DullesRobotics/ComputerAidedDesign/2021-22/FTC/#13822 Robovikes/Pictures/Drivetrain_Final_Assembly_Left.bmp

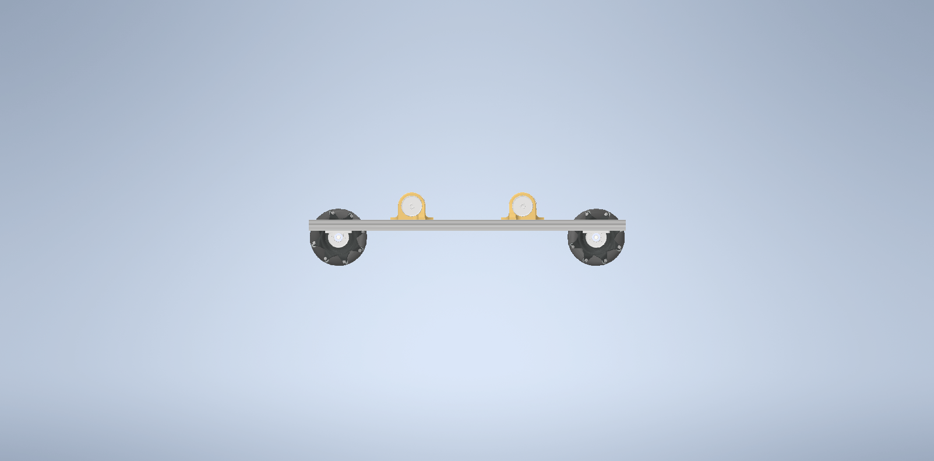
2021-22/FTC/#13822 Robovikes/Pictures/Drivetrain_Final_Assembly_Left.bmp
