DullesRobotics/ComputerAidedDesign/README.md

# ComputerAidedDesign
Anything and everything related to computer aided design
