DullesRobotics/ComputerAidedDesign/2021-22/FTC/#13822 Robovikes/Duck Carousel/Duck Carousel Isometric.jpg

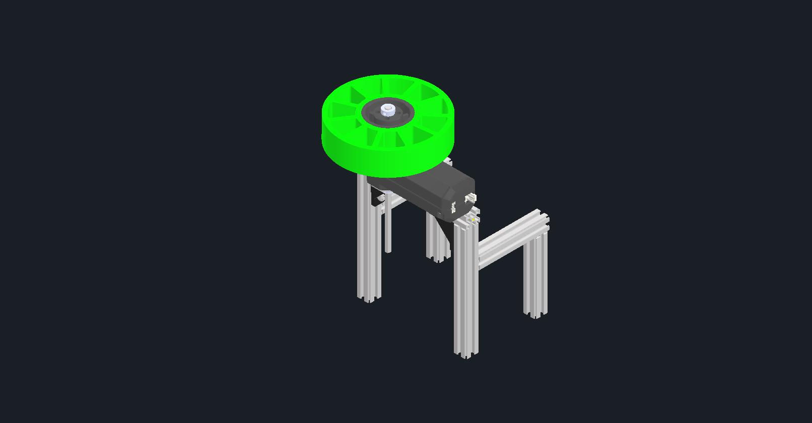
2021-22/FTC/#13822 Robovikes/Duck Carousel/Duck Carousel Isometric.jpg
