DullesRobotics/ComputerAidedDesign/2021-22/FTC/#13822 Robovikes/Duck Carousel/Duck Carousel Top.jpg

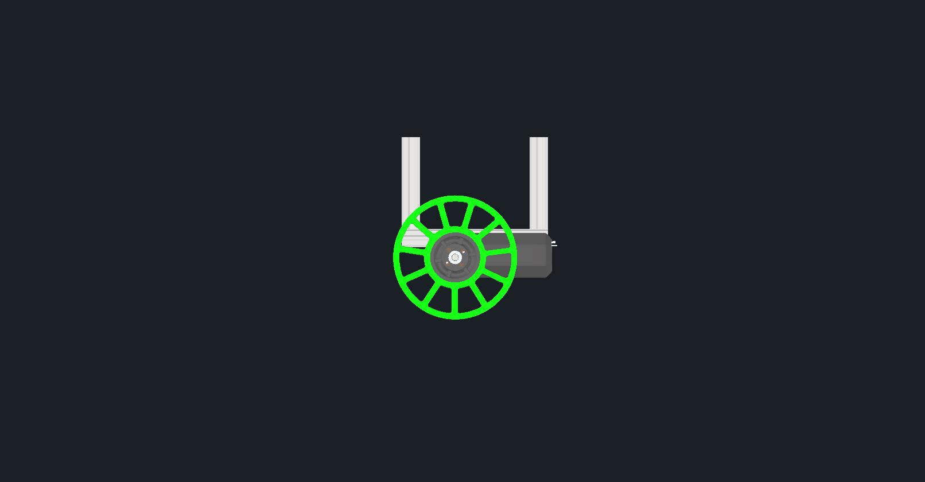
2021-22/FTC/#13822 Robovikes/Duck Carousel/Duck Carousel Top.jpg
