DullesRobotics/ComputerAidedDesign/2021-22/FTC/#13822 Robovikes/Intake/Intake Isometric.jpg

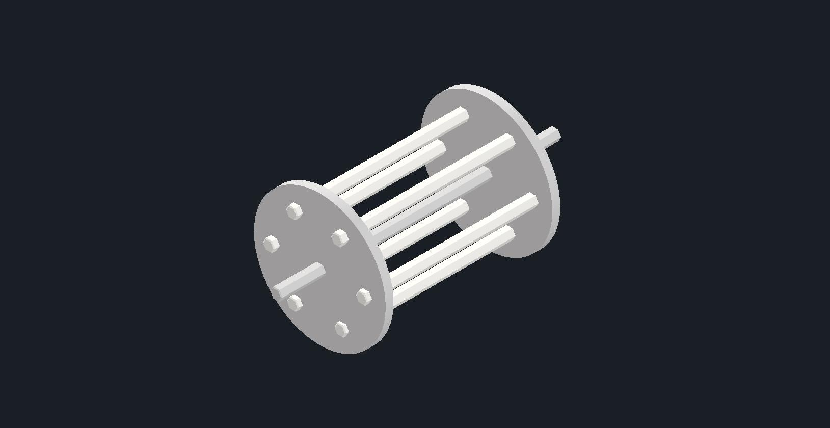
2021-22/FTC/#13822 Robovikes/Intake/Intake Isometric.jpg
