DullesRobotics/ComputerAidedDesign/2021-22/FTC/#13822 Robovikes/Pictures/Drivetrain_Drawing.jpg

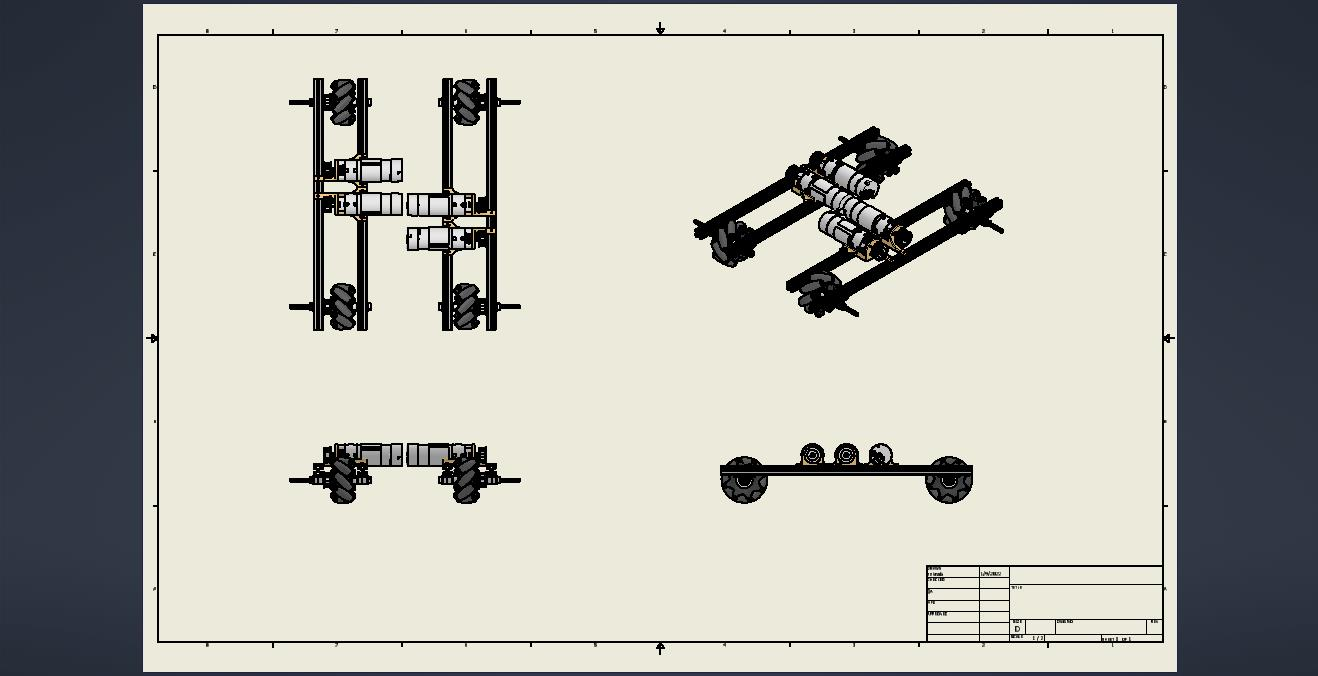
2021-22/FTC/#13822 Robovikes/Pictures/Drivetrain_Drawing.jpg
