DullesRobotics/ComputerAidedDesign/2021-22/FTC/#13822 Robovikes/Sketches and Whiteboarding/Carousel Design.png

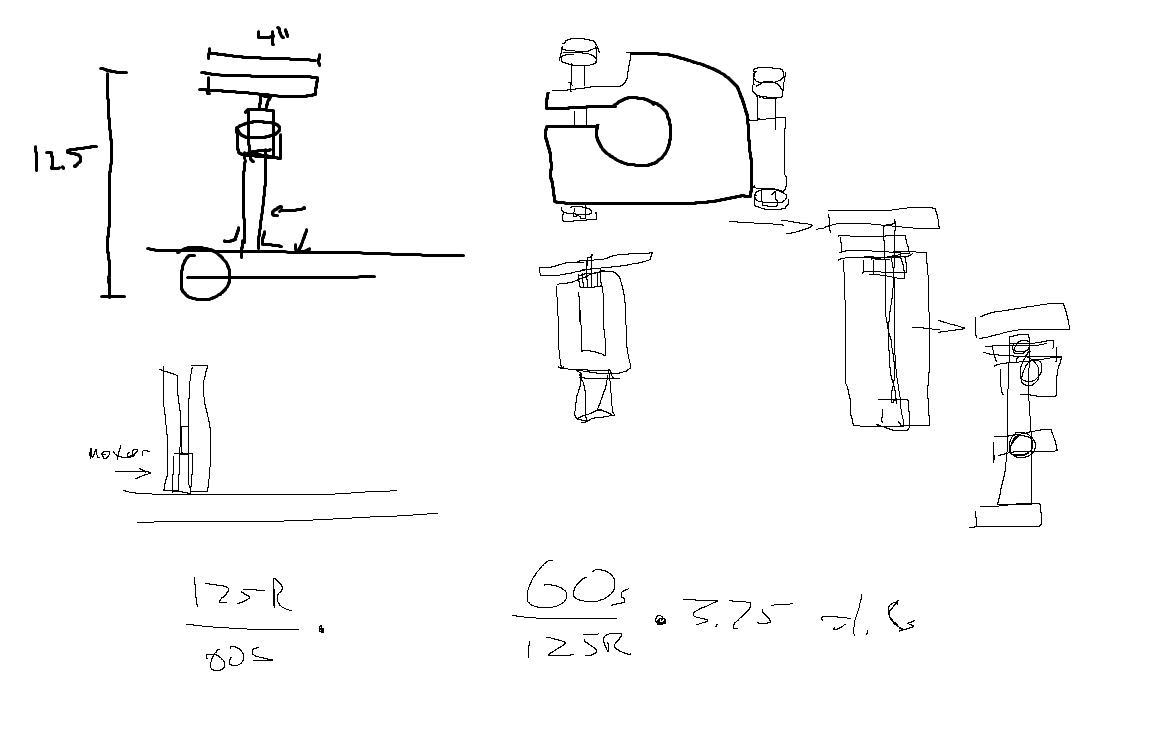
2021-22/FTC/#13822 Robovikes/Sketches and Whiteboarding/Carousel Design.png
