DullesRobotics/ComputerAidedDesign/2021-22/FTC/Parts/AndyMark/am-3684 45t NR Pinion Gear Assembly.STEP

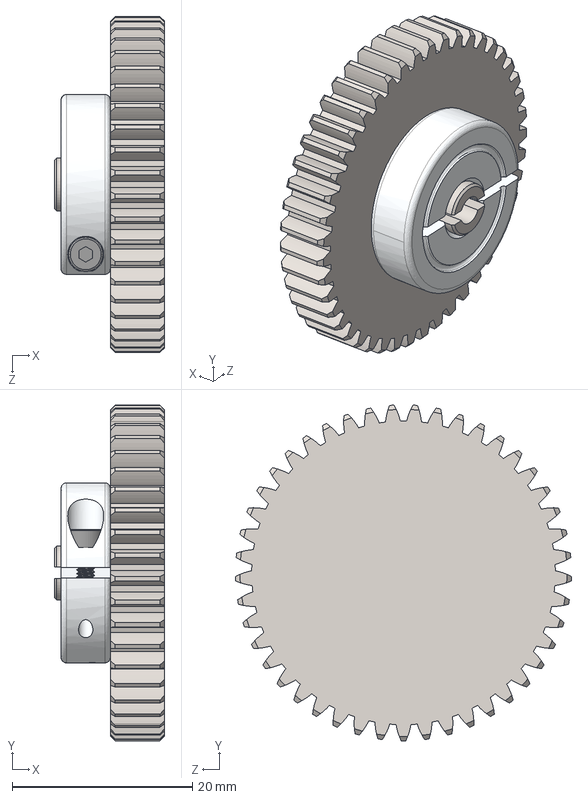
[picture p10: CAD file, 2021-09-24]
2021-22/FTC/Parts/AndyMark/am-3684 45t NR Pinion Gear Assembly.STEP
12.2 x 37.3 x 37.3 mm
45T 32DP 20PA NR Pinion Gear
ENCL20-6MM-A
