DullesRobotics/ComputerAidedDesign/2021-22/FTC/Parts/AndyMark/am-4136 S3 Linear Motion Kit - Single Bearing Assembly.STEP

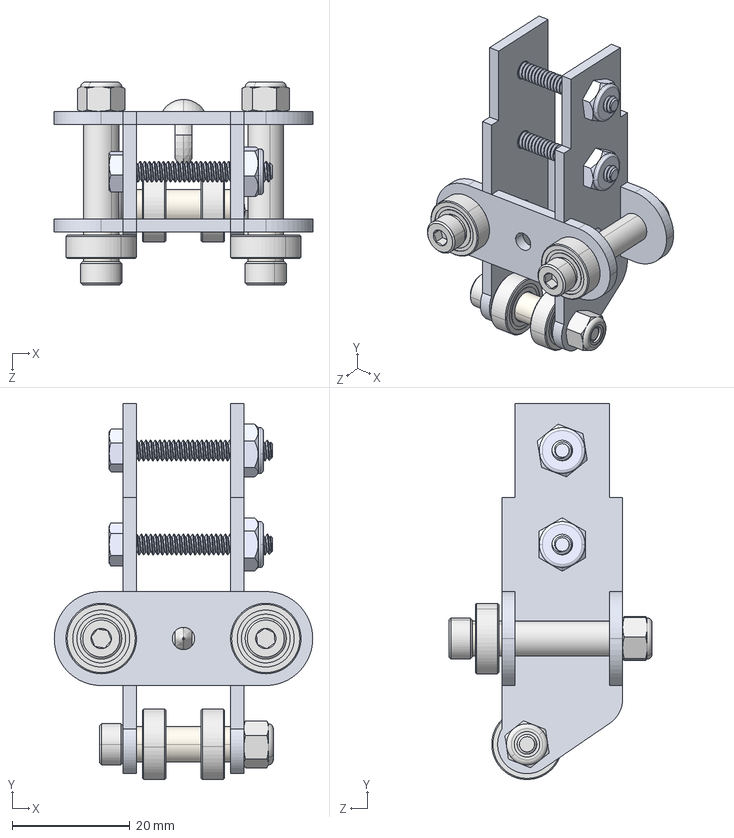
[picture p11: CAD file, 2021-09-24]
2021-22/FTC/Parts/AndyMark/am-4136 S3 Linear Motion Kit - Single Bearing Assembly.STEP
44.0 x 64.0 x 34.6 mm
Bearing Support Bracket x 2
93657A022_NYLON UNTHREADED SPACER_93657A022
6mm x 12mm Non-Flanged_7804K142 x 4
90128A217_ZNC-PLTD ALLOY STL SCKT HEAD CAP SCREW_90128A217
90576A103_ZINC-PLATED CLASS 8 STL NYLON-INSERT LOCKNUT_90576A103 x 3
Tee Bearing Plate x 2
94669A022_ALUM UNTHRD SPACER_94669A022 x 2
90128A219_ZNC-PLTD ALLOY STL SCKT HEAD CAP SCREW_90128A219 x 2
93657A008_NYLON UNTHREADED SPACER_93657A008 x 2
am-1504 S3 Push in Rivet_90218A114
6-32 x 1000 HHCS_93075A153 x 2
6-32 Nylock Jam Nut x 2
