DullesRobotics/ComputerAidedDesign/2021-22/FTC/Parts/AndyMark/am-0293 Shift Block and Shaft Asm.STEP

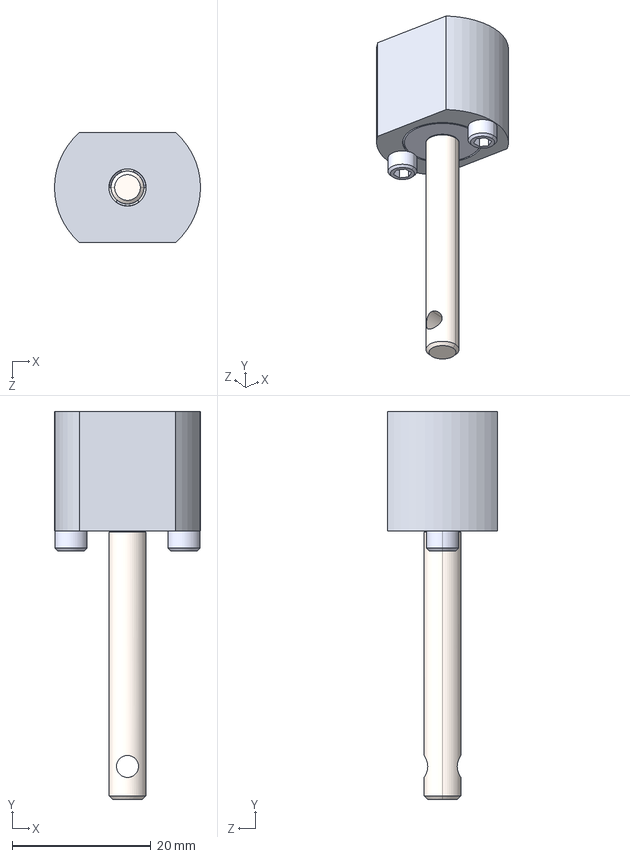
[picture p12: CAD file, 2021-09-24]
2021-22/FTC/Parts/AndyMark/am-0293 Shift Block and Shaft Asm.STEP
21.1 x 56.0 x 15.9 mm
am-0124 Shift Block
am-0170 Shifter Shaft
R3 Bearing
4-40x0500_shcs_smart x 2
0.1875 e-clip_97431A280
