DullesRobotics/ComputerAidedDesign/2021-22/FTC/Parts/AndyMark/am-3964 AM14U4 Vertical Battery Mount Assembly.STEP

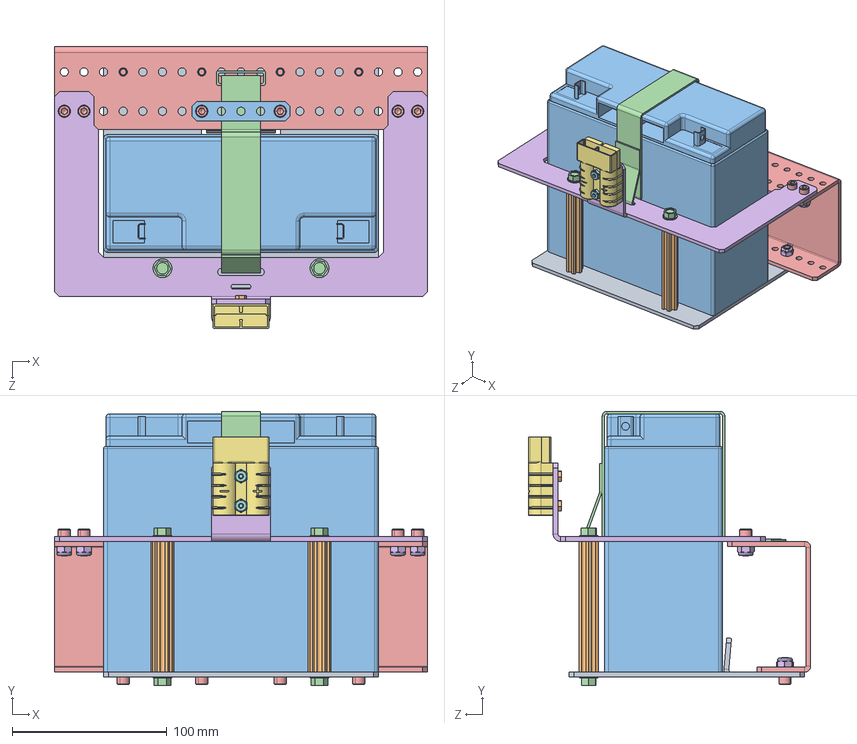
[picture p13: CAD file, 2021-09-24]
2021-22/FTC/Parts/AndyMark/am-3964 AM14U4 Vertical Battery Mount Assembly.STEP
241.3 x 177.5 x 182.8 mm
AM14U3 Battery Floor Plate
3.375in Churro x 2
battery
FHTS 0.25-20-0.75_FHTS 0.25-20-G-0.75-C x 4
10-32x0500_shcs_HX-SHCS 0.19-32x1.375x1-C x 10
10-32 Nylock Nut x 10
Anderson SB50
6-32 Nylock Jam Nut x 2
6-32 x 0750 HHCS_93075A151 x 2
AM14U3 Battery Strap Clamp
Battery Strap
Short End Sheet for Battery Tray
AM14U3 BR19 Battery C Plate
