DullesRobotics/ComputerAidedDesign/2021-22/FTC/Parts/AndyMark/am-0247 GEM Stage 1 assy Rev2.STEP

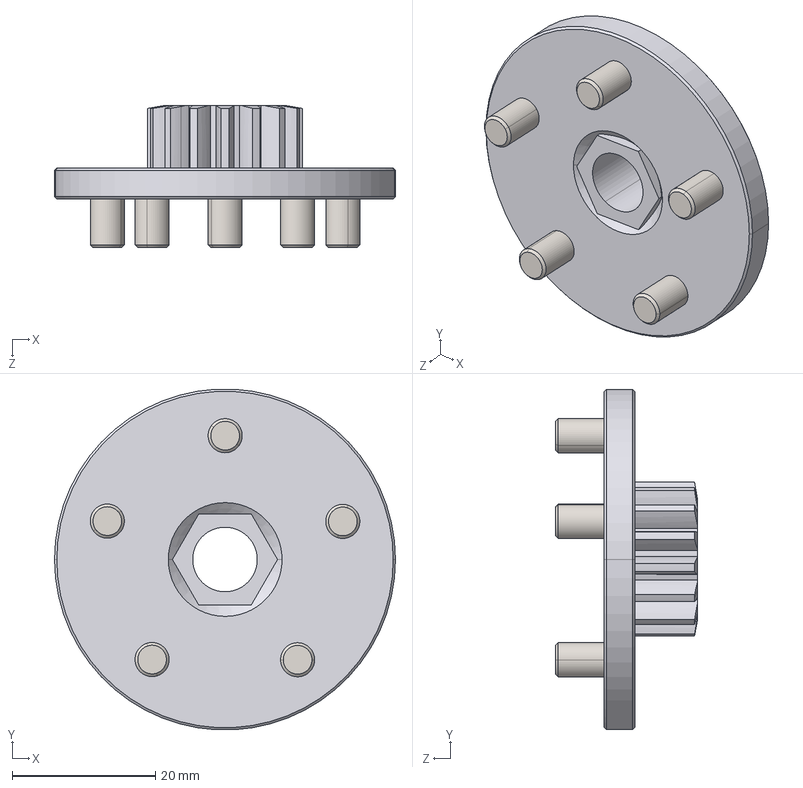
[picture p14: CAD file, 2021-09-24]
2021-22/FTC/Parts/AndyMark/am-0247 GEM Stage 1 assy Rev2.STEP
47.6 x 47.5 x 19.9 mm
GEM Carrier Plate
GEM Dowel x 5
GEM SUN Gear 15t
