DullesRobotics/ComputerAidedDesign/2021-22/FTC/Parts/AndyMark/am-3683 40t NR Pinion Gear Assembly.STEP

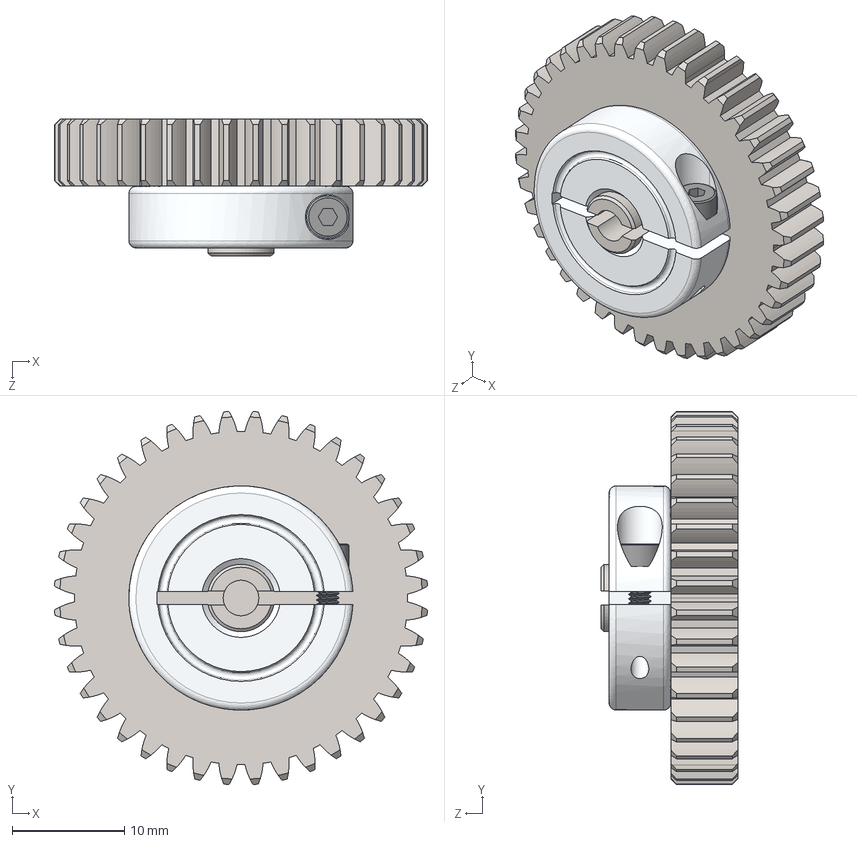
[picture p15: CAD file, 2021-09-24]
2021-22/FTC/Parts/AndyMark/am-3683 40t NR Pinion Gear Assembly.STEP
33.3 x 33.3 x 12.2 mm
dv-9735 40T 32DP 20PA With 0125in Bore Pinion Gear
ENCL20-6MM-A
