DullesRobotics/ComputerAidedDesign/2021-22/FTC/Parts/AndyMark/am-3933 8IN HD Pneumatic Wheel Hub Assembly 1.125 Bearing Bore.STEP

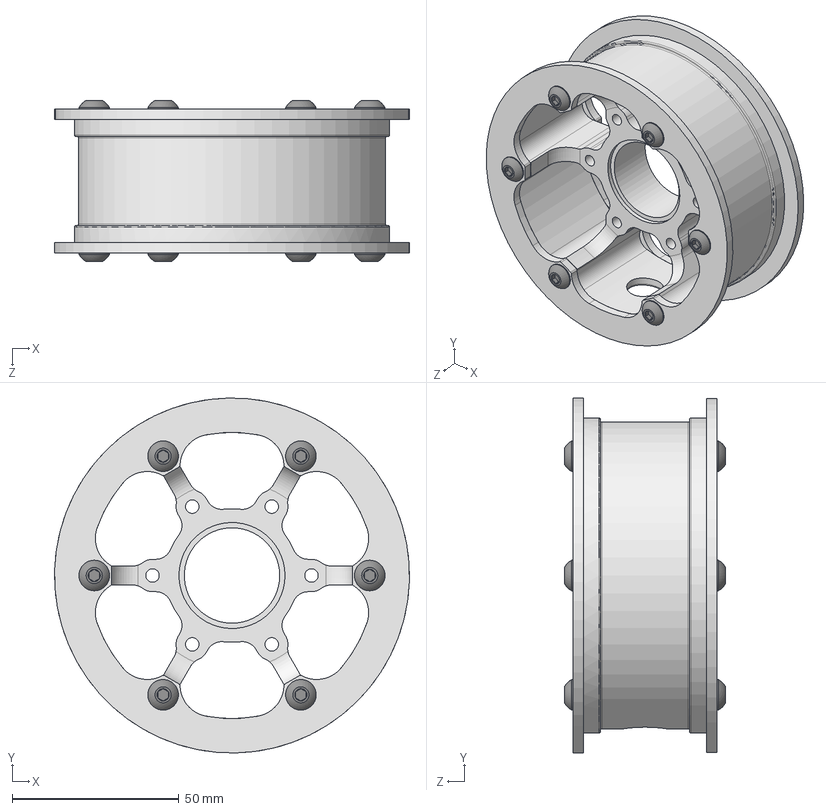
[picture p16: CAD file, 2021-09-24]
2021-22/FTC/Parts/AndyMark/am-3933 8IN HD Pneumatic Wheel Hub Assembly 1.125 Bearing Bore.STEP
106.4 x 106.3 x 48.3 mm
Aluminum 8IN Pneumatic Wheel Core
Aluminum 8IN Pneumatic Wheel Rim x 2
BHCS 10-32 x 0.500_91255A265 x 12
