DullesRobotics/ComputerAidedDesign/2021-22/FTC/Parts/AndyMark/am-2600b FTC Perimeter Corner Assembly.STEP

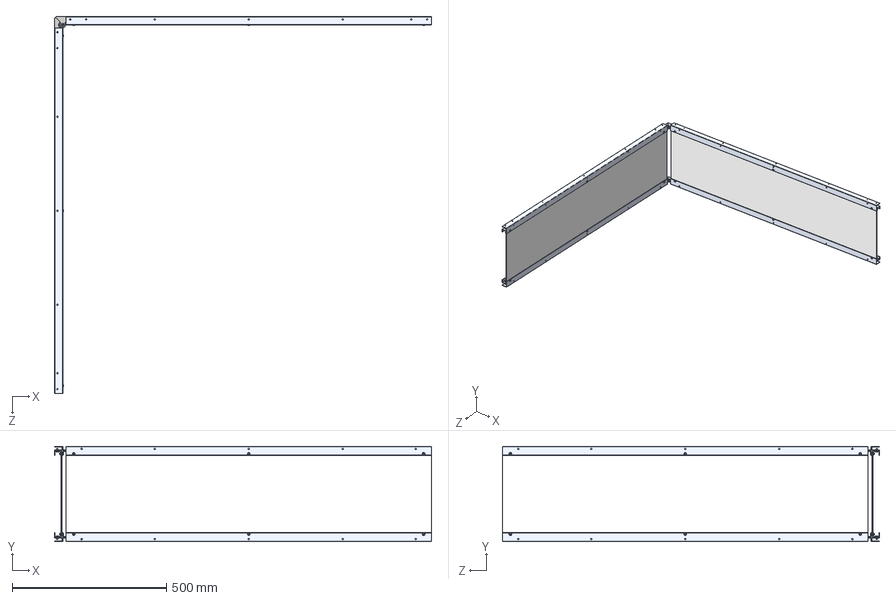
[picture p17: CAD file, 2021-09-24]
2021-22/FTC/Parts/AndyMark/am-2600b FTC Perimeter Corner Assembly.STEP
1222.6 x 309.6 x 1222.6 mm
am-2556 FTC Rail x 4
FTC Field Side Glass 11in x 2
187 pop rivet x 22
Corner Knife Hinge half_DefaultSM-FLAT-PATTERN x 2
am-2589 Corner Knife Hinge half x 2
