DullesRobotics/ComputerAidedDesign/2021-22/FTC/Parts/AndyMark/am-3038 SSS Shift Shaft Assembly REV2.STEP

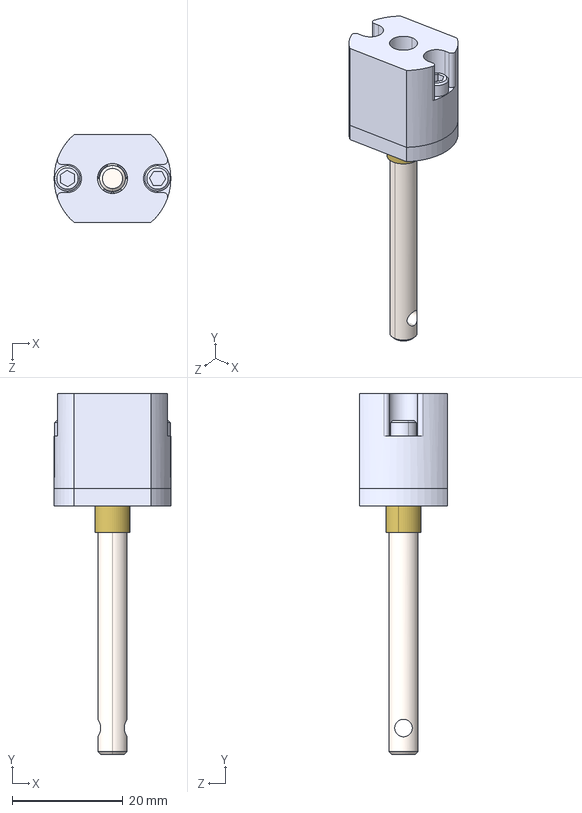
[picture p18: CAD file, 2021-09-24]
2021-22/FTC/Parts/AndyMark/am-3038 SSS Shift Shaft Assembly REV2.STEP
21.1 x 65.2 x 15.9 mm
Shift Block 2
Shift Cap
Shifter Shaft Rev1 3CIM Shifter
0.1875 e-clip_97431A280
R3 Bearing_smart
4-40x0250_shcs_smart x 2
Shift Shaft Spacer am-0300
