DullesRobotics/ComputerAidedDesign/2021-22/FTC/Parts/AndyMark/am-0293 Shift Block and Shaft Assembly.STEP

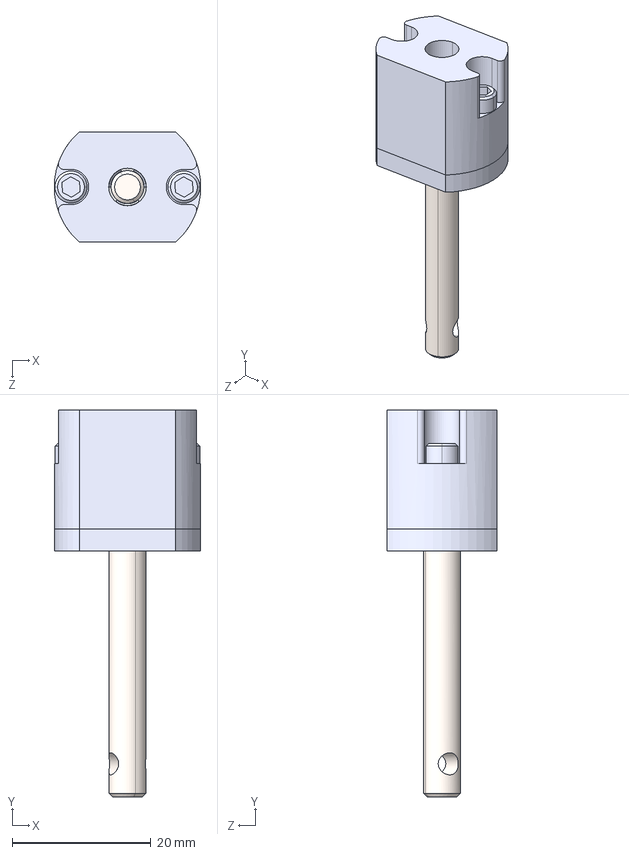
[picture p19: CAD file, 2021-09-24]
2021-22/FTC/Parts/AndyMark/am-0293 Shift Block and Shaft Assembly.STEP
21.1 x 55.7 x 15.9 mm
Shift Block 2
Shift Cap
am-0170 Shifter Shaft Rev1
0.1875 e-clip_97431A280
R3 Bearing_smart
4-40x0250_shcs_smart x 2
