DullesRobotics/ComputerAidedDesign/2021-22/FTC/Parts/AndyMark/am-3968 S3 Linear Motion Main Bracket.STEP

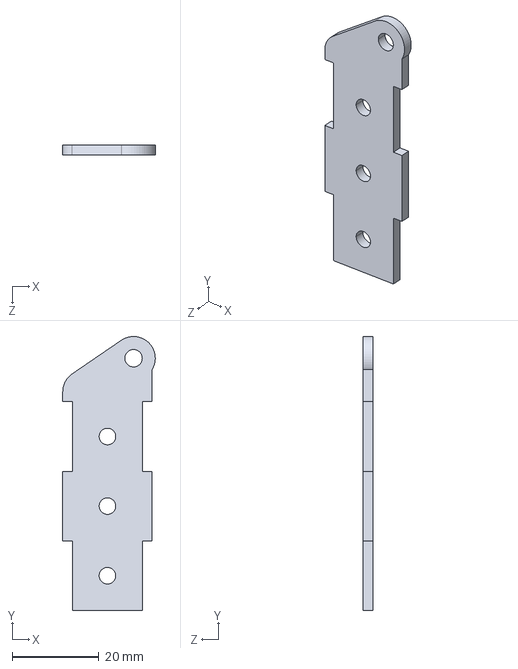
[picture p20: CAD file, 2021-09-24]
2021-22/FTC/Parts/AndyMark/am-3968 S3 Linear Motion Main Bracket.STEP
21.3 x 63.0 x 2.29 mm
