DullesRobotics/ComputerAidedDesign/2021-22/FTC/Parts/AndyMark/am-3964a AM14U4 2020 Battery Mount Assembly.STEP

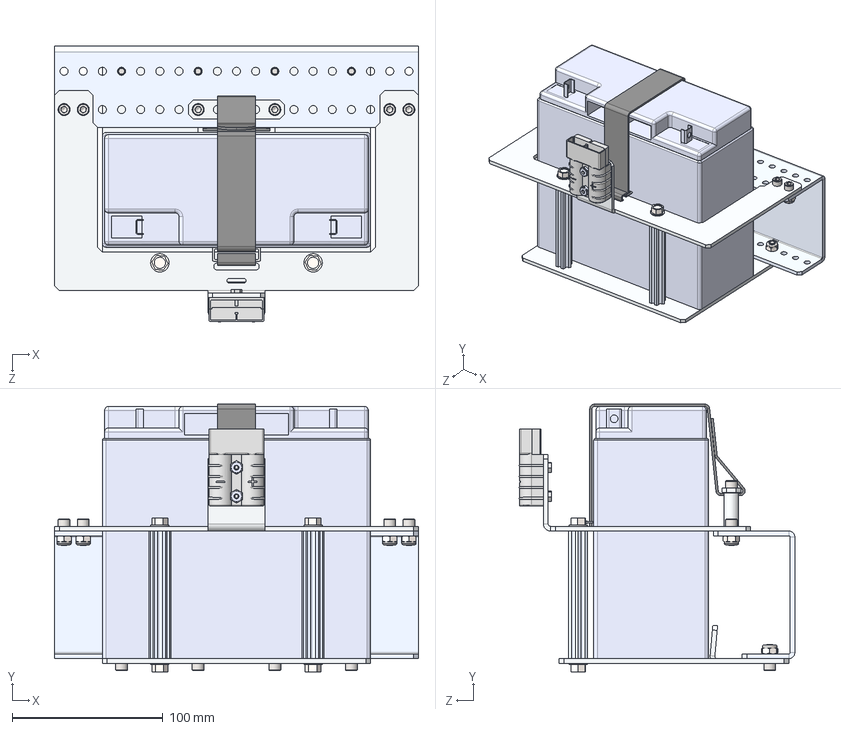
[picture p21: CAD file, 2021-09-24]
2021-22/FTC/Parts/AndyMark/am-3964a AM14U4 2020 Battery Mount Assembly.STEP
241.3 x 177.5 x 182.8 mm
AM14U3 Battery Floor Plate
3.375in Churro x 2
battery
FHTS 0.25-20-0.75_FHTS 0.25-20-G-0.75-C x 4
10-32x0500_shcs_HX-SHCS 0.19-32x1.375x1-C x 8
10-32 Nylock Nut x 10
Anderson SB50
6-32 Nylock Jam Nut x 2
6-32 x 0750 HHCS_93075A151 x 2
Battery Strap V2
Short End Sheet for Battery Tray
AM14U3 BR19 Battery C Plate
am-3876 1000long .192ID Aluminum Spacer x 2
AM14U3 Battery Strap Clamp
10-32x1500_shcs_HX-SHCS 0.19-32x1.375x1-C x 2
