DullesRobotics/ComputerAidedDesign/2021-22/FTC/Parts/AndyMark/am-3682 35t NR Pinion Gear Assembly.STEP

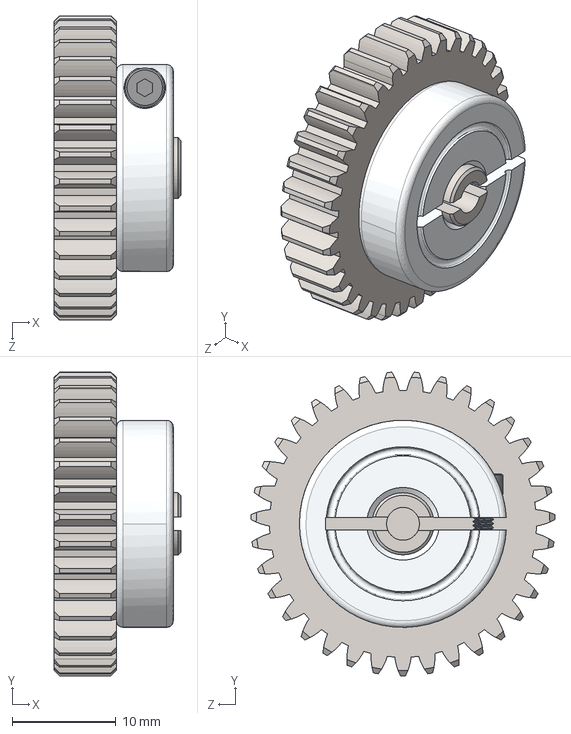
[picture p23: CAD file, 2021-09-24]
2021-22/FTC/Parts/AndyMark/am-3682 35t NR Pinion Gear Assembly.STEP
12.2 x 29.3 x 29.4 mm
35T 32DP 20PA NR Pinion Gear
ENCL20-6MM-A
