DullesRobotics/ComputerAidedDesign/2021-22/FTC/Parts/AndyMark/am-3361R am-3361B Corner Vortex Assembly.STEP

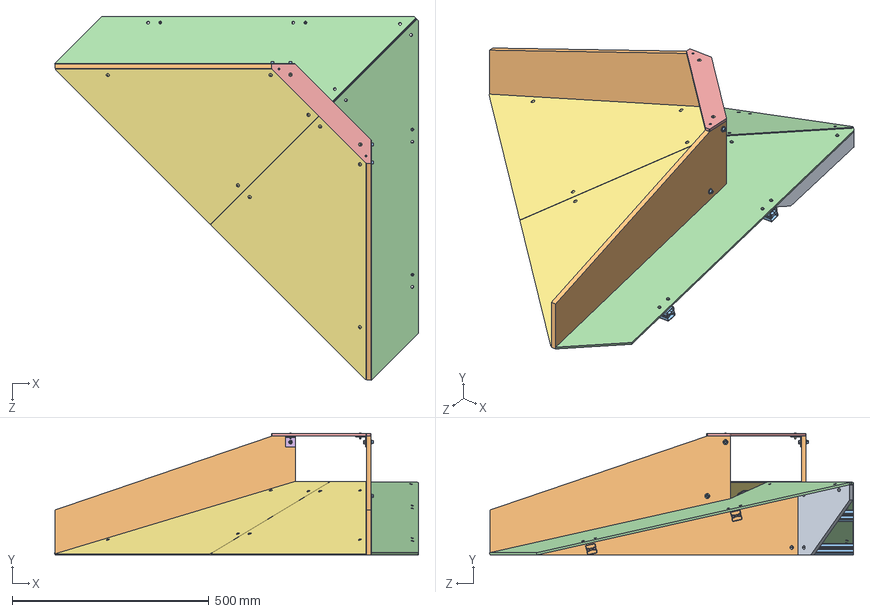
[picture p24: CAD file, 2021-09-24]
2021-22/FTC/Parts/AndyMark/am-3361R am-3361B Corner Vortex Assembly.STEP
924.2 x 309.7 x 924.2 mm
CE Center Spine
CE Main Triangle Support x 2
peanut standoff x 4
CE Ball Return Ramp x 2
CE Goal CrossBar
Bracket 90 - Bolt Bottom x 6
CE ramp Surface half x 2
flat washer type a narrow_ai_Preferred Narrow FW 0.19 x 6
10-32 nylock thin nut - Mcm 90633A009_90633A009 x 8
SHCS 10-32 x 0.75 x 6
10-32x1000_shcs_HX-SHCS 0.19-32x1.375x1-C x 2
FHTS 0.25-20-1_FHTS 0.25-20-F-1.813-C x 8
Bracket 90 - Modified x 4
0125 x 375Rivet x 10
