DullesRobotics/ComputerAidedDesign/2021-22/FTC/Parts/AndyMark/am-2469 6in pneumatic wheel hub assembly.STEP

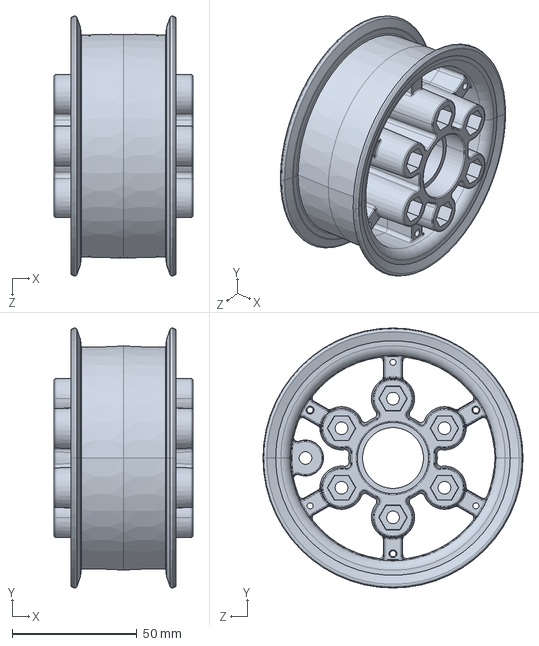
[picture p25: CAD file, 2021-09-24]
2021-22/FTC/Parts/AndyMark/am-2469 6in pneumatic wheel hub assembly.STEP
55.6 x 104.2 x 104.2 mm
6 Hub x 2
