DullesRobotics/ComputerAidedDesign/2021-22/FTC/Parts/AndyMark/am-3934 8IN HD Pneumatic Wheel Hub Assembly 500IN Hex Bore.STEP

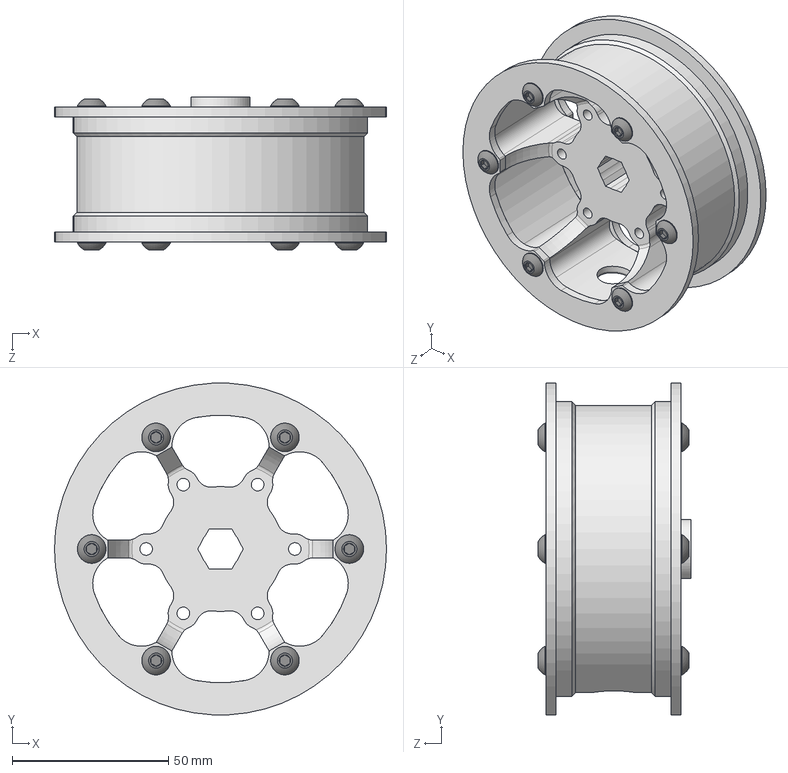
[picture p26: CAD file, 2021-09-24]
2021-22/FTC/Parts/AndyMark/am-3934 8IN HD Pneumatic Wheel Hub Assembly 500IN Hex Bore.STEP
106.4 x 106.2 x 48.9 mm
Aluminum 8IN Pneumatic Wheel 500IN Hex BoreCore
Aluminum 8IN Pneumatic Wheel Rim x 2
BHCS 10-32 x 0.500_91255A265 x 12
