DullesRobotics/ComputerAidedDesign/2021-22/FRC/STL Files/FRC Pit Hookv3.stl

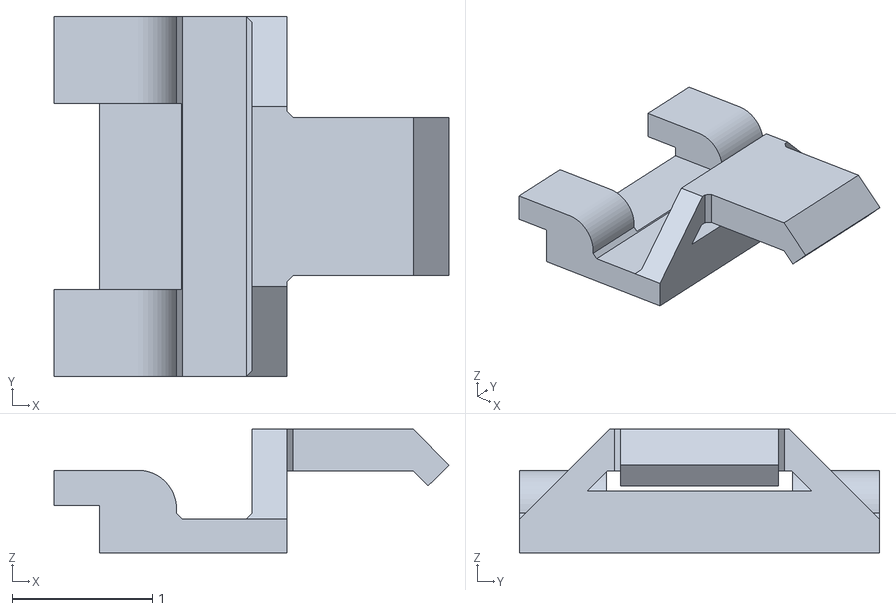
[picture p27: CAD file, 2021-10-08]
2021-22/FRC/STL Files/FRC Pit Hookv3.stl
2.82 x 2.57 x 0.884
