DullesRobotics/ComputerAidedDesign/2021-22/FTC/#12456 Big Red/Proof of Concept/Pulley because david still hates it.stl

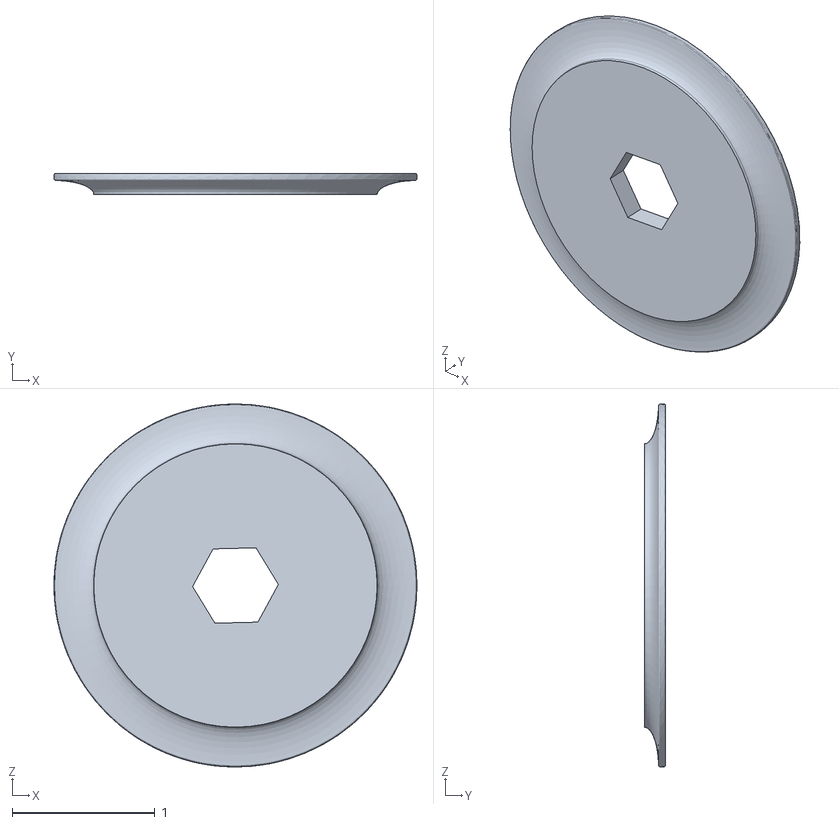
[picture p28: CAD file, 2022-01-26]
2021-22/FTC/#12456 Big Red/Proof of Concept/Pulley because david still hates it.stl
2.54 x 0.15 x 2.54
