DullesRobotics/ComputerAidedDesign/2021-22/FTC/#12456 Big Red/STL Files/Stationary bracket V2.stl

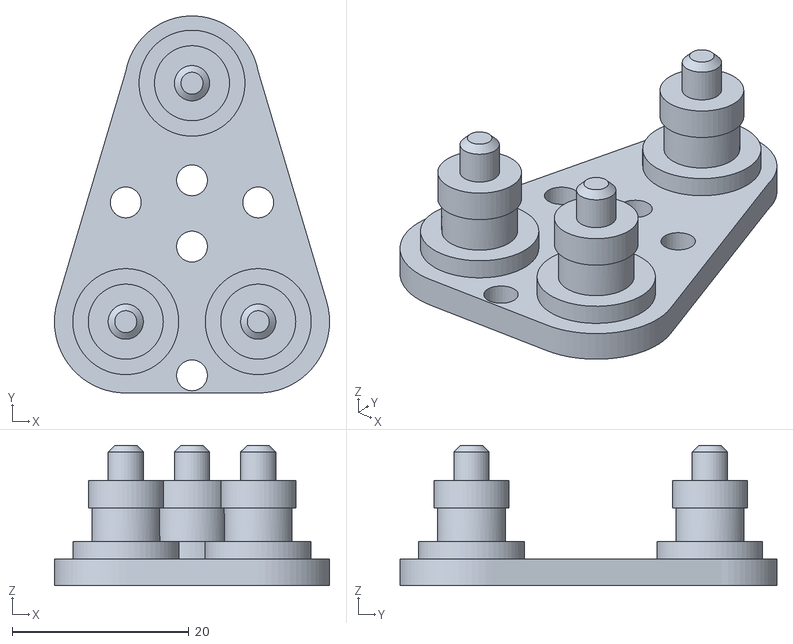
[picture p29: CAD file, 2022-02-04]
2021-22/FTC/#12456 Big Red/STL Files/Stationary bracket V2.stl
31.2 x 42.7 x 15.9
