DullesRobotics/ComputerAidedDesign/2021-22/FTC/#13822 Robovikes/Intake/5mm x 135mm Hex Shaft - 4 Pack.STEP

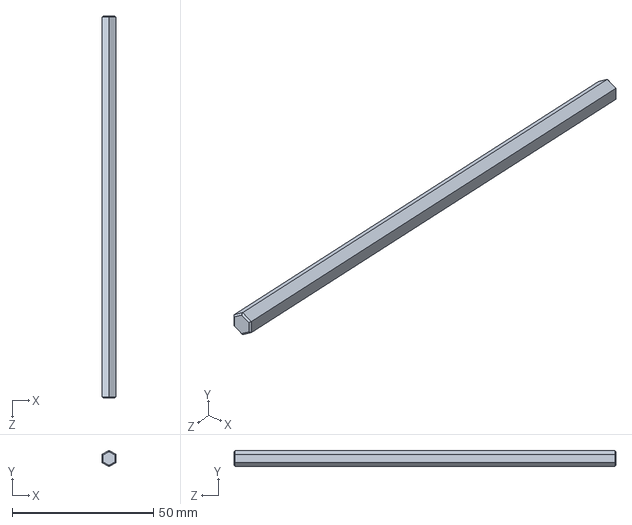
[picture p30: CAD file, 2021-09-05]
2021-22/FTC/#13822 Robovikes/Intake/5mm x 135mm Hex Shaft - 4 Pack.STEP
5.00 x 5.77 x 135.0 mm
