DullesRobotics/ComputerAidedDesign/2021-22/FTC/#13822 Robovikes/Proof of Concept/13in^3 drivetrain parts/10 Tooth #25 D-Shaft Sprocket - 4 Pack.stl

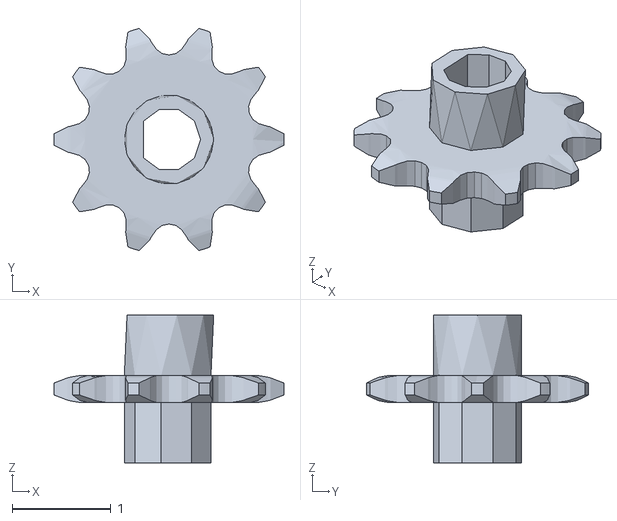
[picture p31: CAD file, 2021-11-07]
2021-22/FTC/#13822 Robovikes/Proof of Concept/13in^3 drivetrain parts/10 Tooth #25 D-Shaft Sprocket - 4 Pack.stl
2.33 x 2.26 x 1.50
