DullesRobotics/ComputerAidedDesign/2021-22/FTC/#13822 Robovikes/Proof of Concept/Motor_Mount_v1.step

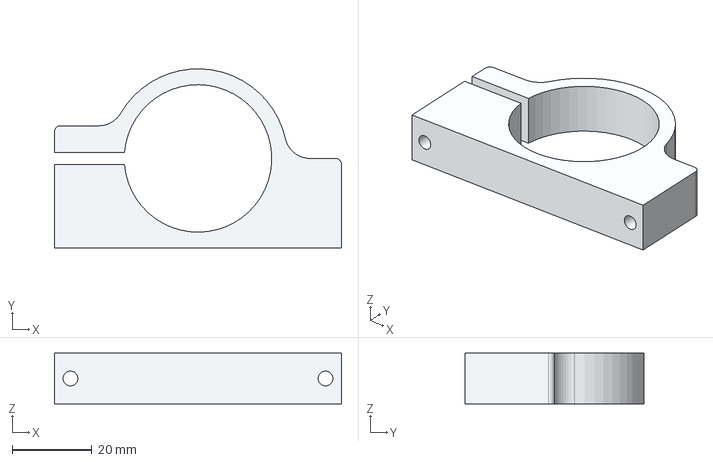
[picture p32: CAD file, 2021-10-01]
2021-22/FTC/#13822 Robovikes/Proof of Concept/Motor_Mount_v1.step
72.0 x 45.0 x 12.7 mm
