DullesRobotics/ComputerAidedDesign/2021-22/FTC/#13822 Robovikes/STL & Gcode Files/V1 NeveRest 20 Orbital Mount.stl

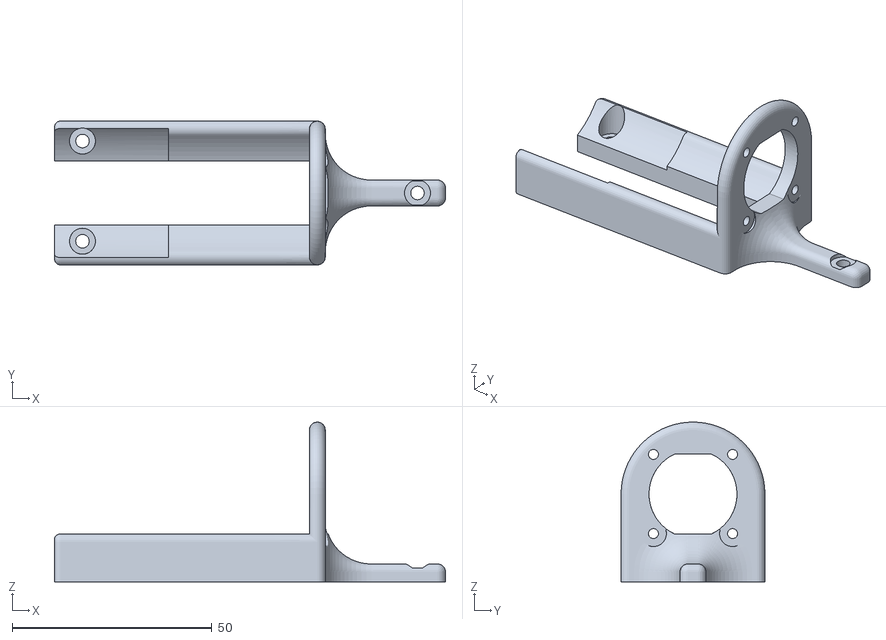
[picture p33: CAD file, 2021-11-07]
2021-22/FTC/#13822 Robovikes/STL & Gcode Files/V1 NeveRest 20 Orbital Mount.stl
97.8 x 36.0 x 40.0
