DullesRobotics/ComputerAidedDesign/2021-22/FTC/Parts/AndyMark/am-4538 4IN 5mm Hex Compliant Wheel.STEP

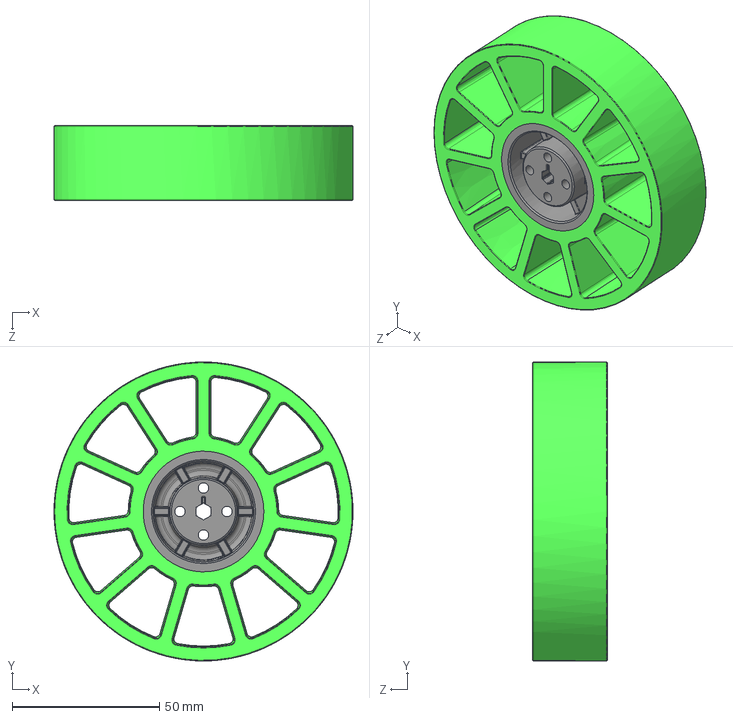
[picture p34: CAD file, 2021-10-10]
2021-22/FTC/Parts/AndyMark/am-4538 4IN 5mm Hex Compliant Wheel.STEP
101.6 x 101.6 x 25.4 mm
