DullesRobotics/ComputerAidedDesign/2021-22/FTC/Parts/Custom Parts/5202 Series Yellow Jacket planetary Gear Small Motor Mount.stl

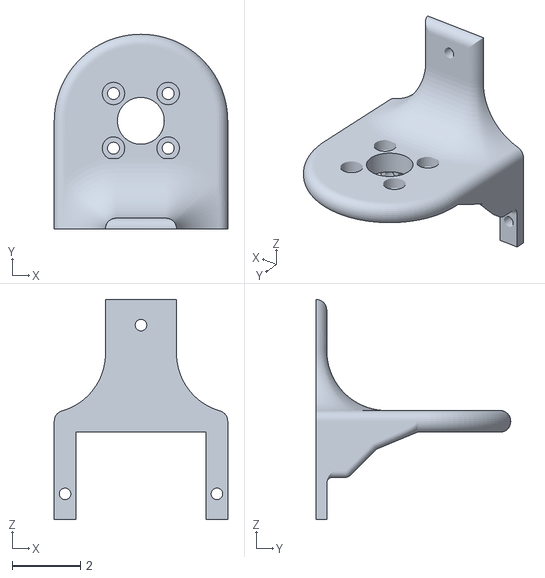
[picture p35: CAD file, 2021-12-08]
2021-22/FTC/Parts/Custom Parts/5202 Series Yellow Jacket planetary Gear Small Motor Mount.stl
5.08 x 5.69 x 6.44
