DullesRobotics/ComputerAidedDesign/2021-22/FTC/Parts/REV Parts/15mm Metal T Bracket V2 - 8 Pack.STEP

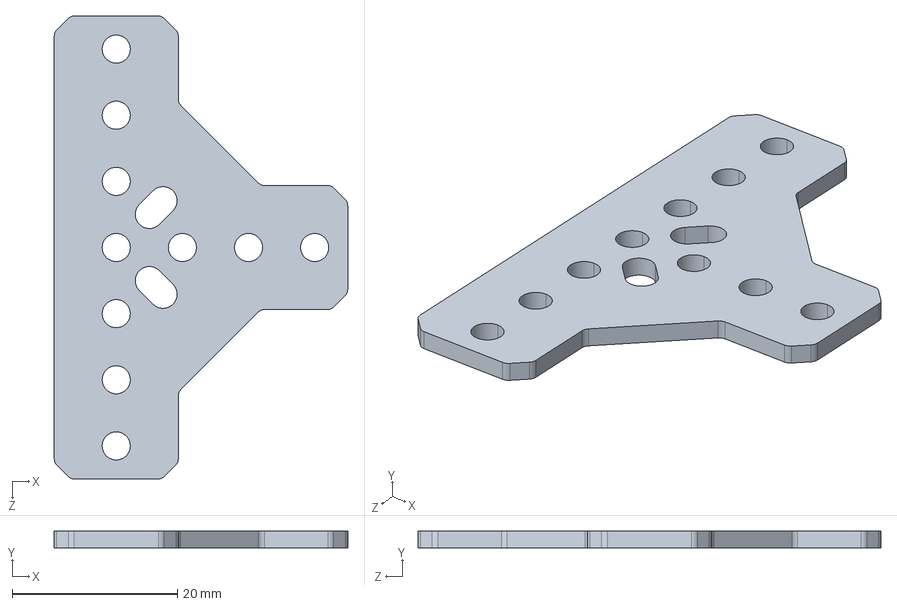
[picture p36: CAD file, 2021-09-05]
2021-22/FTC/Parts/REV Parts/15mm Metal T Bracket V2 - 8 Pack.STEP
35.5 x 2.00 x 56.0 mm
