DullesRobotics/ComputerAidedDesign/2021-22/FTC/#13822 Robovikes/STL & Gcode Files/10 Tooth #25 D-Shaft Sprocket - 4 Pack.stl

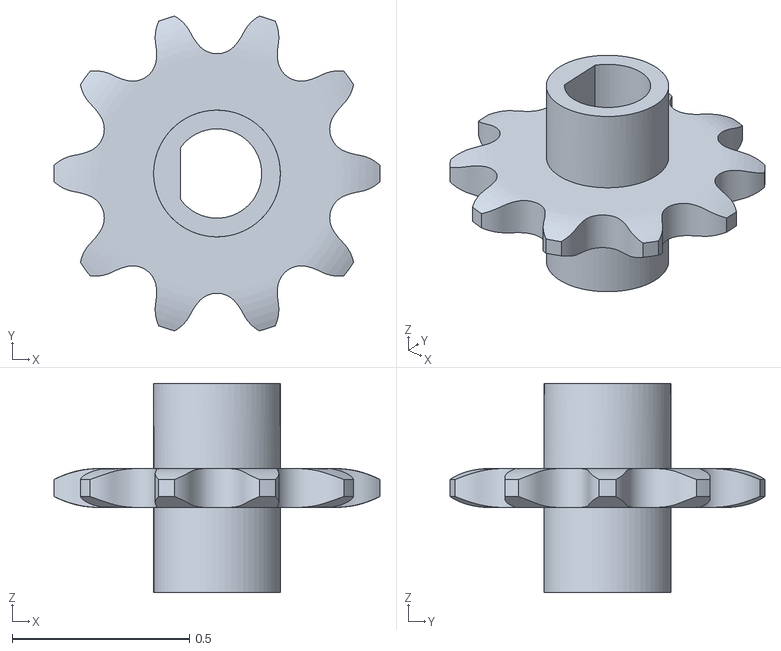
[picture p38: CAD file, 2021-10-08]
2021-22/FTC/#13822 Robovikes/STL & Gcode Files/10 Tooth #25 D-Shaft Sprocket - 4 Pack.stl
0.919 x 0.888 x 0.591
