DullesRobotics/ComputerAidedDesign/2021-22/FTC/Parts/AndyMark/am-4042a Barrier Pipe Anchor.STEP

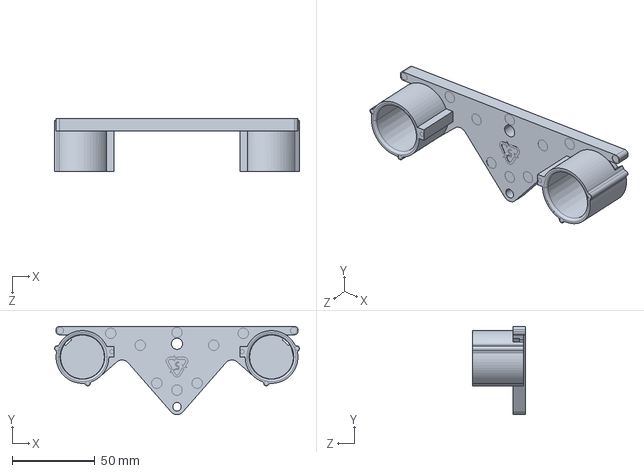
[picture p39: CAD file, 2021-10-03]
2021-22/FTC/Parts/AndyMark/am-4042a Barrier Pipe Anchor.STEP
148.3 x 53.4 x 32.4 mm
