DullesRobotics/ComputerAidedDesign/2021-22/FTC/Parts/Custom Parts/Gobilda 1620 motor mount.stl

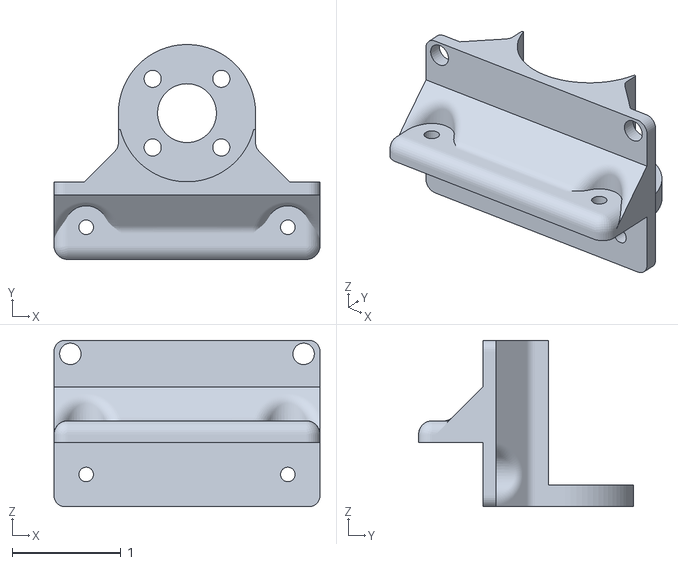
[picture p40: CAD file, 2021-12-08]
2021-22/FTC/Parts/Custom Parts/Gobilda 1620 motor mount.stl
2.44 x 1.97 x 1.53
