DullesRobotics/ComputerAidedDesign/2021-22/FTC/Parts/REV Parts/45mm x 15mm C Channel - 248mm.STEP

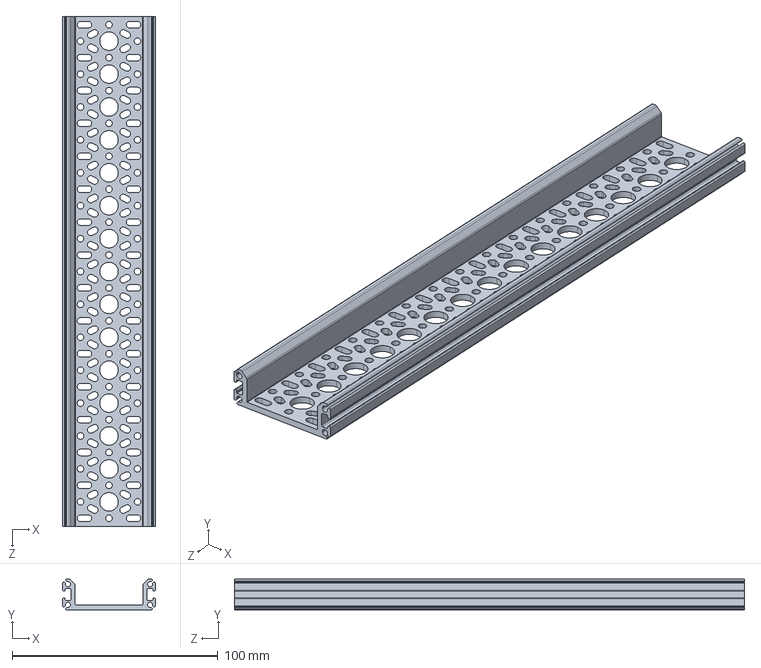
[picture p41: CAD file, 2021-09-05]
2021-22/FTC/Parts/REV Parts/45mm x 15mm C Channel - 248mm.STEP
45.0 x 15.0 x 248.0 mm
