DullesRobotics/ComputerAidedDesign/2021-22/FRC/STL Files/FRC Pit Hook.stl

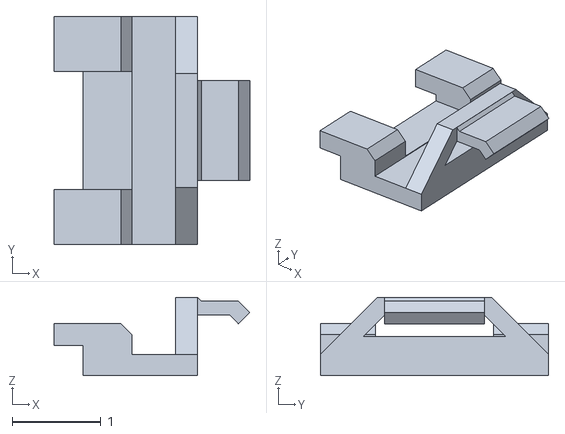
[picture p42: CAD file, 2021-10-08]
2021-22/FRC/STL Files/FRC Pit Hook.stl
2.20 x 2.57 x 0.884
