DullesRobotics/ComputerAidedDesign/2021-22/FTC/Parts/AndyMark/am-3104_ne NeveRest Motor No Encoder.STEP

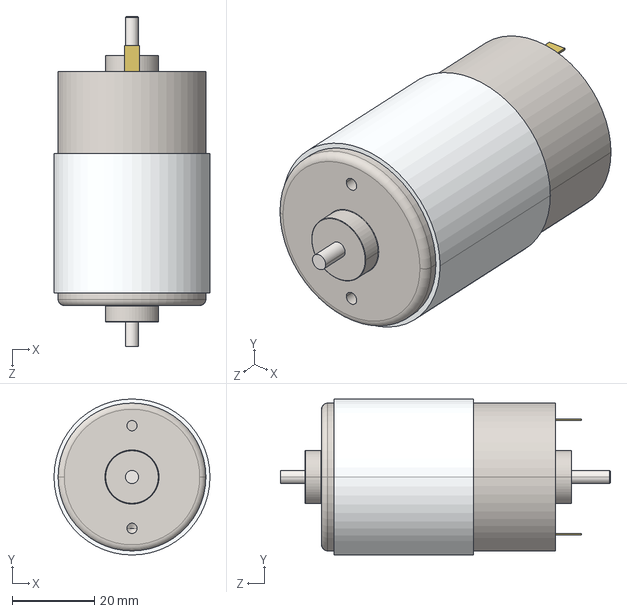
[picture p43: CAD file, 2021-09-24]
2021-22/FTC/Parts/AndyMark/am-3104_ne NeveRest Motor No Encoder.STEP
38.0 x 38.0 x 80.4 mm
