DullesRobotics/ComputerAidedDesign/2021-22/FTC/#12456 Big Red/STL Files/Stationary bracket aligner.stl

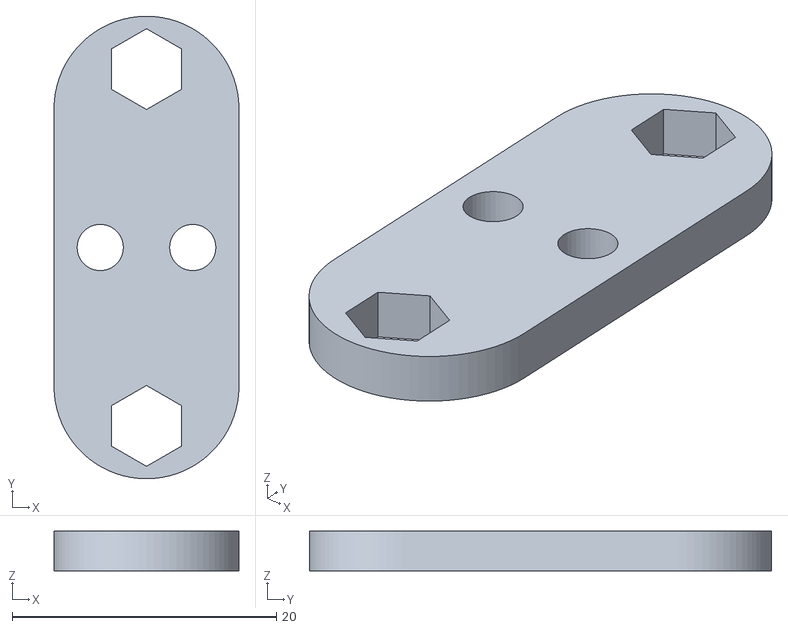
[picture p45: CAD file, 2022-01-31]
2021-22/FTC/#12456 Big Red/STL Files/Stationary bracket aligner.stl
14.0 x 35.0 x 3.00
