DullesRobotics/ComputerAidedDesign/2021-22/FTC/#13822 Robovikes/STL & Gcode Files/V3 5202 Series Yellow Jacket planetary Gear Motor Mount.stl

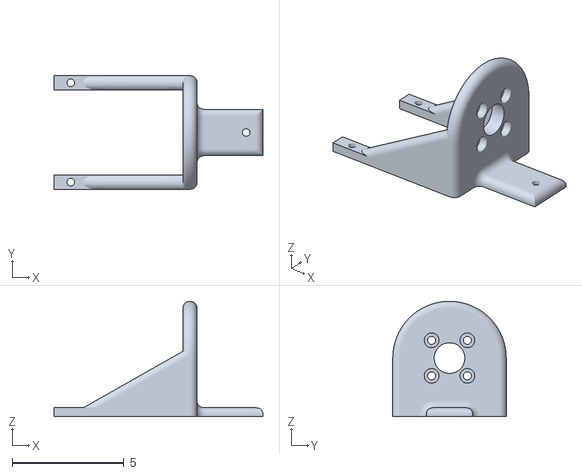
[picture p46: CAD file, 2021-10-05]
2021-22/FTC/#13822 Robovikes/STL & Gcode Files/V3 5202 Series Yellow Jacket planetary Gear Motor Mount.stl
9.35 x 5.08 x 5.16
