DullesRobotics/ComputerAidedDesign/2021-22/FTC/Parts/AndyMark/am-3068 Power Converter 12-24VDC to 5VDC.STEP

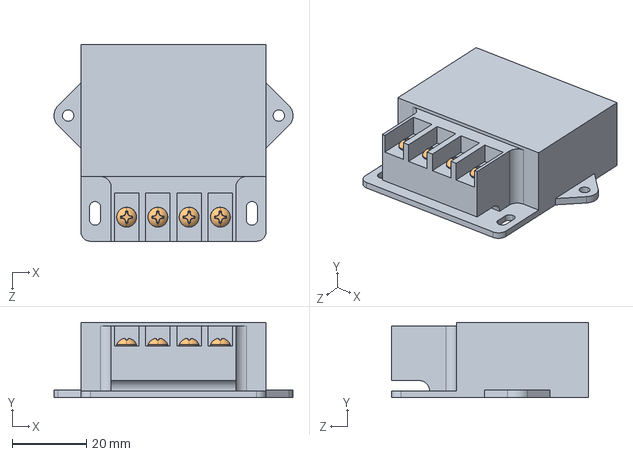
[picture p47: CAD file, 2021-09-24]
2021-22/FTC/Parts/AndyMark/am-3068 Power Converter 12-24VDC to 5VDC.STEP
64.2 x 20.2 x 52.8 mm
