DullesRobotics/ComputerAidedDesign/2021-22/FTC/#12456 Big Red/STL Files/1mm Spacers - 28 Pack.stl

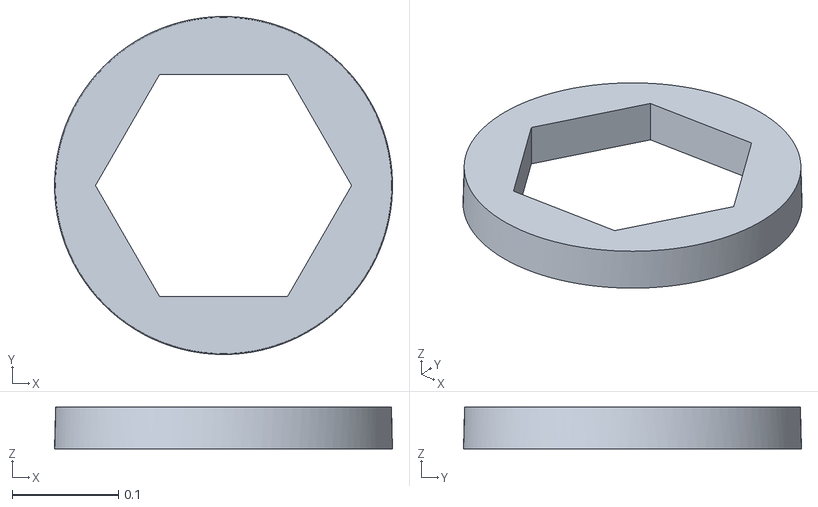
[picture p48: CAD file, 2022-01-31]
2021-22/FTC/#12456 Big Red/STL Files/1mm Spacers - 28 Pack.stl
0.318 x 0.318 x 0.0394
