DullesRobotics/ComputerAidedDesign/2021-22/FTC/Parts/AndyMark/am-0177 24T 20dp 375h REV2.STEP

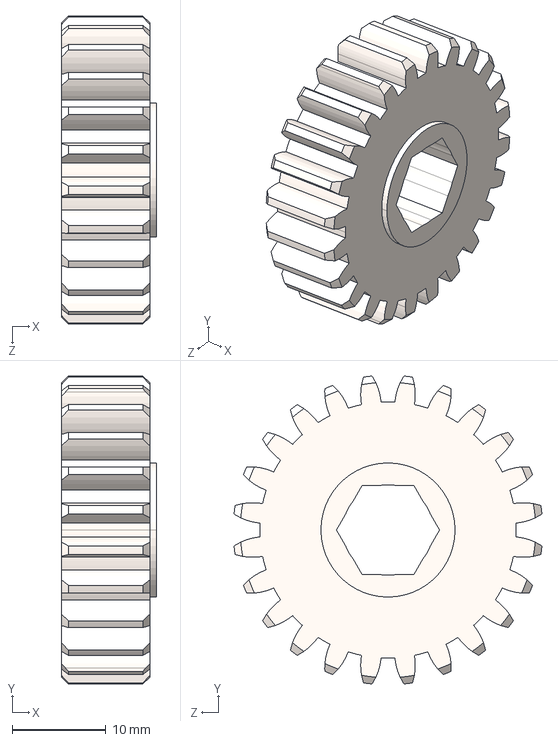
[picture p49: CAD file, 2021-09-24]
2021-22/FTC/Parts/AndyMark/am-0177 24T 20dp 375h REV2.STEP
10.2 x 32.8 x 32.8 mm
