DullesRobotics/ComputerAidedDesign/2021-22/FTC/Parts/REV Parts/Pillow Block.STEP

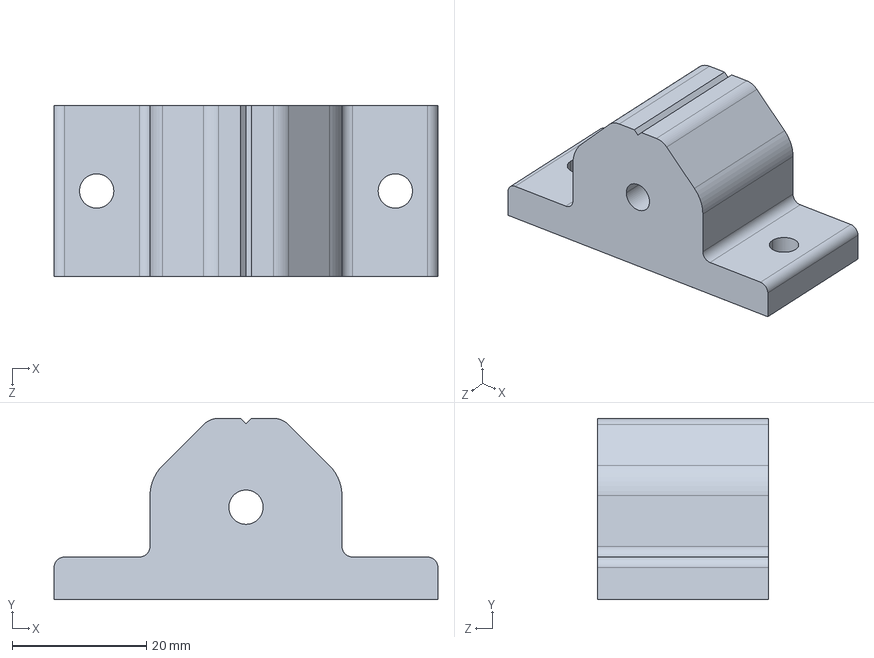
[picture p50: CAD file, 2021-09-05]
2021-22/FTC/Parts/REV Parts/Pillow Block.STEP
57.2 x 27.0 x 25.4 mm
