DullesRobotics/ComputerAidedDesign/2021-22/FTC/Parts/AndyMark/am-4179 Lamprey Absolute Encoder.STEP

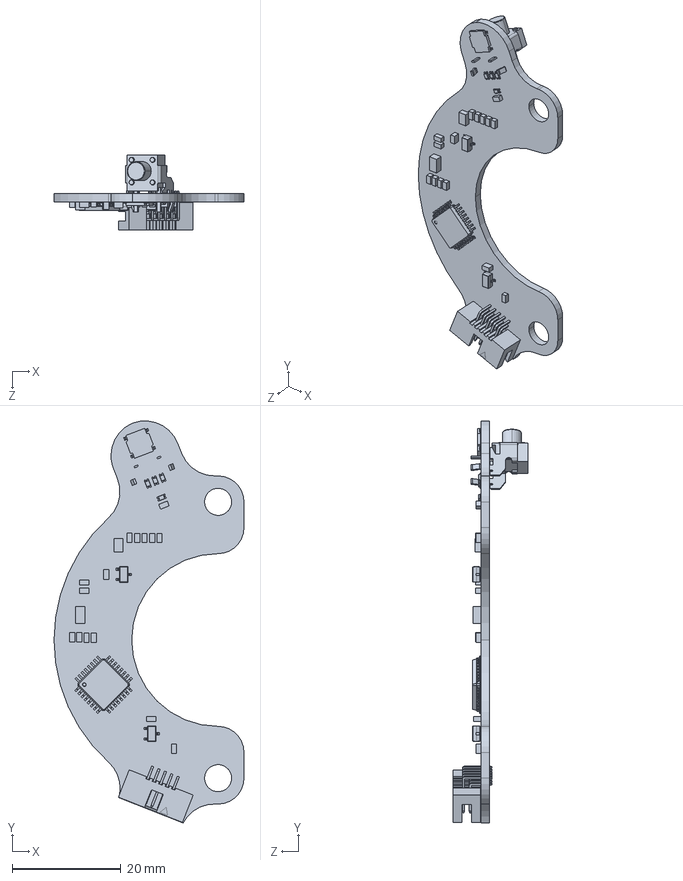
[picture p51: CAD file, 2021-09-24]
2021-22/FTC/Parts/AndyMark/am-4179 Lamprey Absolute Encoder.STEP
34.9 x 73.9 x 13.9 mm
