DullesRobotics/ComputerAidedDesign/2021-22/FTC/#12456 Big Red/STL Files/Pulley because david still hates it.stl

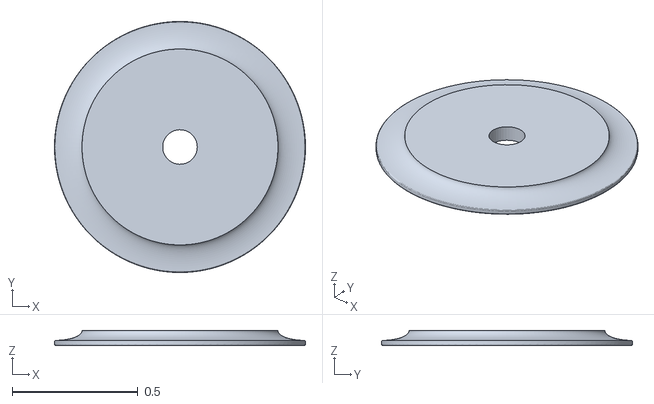
[picture p52: CAD file, 2022-01-26]
2021-22/FTC/#12456 Big Red/STL Files/Pulley because david still hates it.stl
1.00 x 1.00 x 0.0591
