DullesRobotics/ComputerAidedDesign/2021-22/FTC/Parts/AndyMark/am-2036 48 Tooth Aluminum Gear with 500 Hex Bore.STEP

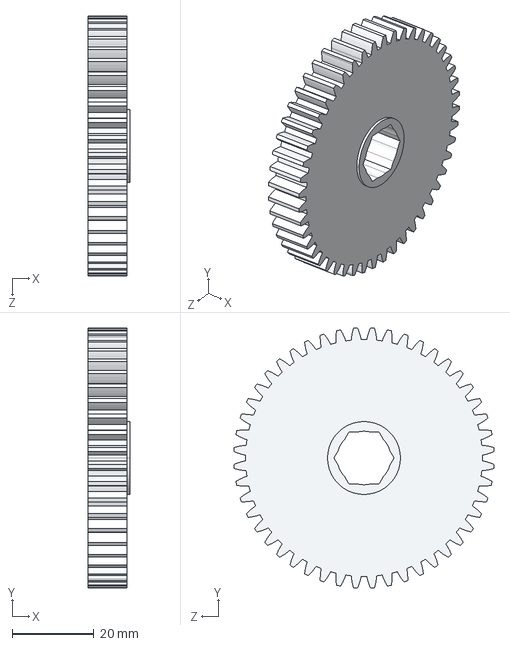
[picture p53: CAD file, 2021-09-24]
2021-22/FTC/Parts/AndyMark/am-2036 48 Tooth Aluminum Gear with 500 Hex Bore.STEP
10.2 x 63.4 x 63.4 mm
