DullesRobotics/ComputerAidedDesign/2021-22/FTC/Parts/REV Parts/15mm Metal Bent Planetary Motor Bracket - 4 Pack.STEP

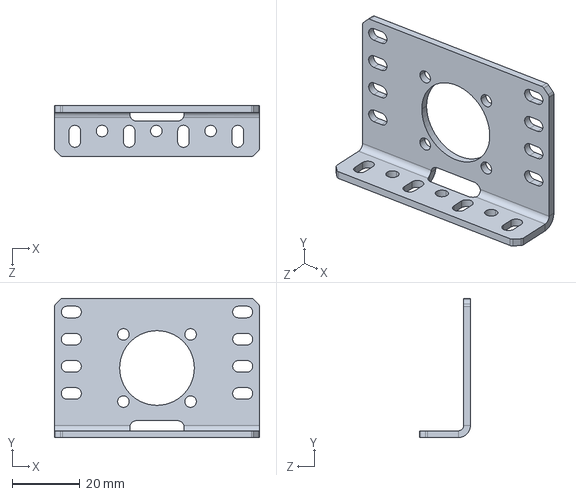
[picture p54: CAD file, 2021-09-05]
2021-22/FTC/Parts/REV Parts/15mm Metal Bent Planetary Motor Bracket - 4 Pack.STEP
60.4 x 41.0 x 15.0 mm
