DullesRobotics/ComputerAidedDesign/2021-22/FTC/Parts/AndyMark/am-0034 14T 20DP 14.5PA 8mm Key Bore Gear.STEP

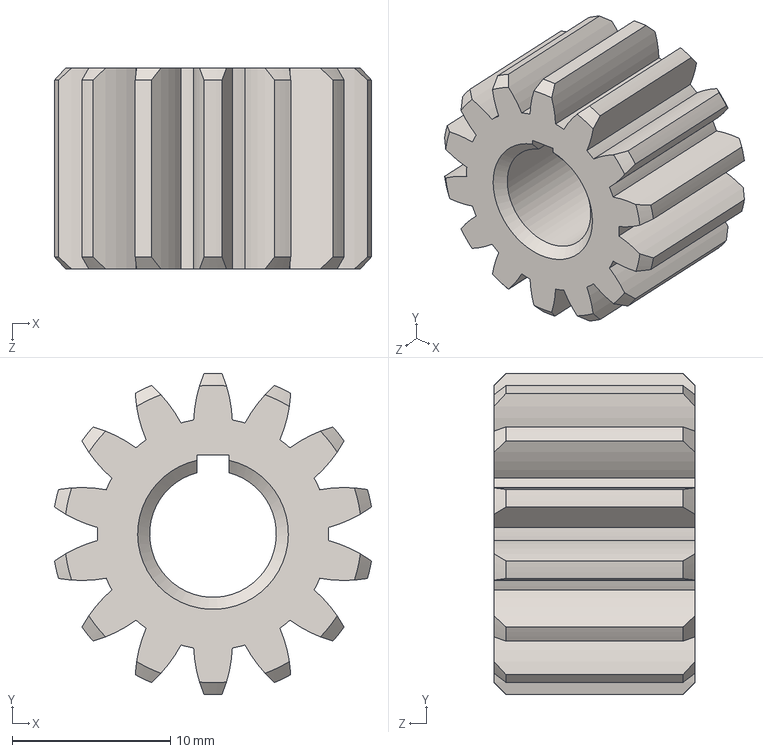
[picture p55: CAD file, 2021-09-24]
2021-22/FTC/Parts/AndyMark/am-0034 14T 20DP 14.5PA 8mm Key Bore Gear.STEP
20.0 x 20.3 x 12.7 mm
