DullesRobotics/ComputerAidedDesign/2021-22/FTC/Parts/REV Parts/15mm Metal 45 Degree Bracket V2 - 8 Pack.STEP

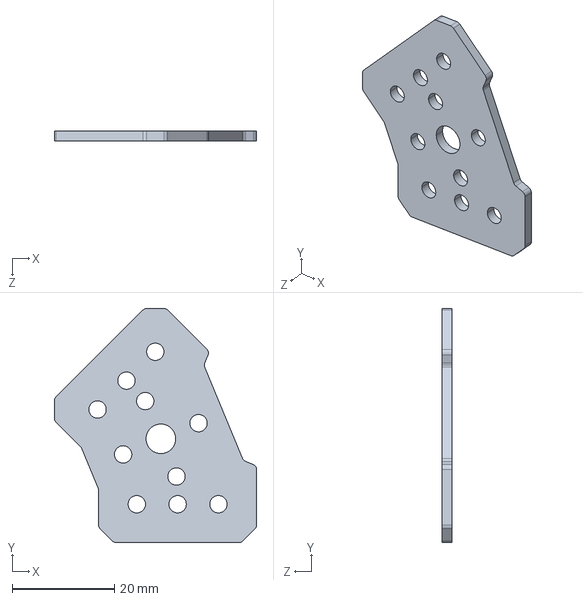
[picture p56: CAD file, 2021-09-05]
2021-22/FTC/Parts/REV Parts/15mm Metal 45 Degree Bracket V2 - 8 Pack.STEP
39.7 x 45.9 x 2.00 mm
