DullesRobotics/ComputerAidedDesign/2021-22/FTC/Parts/AndyMark/am-2906 REV 90 Degree Bracket.STEP

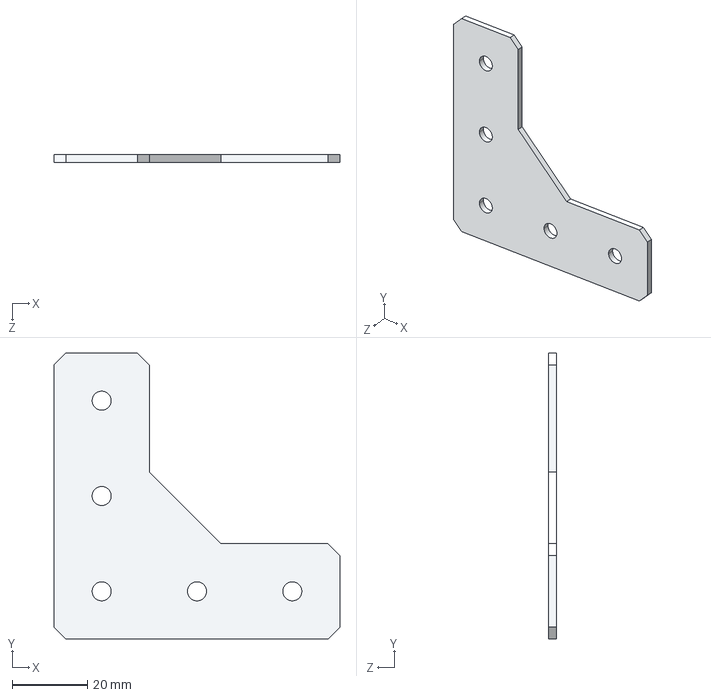
[picture p57: CAD file, 2021-09-24]
2021-22/FTC/Parts/AndyMark/am-2906 REV 90 Degree Bracket.STEP
76.2 x 76.2 x 2.03 mm
