DullesRobotics/ComputerAidedDesign/2021-22/FTC/Parts/REV Parts/Aluminum Double Servo Arm.STEP

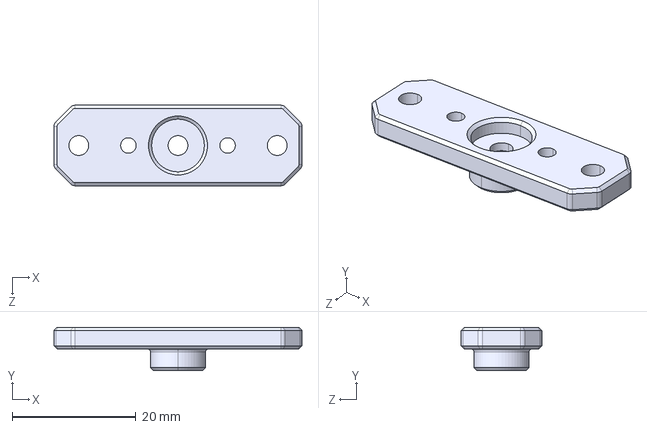
[picture p58: CAD file, 2021-09-05]
2021-22/FTC/Parts/REV Parts/Aluminum Double Servo Arm.STEP
40.0 x 7.00 x 13.0 mm
