DullesRobotics/ComputerAidedDesign/2021-22/FTC/#12456 Big Red/STL Files/Bearing Bushing v2.stl

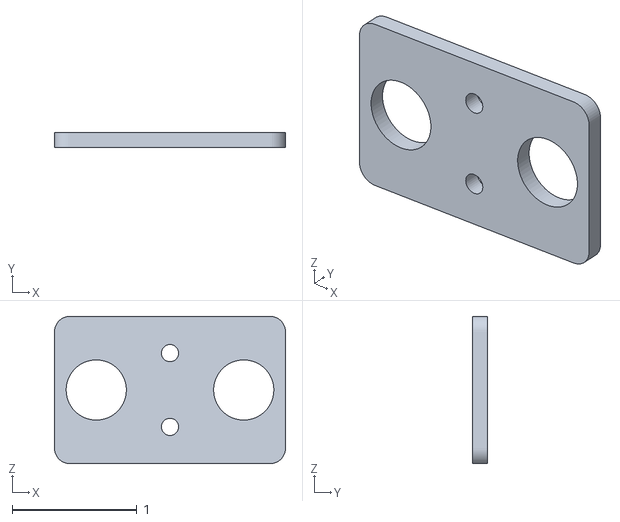
[picture p59: CAD file, 2022-01-19]
2021-22/FTC/#12456 Big Red/STL Files/Bearing Bushing v2.stl
1.85 x 0.118 x 1.18
