DullesRobotics/ComputerAidedDesign/2021-22/FTC/Parts/AndyMark/am-0125 Super Shifter Wheel Shaft.STEP

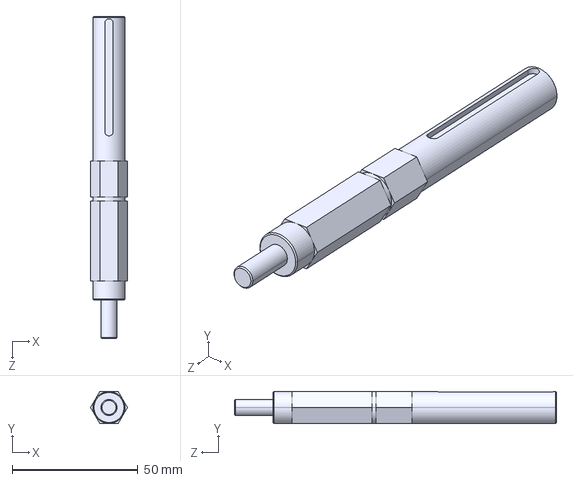
[picture p60: CAD file, 2021-09-24]
2021-22/FTC/Parts/AndyMark/am-0125 Super Shifter Wheel Shaft.STEP
14.7 x 12.7 x 127.8 mm
