DullesRobotics/ComputerAidedDesign/2021-22/FTC/#12456 Big Red/STL Files/5.5mm hex 8mm x2 bearing insert.stl

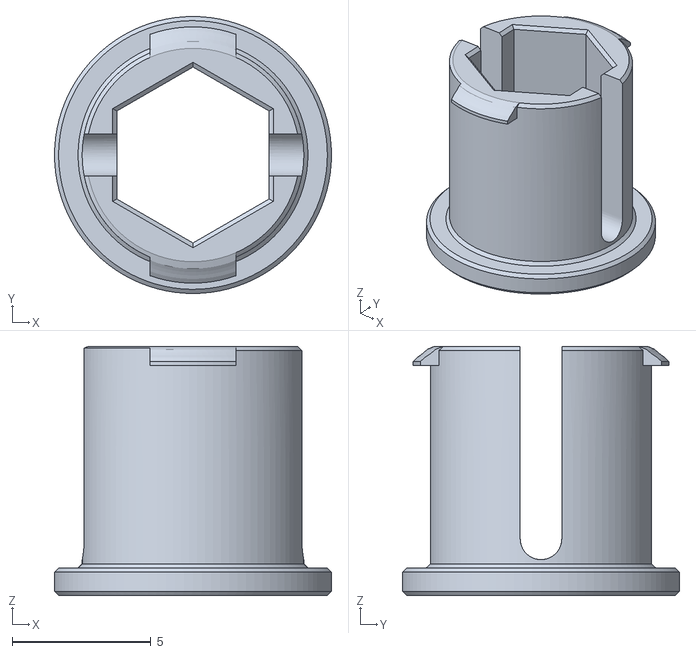
[picture p61: CAD file, 2022-01-19]
2021-22/FTC/#12456 Big Red/STL Files/5.5mm hex 8mm x2 bearing insert.stl
10.0 x 10.0 x 9.00
