DullesRobotics/ComputerAidedDesign/2021-22/FTC/Parts/AndyMark/am-0024 40T 20dp 375h.STEP

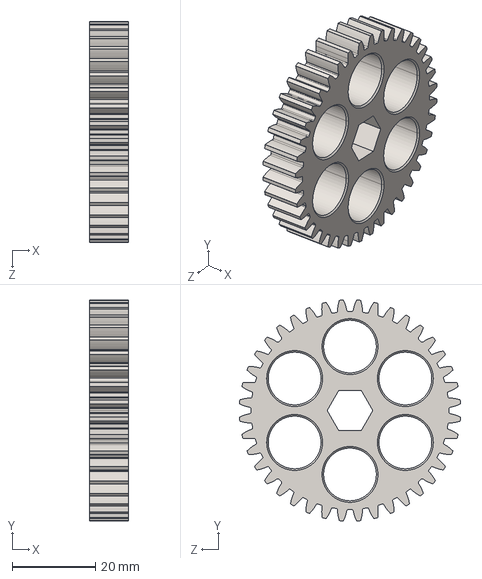
[picture p62: CAD file, 2021-09-24]
2021-22/FTC/Parts/AndyMark/am-0024 40T 20dp 375h.STEP
9.45 x 53.2 x 53.2 mm
