DullesRobotics/ComputerAidedDesign/2021-22/FTC/Parts/REV Parts/REV-41-1907 Simple.STEP

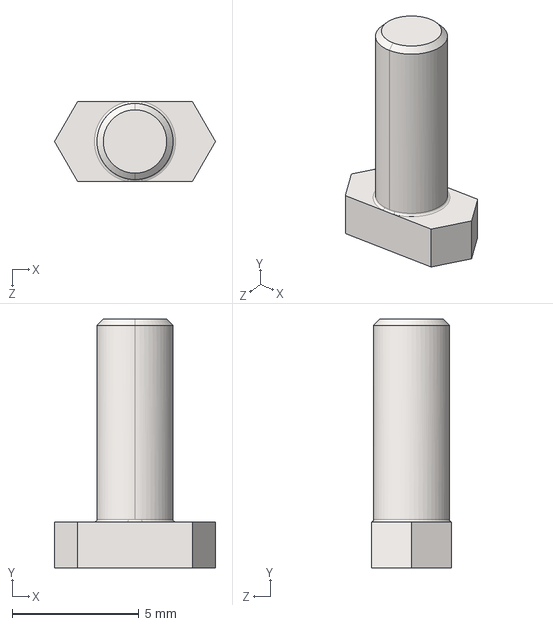
[picture p63: CAD file, 2021-09-05]
2021-22/FTC/Parts/REV Parts/REV-41-1907 Simple.STEP
6.35 x 9.82 x 3.15 mm
