DullesRobotics/ComputerAidedDesign/2021-22/FTC/#12456 Big Red/STL Files/15mm Hex Hub.stl

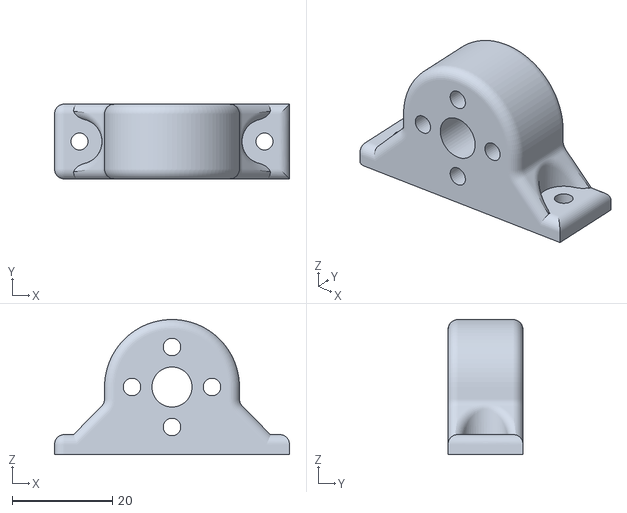
[picture p64: CAD file, 2022-01-19]
2021-22/FTC/#12456 Big Red/STL Files/15mm Hex Hub.stl
47.0 x 15.0 x 27.0
