DullesRobotics/ComputerAidedDesign/2021-22/FTC/Parts/AndyMark/am-0863 240 X 380 X 1.52IN Rail Spacer for Modulox REV2.STEP

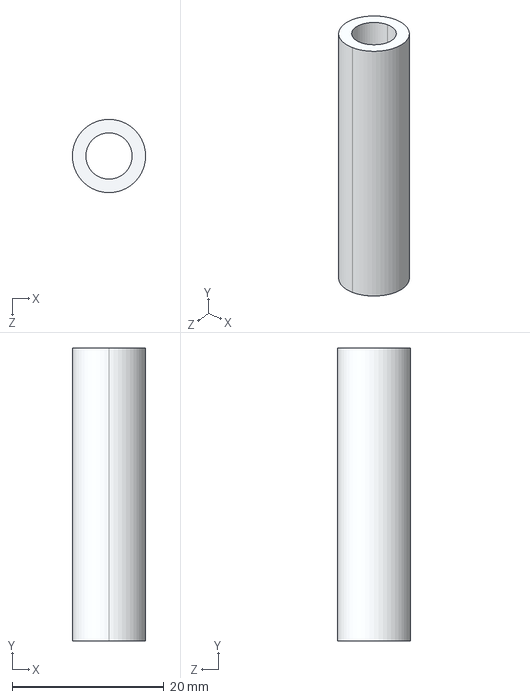
[picture p65: CAD file, 2021-09-24]
2021-22/FTC/Parts/AndyMark/am-0863 240 X 380 X 1.52IN Rail Spacer for Modulox REV2.STEP
9.65 x 38.6 x 9.65 mm
