DullesRobotics/ComputerAidedDesign/2021-22/FTC/Parts/REV Parts/L Beam - 24mm - 2 Pack.STEP

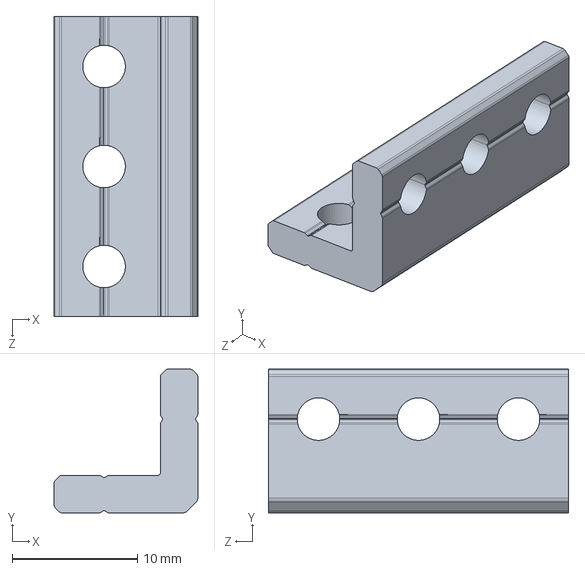
[picture p66: CAD file, 2021-09-05]
2021-22/FTC/Parts/REV Parts/L Beam - 24mm - 2 Pack.STEP
11.5 x 11.5 x 24.0 mm
