DullesRobotics/ComputerAidedDesign/2021-22/FTC/Parts/AndyMark/am-3563 4IN 8mm Compliant Wheel REV2.STEP

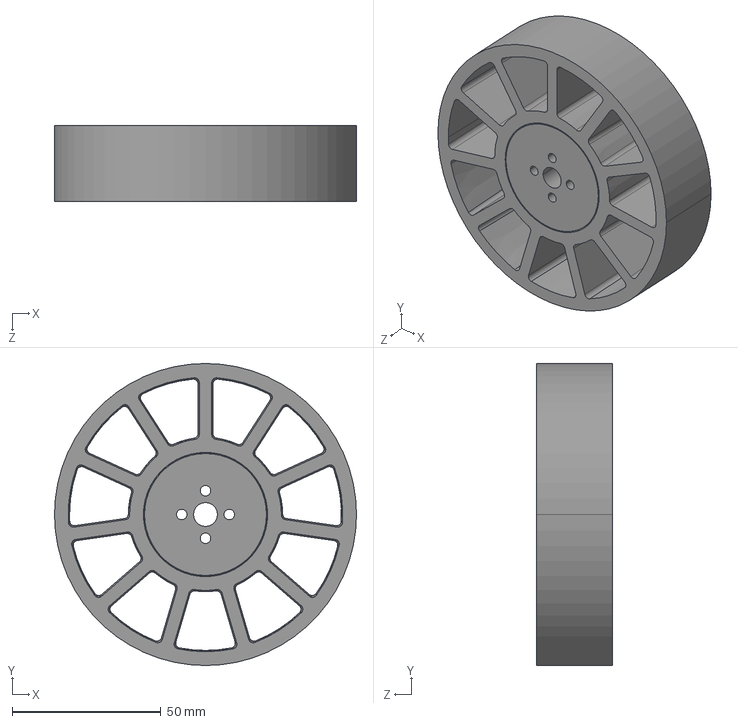
[picture p67: CAD file, 2021-09-24]
2021-22/FTC/Parts/AndyMark/am-3563 4IN 8mm Compliant Wheel REV2.STEP
101.6 x 101.6 x 25.4 mm
4IN Compliant Wheel FINAL Overmold
2in Wheel Intergrated 8mm Hub
