DullesRobotics/ComputerAidedDesign/2021-22/FTC/#12456 Big Red/STL Files/45 degree inside angle bracket.stl

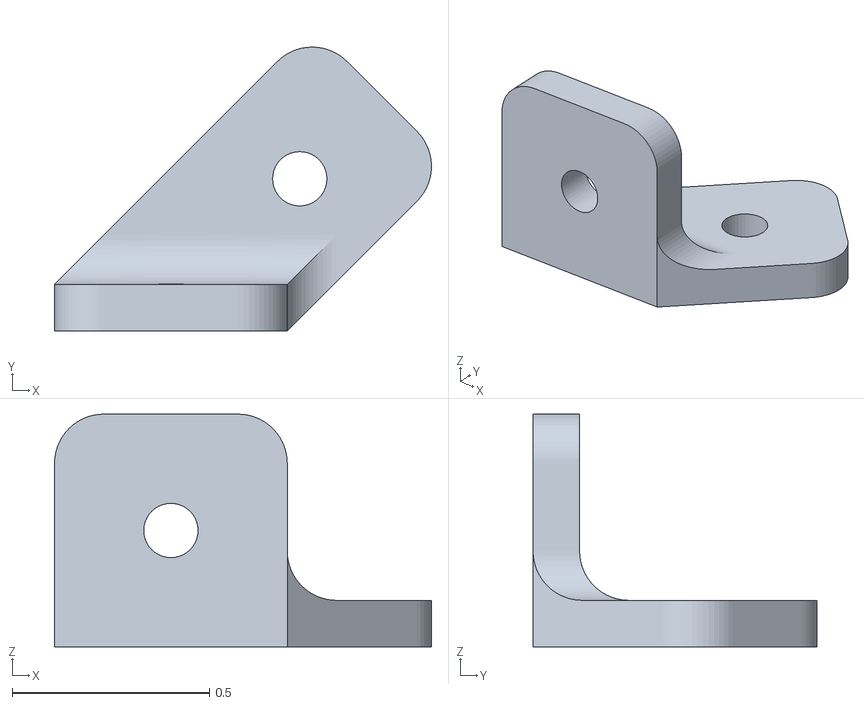
[picture p68: CAD file, 2022-01-18]
2021-22/FTC/#12456 Big Red/STL Files/45 degree inside angle bracket.stl
0.956 x 0.72 x 0.591
