DullesRobotics/ComputerAidedDesign/2021-22/FTC/Parts/AndyMark/am-0857 1 Slot Modulox Plate.STEP

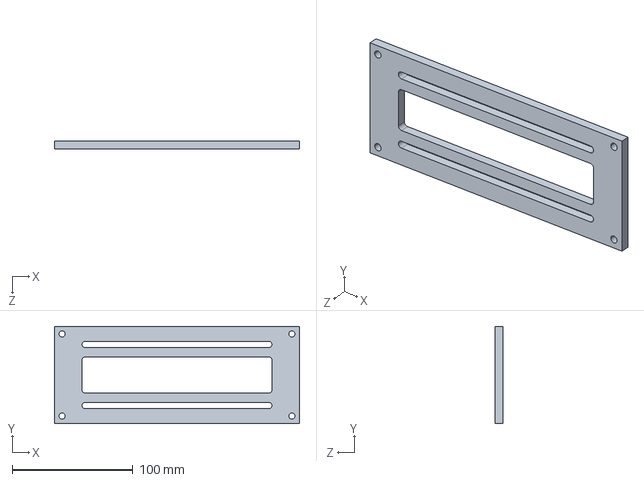
[picture p69: CAD file, 2021-09-24]
2021-22/FTC/Parts/AndyMark/am-0857 1 Slot Modulox Plate.STEP
203.2 x 80.8 x 6.35 mm
