DullesRobotics/ComputerAidedDesign/2021-22/FTC/Parts/REV Parts/Flat Beam - 408mm - 2 Pack.STEP

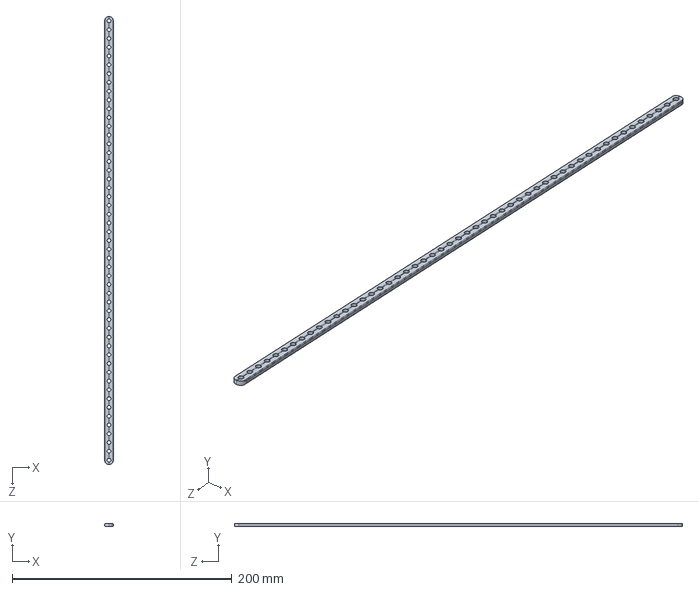
[picture p70: CAD file, 2021-09-05]
2021-22/FTC/Parts/REV Parts/Flat Beam - 408mm - 2 Pack.STEP
8.00 x 2.90 x 408.0 mm
