DullesRobotics/ComputerAidedDesign/2021-22/FTC/Parts/AndyMark/am-0179 45 Tooth Large Output Gear.STEP

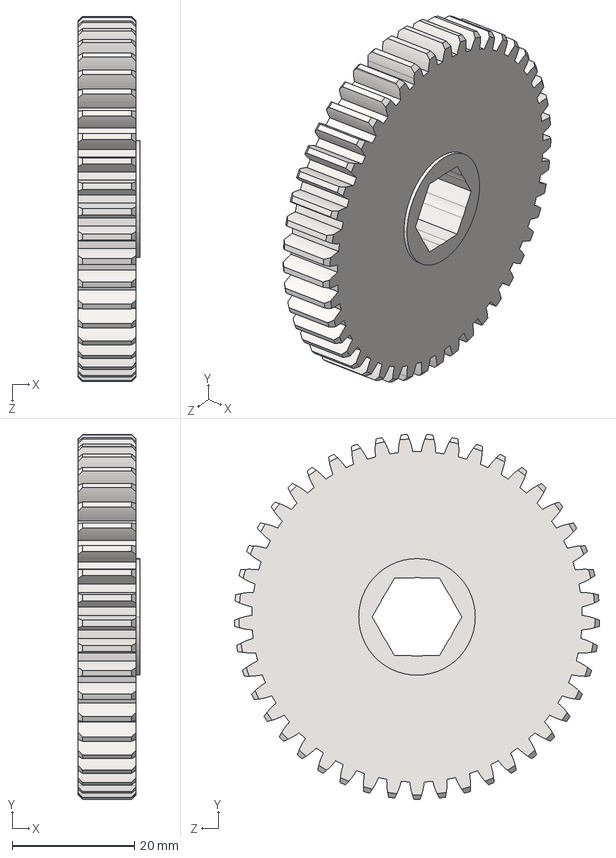
[picture p71: CAD file, 2021-09-24]
2021-22/FTC/Parts/AndyMark/am-0179 45 Tooth Large Output Gear.STEP
10.2 x 59.6 x 59.7 mm
