DullesRobotics/ComputerAidedDesign/2021-22/FTC/#12456 Big Red/STL Files/Pulley.stl

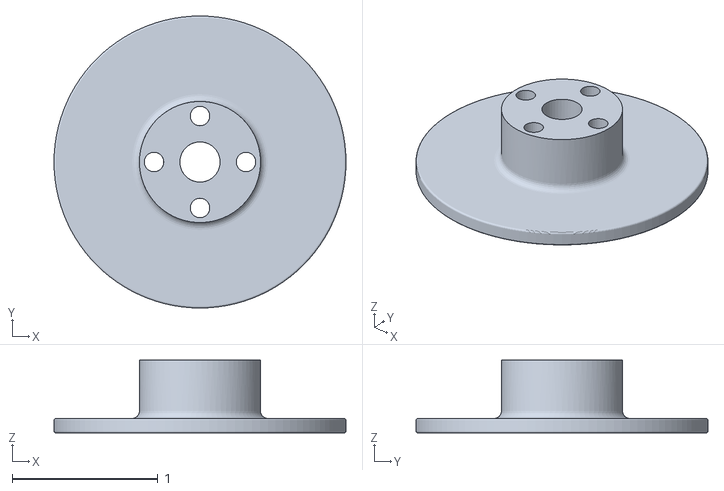
[picture p72: CAD file, 2022-01-18]
2021-22/FTC/#12456 Big Red/STL Files/Pulley.stl
2.00 x 2.00 x 0.5
