DullesRobotics/ComputerAidedDesign/2021-22/FTC/Parts/AndyMark/am-3986-440 0.440in Hex Spacer Extrusion.STEP

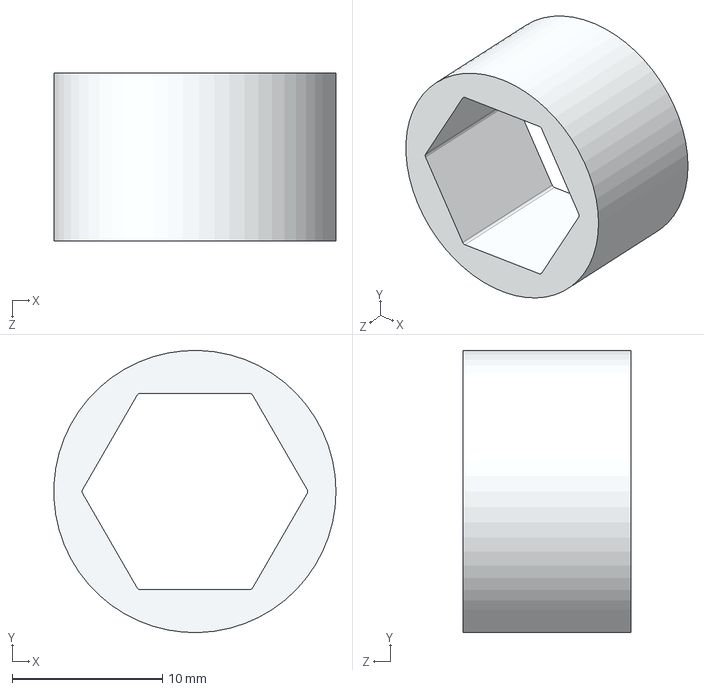
[picture p73: CAD file, 2021-09-24]
2021-22/FTC/Parts/AndyMark/am-3986-440 0.440in Hex Spacer Extrusion.STEP
18.8 x 18.8 x 11.2 mm
