DullesRobotics/ComputerAidedDesign/2021-22/FTC/Parts/REV Parts/15mm Bearing Pillow Block - 8 Pack.STEP

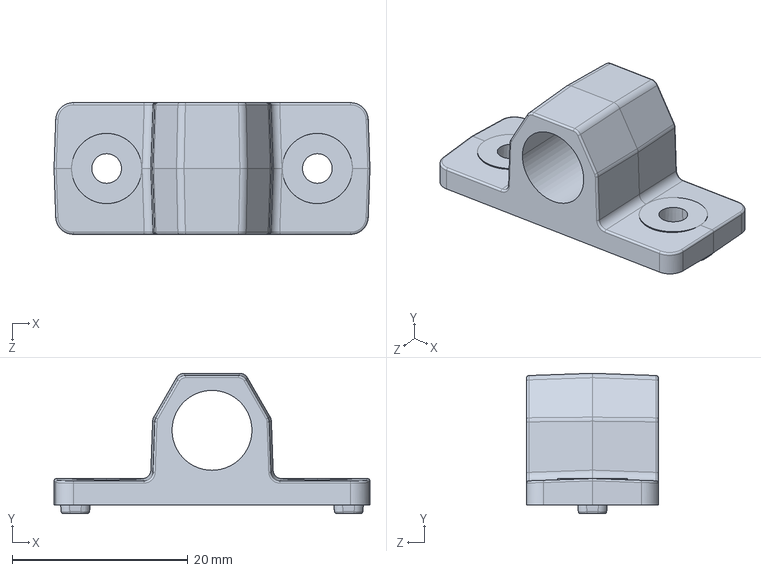
[picture p74: CAD file, 2021-09-05]
2021-22/FTC/Parts/REV Parts/15mm Bearing Pillow Block - 8 Pack.STEP
36.0 x 16.0 x 15.0 mm
