DullesRobotics/ComputerAidedDesign/2021-22/FTC/#12456 Big Red/STL Files/Spool.stl

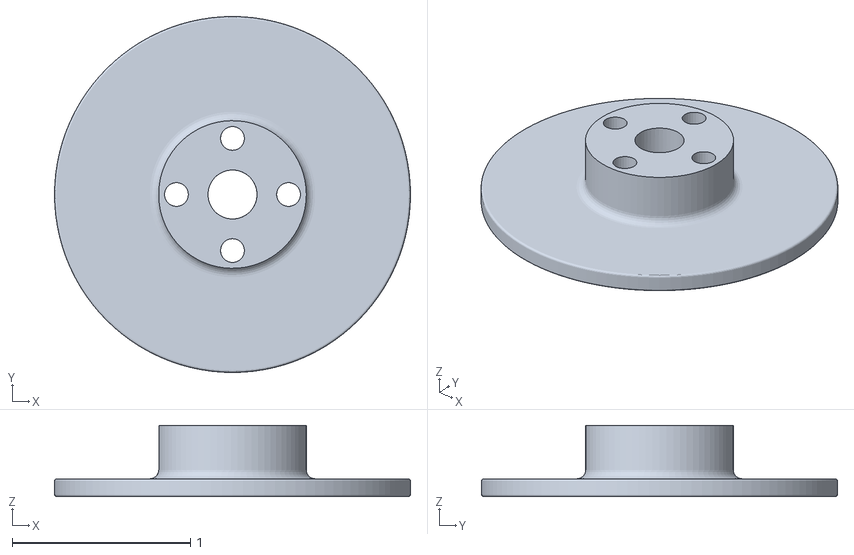
[picture p75: CAD file, 2022-01-18]
2021-22/FTC/#12456 Big Red/STL Files/Spool.stl
2.00 x 2.00 x 0.4
