DullesRobotics/ComputerAidedDesign/2021-22/FTC/Parts/REV Parts/3mm Spacer - 16 Pack.STEP

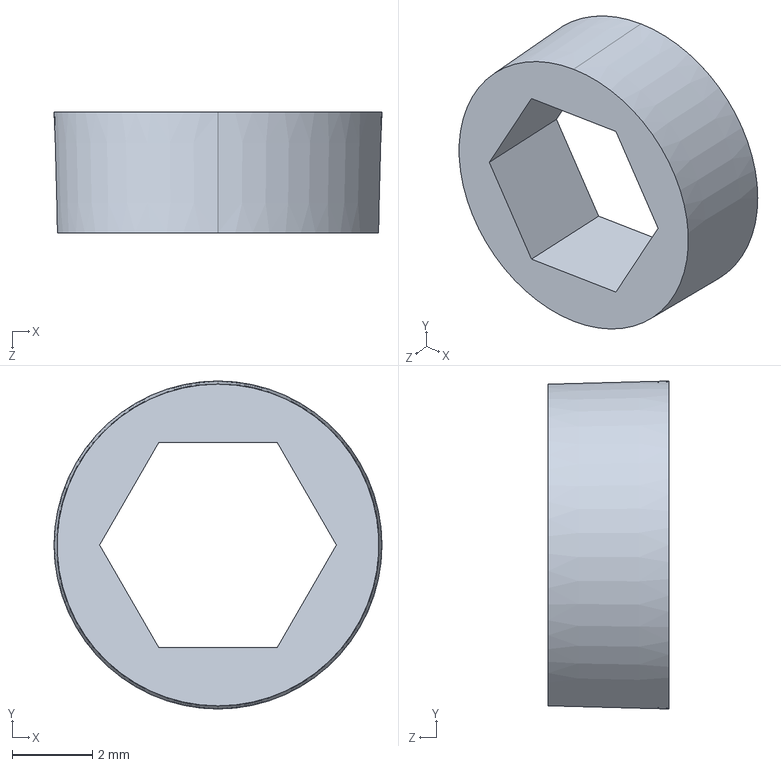
[picture p76: CAD file, 2021-09-05]
2021-22/FTC/Parts/REV Parts/3mm Spacer - 16 Pack.STEP
8.16 x 8.16 x 3.00 mm
