DullesRobotics/ComputerAidedDesign/2021-22/FTC/#12456 Big Red/STL Files/45 degree inside coner bracket.stl

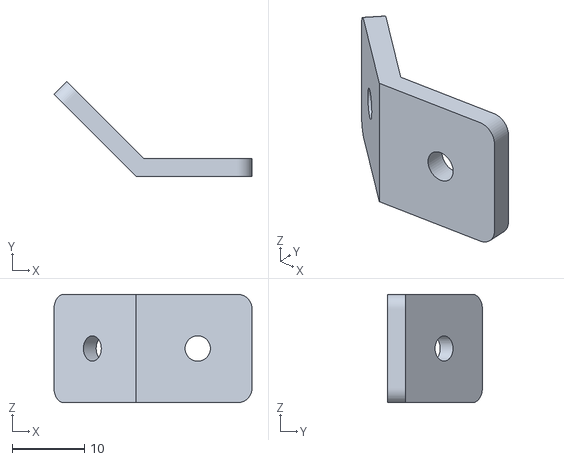
[picture p77: CAD file, 2022-01-18]
2021-22/FTC/#12456 Big Red/STL Files/45 degree inside coner bracket.stl
27.4 x 13.1 x 15.0
