DullesRobotics/ComputerAidedDesign/2021-22/FTC/Parts/AndyMark/am-3461a NeveRest Orbital 3.7 REV2.STEP

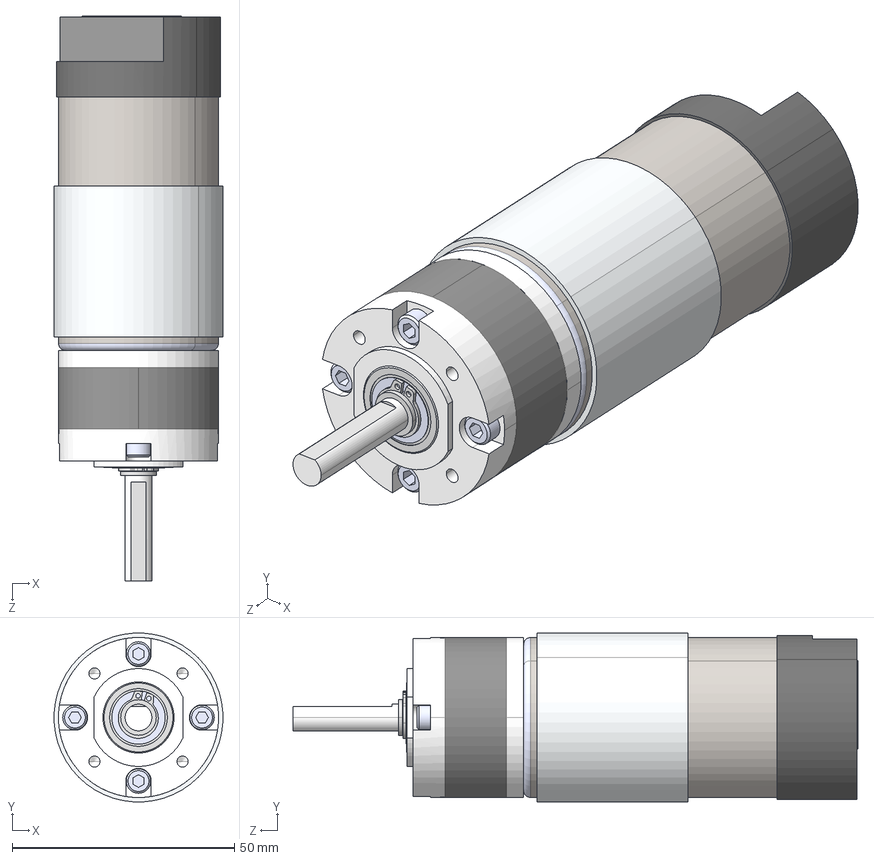
[picture p78: CAD file, 2021-09-24]
2021-22/FTC/Parts/AndyMark/am-3461a NeveRest Orbital 3.7 REV2.STEP
37.9 x 37.9 x 127.0 mm
NeveRest 4 Gearbox
SHCS M3 x 16mm x 4
7804K117_STAINLESS STEEL BALL BEARING_7804K117
97633A150_BLACK-FINISH STEEL EXTERNAL RETAINING RING_97633A150_grv
Shim
am-3104 NeveRest Motor
