DullesRobotics/ComputerAidedDesign/2021-22/FTC/#12456 Big Red/STL Files/45 degree angle bracket.stl

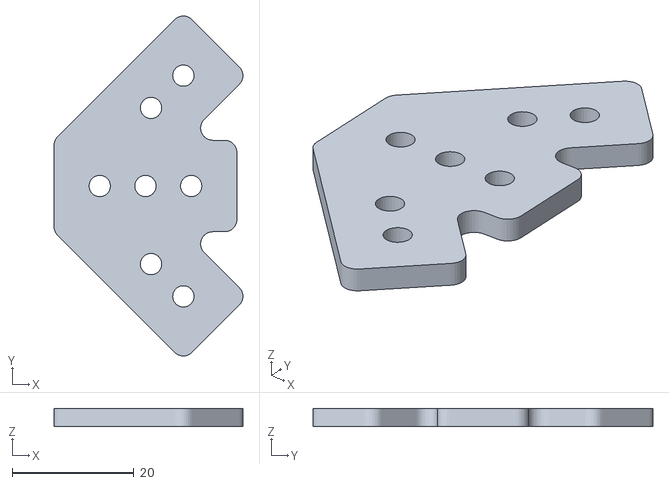
[picture p79: CAD file, 2022-01-18]
2021-22/FTC/#12456 Big Red/STL Files/45 degree angle bracket.stl
31.0 x 55.8 x 3.00
