DullesRobotics/ComputerAidedDesign/2021-22/FTC/Parts/AndyMark/am-3250 DART Cap Plate REV5.STEP

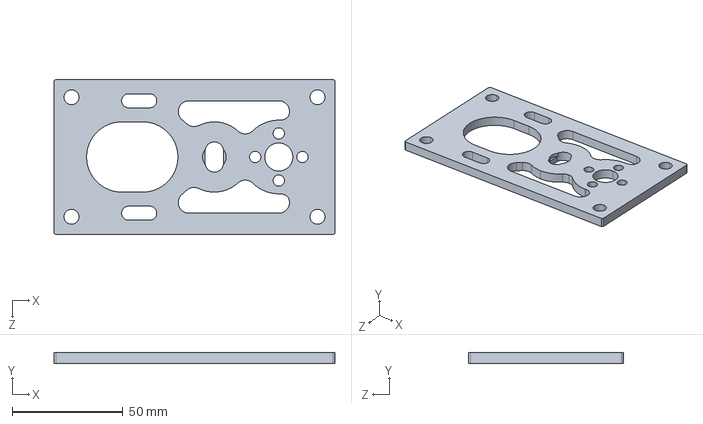
[picture p80: CAD file, 2021-09-24]
2021-22/FTC/Parts/AndyMark/am-3250 DART Cap Plate REV5.STEP
127.0 x 4.76 x 69.8 mm
