DullesRobotics/ComputerAidedDesign/2021-22/FTC/Parts/REV Parts/UltraPlanetary Outside Mounting Bracket - 4 Pack.STEP

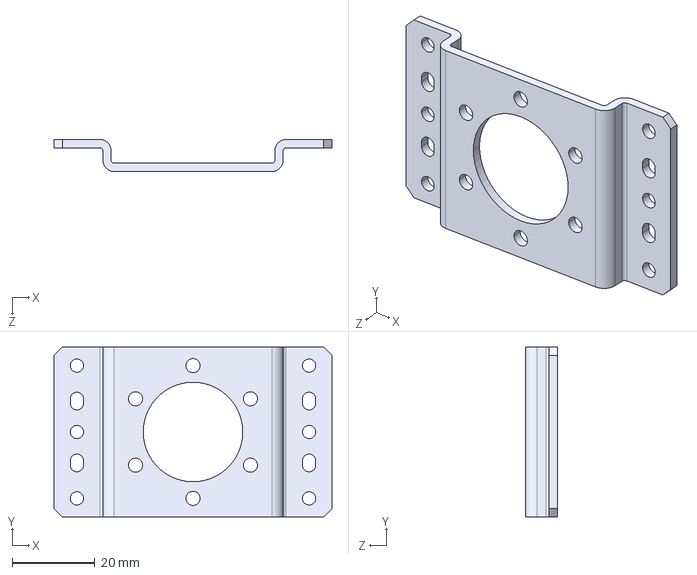
[picture p81: CAD file, 2021-09-05]
2021-22/FTC/Parts/REV Parts/UltraPlanetary Outside Mounting Bracket - 4 Pack.STEP
67.1 x 41.0 x 7.74 mm
