DullesRobotics/ComputerAidedDesign/2021-22/FTC/#12456 Big Red/STL Files/Hearing Tooth Center Drive Gear Small V2.stl

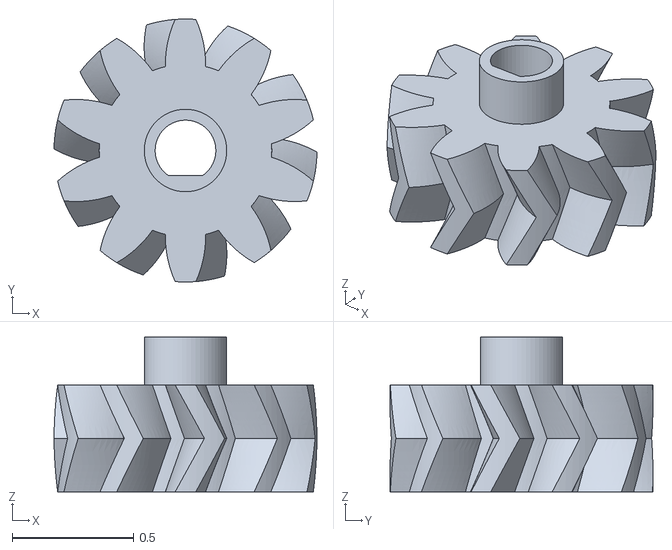
[picture p82: CAD file, 2021-12-08]
2021-22/FTC/#12456 Big Red/STL Files/Hearing Tooth Center Drive Gear Small V2.stl
1.08 x 1.08 x 0.637
