DullesRobotics/ComputerAidedDesign/2021-22/FTC/Parts/AndyMark/am-3021a S&S Hex Output Shaft.STEP

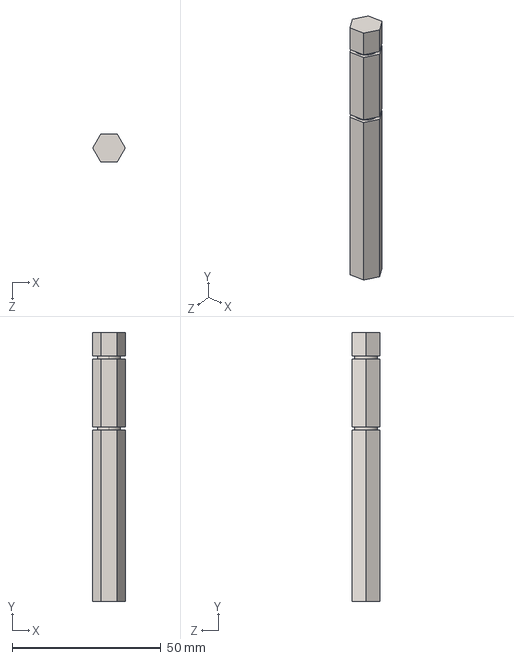
[picture p83: CAD file, 2021-09-24]
2021-22/FTC/Parts/AndyMark/am-3021a S&S Hex Output Shaft.STEP
11.0 x 90.4 x 9.51 mm
