DullesRobotics/ComputerAidedDesign/2021-22/FTC/Parts/REV Parts/12 Tooth GT2 3mm Pitch Pulley - 4 Pack.STEP

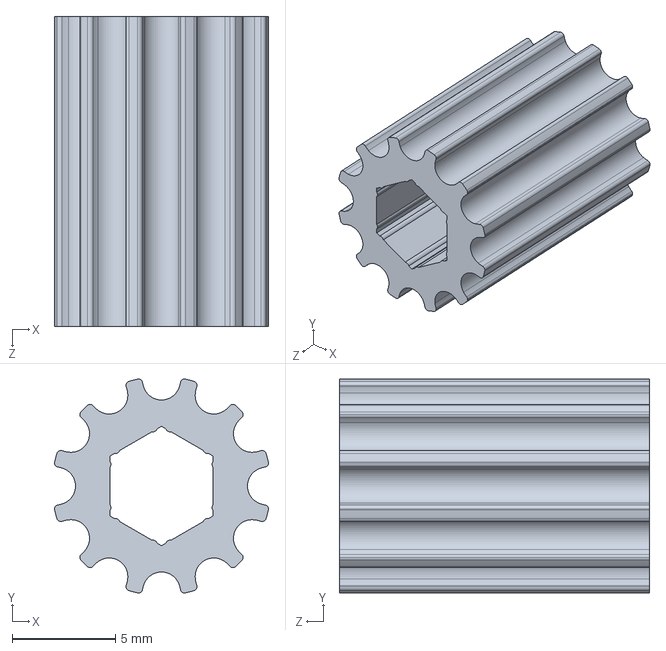
[picture p84: CAD file, 2021-09-05]
2021-22/FTC/Parts/REV Parts/12 Tooth GT2 3mm Pitch Pulley - 4 Pack.STEP
10.3 x 10.3 x 15.0 mm
