DullesRobotics/ComputerAidedDesign/2021-22/FTC/#12456 Big Red/STL Files/Gear 25 tooth.stl

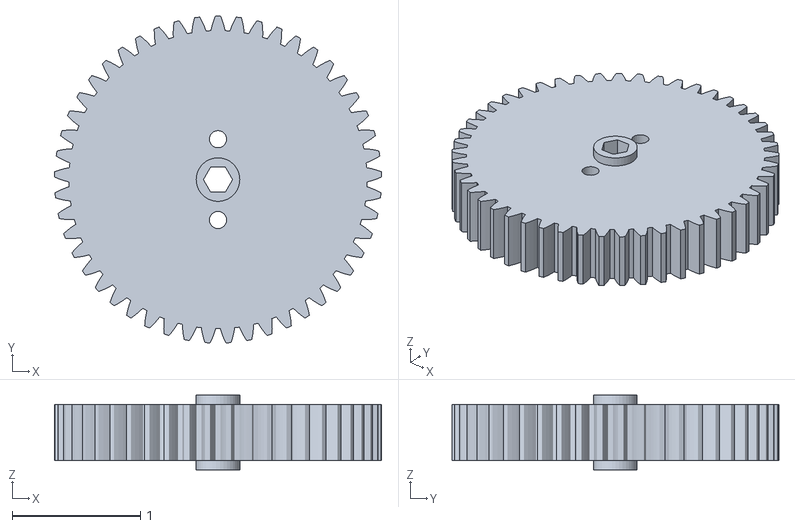
[picture p85: CAD file, 2021-12-08]
2021-22/FTC/#12456 Big Red/STL Files/Gear 25 tooth.stl
2.55 x 2.55 x 0.584
