DullesRobotics/ComputerAidedDesign/2021-22/FTC/Parts/AndyMark/am-3815 32T 20DP 500hex 375 FW.STEP

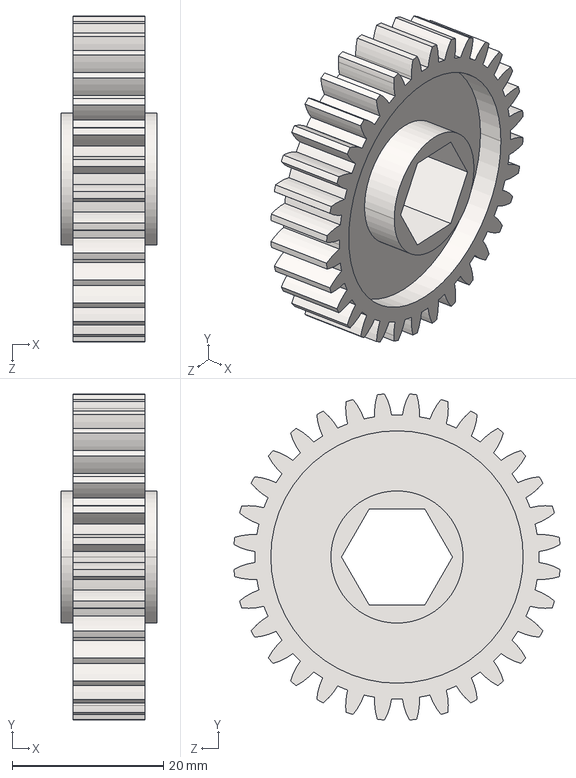
[picture p86: CAD file, 2021-09-24]
2021-22/FTC/Parts/AndyMark/am-3815 32T 20DP 500hex 375 FW.STEP
12.7 x 43.1 x 43.1 mm
