DullesRobotics/ComputerAidedDesign/2021-22/FTC/Parts/REV Parts/1in End-mount Bearing Bracket.STEP

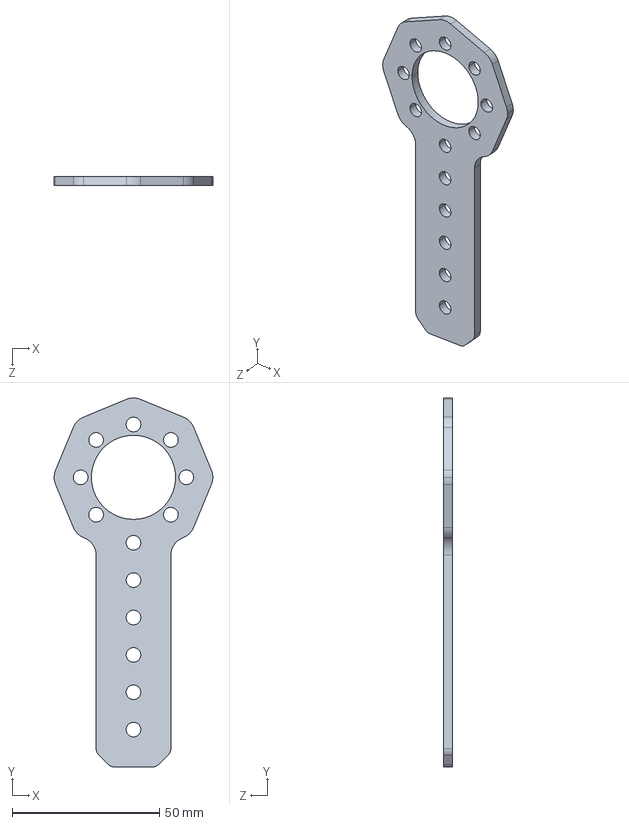
[picture p87: CAD file, 2021-09-05]
2021-22/FTC/Parts/REV Parts/1in End-mount Bearing Bracket.STEP
53.9 x 125.4 x 3.18 mm
