DullesRobotics/ComputerAidedDesign/2021-22/FTC/#12456 Big Red/STL Files/Hearing Tooth Center Drive Gear Small.stl

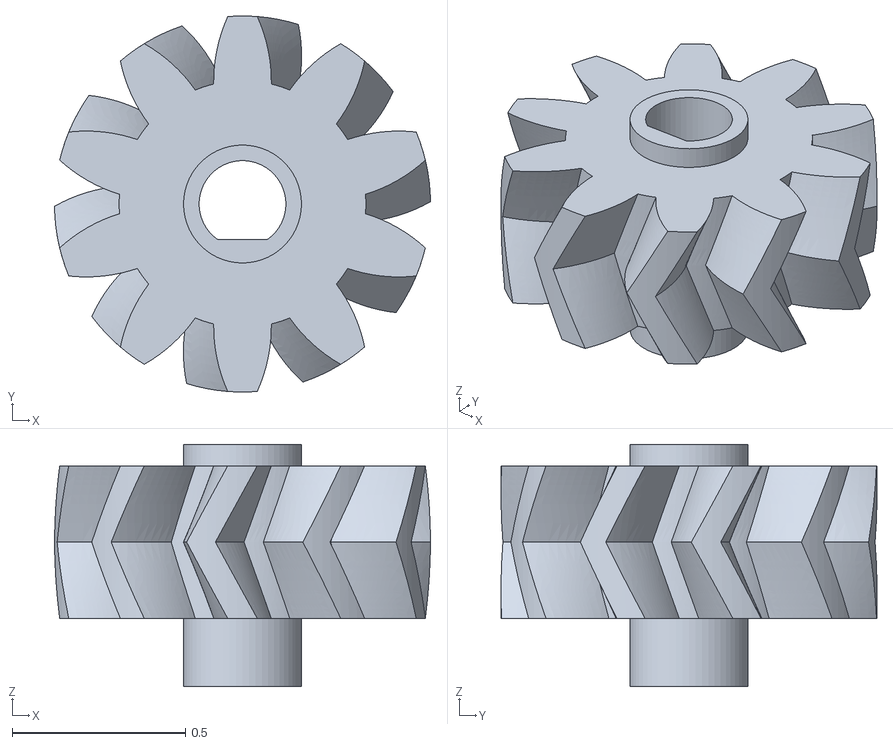
[picture p88: CAD file, 2021-12-08]
2021-22/FTC/#12456 Big Red/STL Files/Hearing Tooth Center Drive Gear Small.stl
1.08 x 1.08 x 0.699
