DullesRobotics/ComputerAidedDesign/2021-22/FTC/Parts/AndyMark/am-3776  Miter Gear 1.25, 20T, 8mm, 2mm Key Bore.STEP

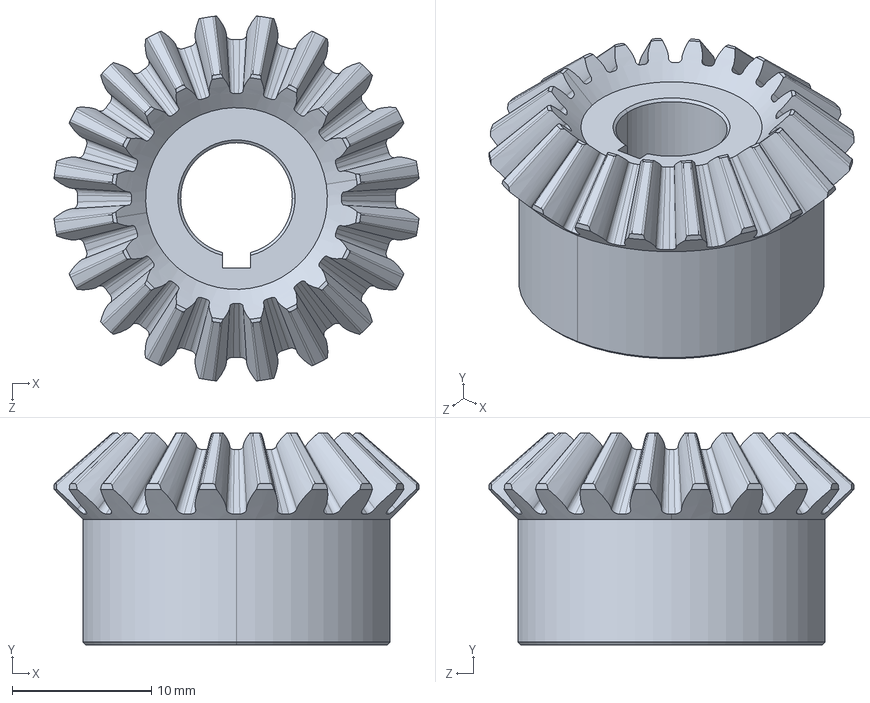
[picture p89: CAD file, 2021-09-24]
2021-22/FTC/Parts/AndyMark/am-3776 Miter Gear 1.25, 20T, 8mm, 2mm Key Bore.STEP
26.2 x 15.2 x 26.2 mm
