DullesRobotics/ComputerAidedDesign/2021-22/FTC/Parts/REV Parts/1.5mm Spacers - 28 Pack.STEP

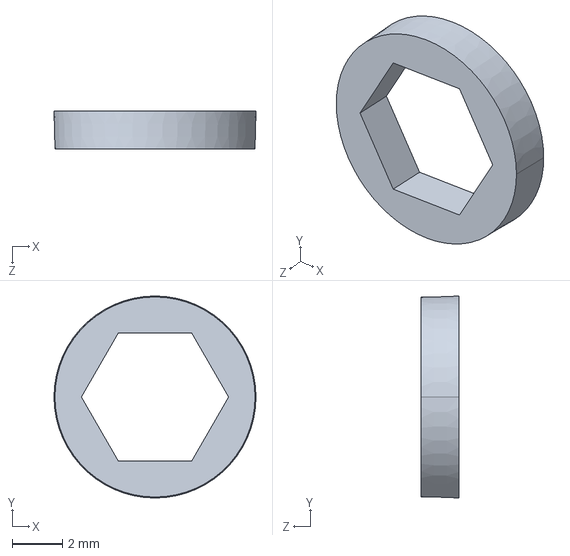
[picture p90: CAD file, 2021-09-05]
2021-22/FTC/Parts/REV Parts/1.5mm Spacers - 28 Pack.STEP
8.08 x 8.08 x 1.50 mm
