DullesRobotics/ComputerAidedDesign/2021-22/FTC/#12456 Big Red/STL Files/Gear 9 tooth.stl

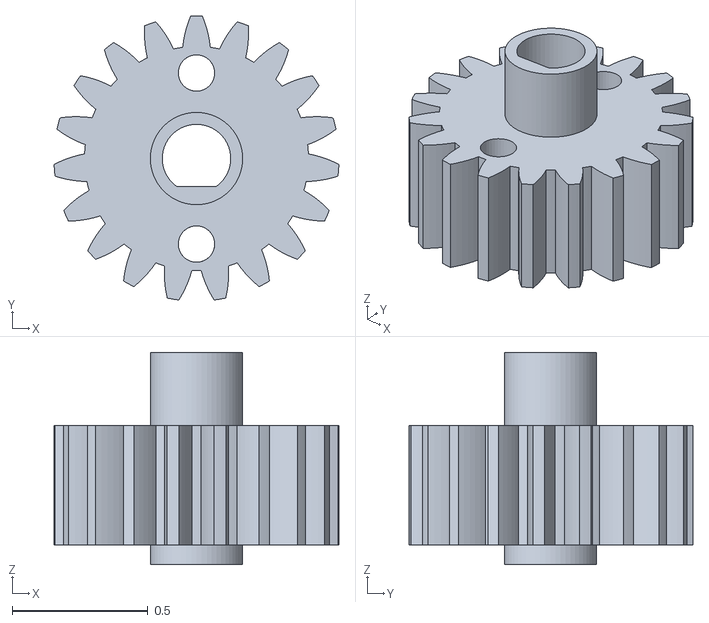
[picture p91: CAD file, 2021-12-08]
2021-22/FTC/#12456 Big Red/STL Files/Gear 9 tooth.stl
1.05 x 1.05 x 0.781
