DullesRobotics/ComputerAidedDesign/2021-22/FTC/Parts/AndyMark/am-4259_12T NEO550 with 12T 32DP Pinion.STEP

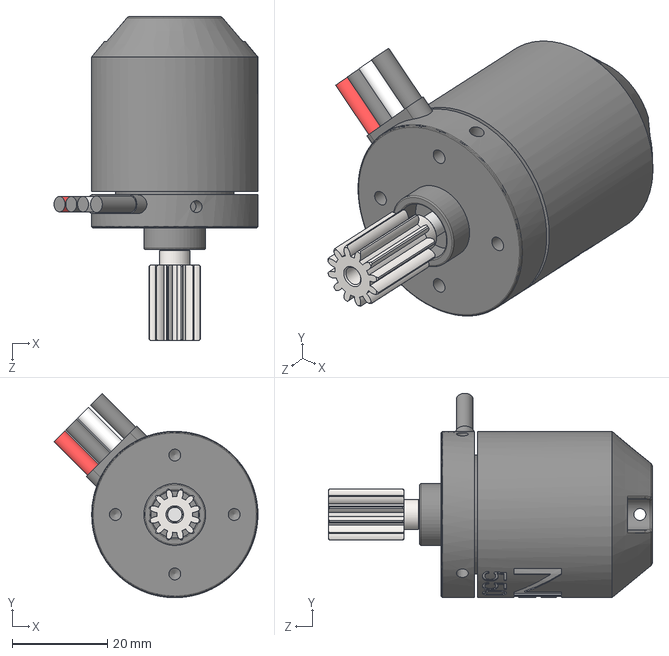
[picture p92: CAD file, 2021-09-24]
2021-22/FTC/Parts/AndyMark/am-4259_12T NEO550 with 12T 32DP Pinion.STEP
42.9 x 43.0 x 68.2 mm
