DullesRobotics/ComputerAidedDesign/2021-22/FTC/Parts/REV Parts/5mm x 400mm Hex Shaft - 4 Pack.STEP

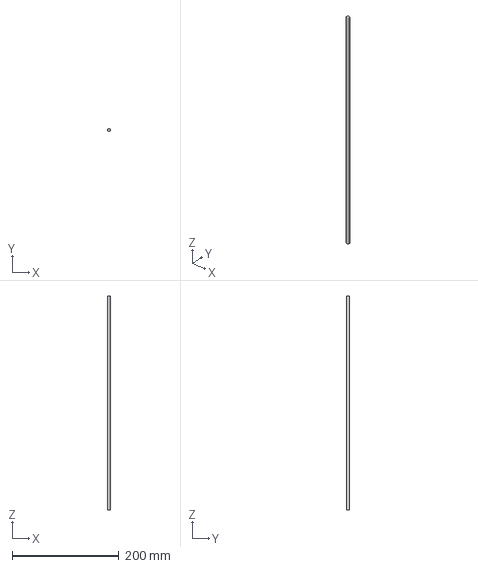
[picture p93: CAD file, 2021-09-05]
2021-22/FTC/Parts/REV Parts/5mm x 400mm Hex Shaft - 4 Pack.STEP
5.00 x 5.77 x 400.0 mm
