DullesRobotics/ComputerAidedDesign/2021-22/FTC/#12456 Big Red/STL Files/NeveRest 20 Orbital Mount v2.stl

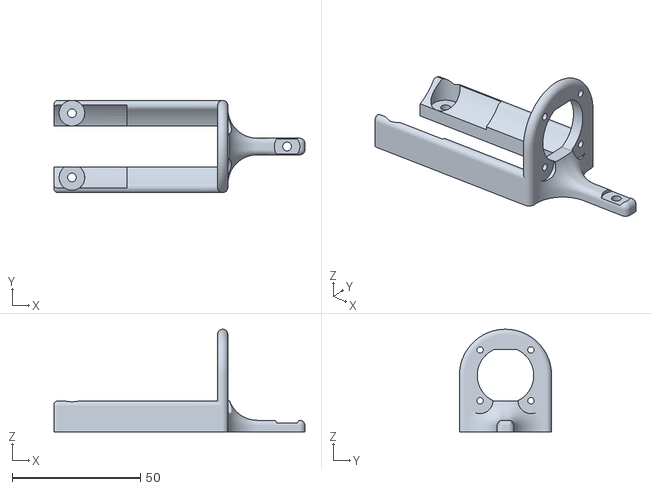
[picture p94: CAD file, 2021-12-08]
2021-22/FTC/#12456 Big Red/STL Files/NeveRest 20 Orbital Mount v2.stl
97.8 x 36.0 x 40.0
