DullesRobotics/ComputerAidedDesign/2021-22/FTC/Parts/AndyMark/am-0131 SS_HexShaft.STEP

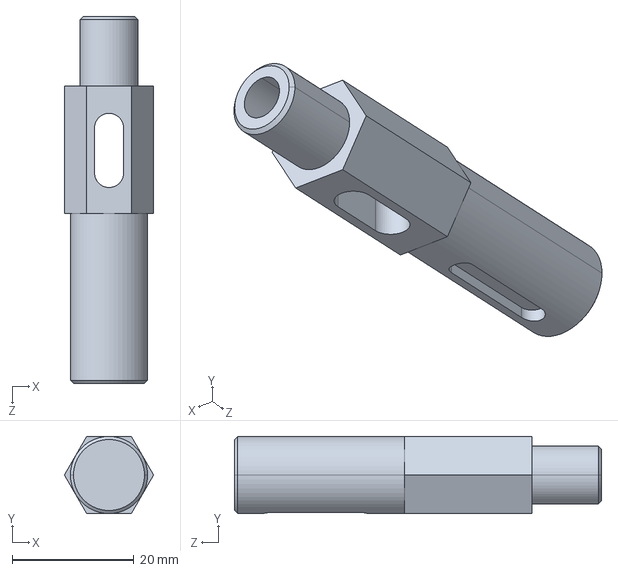
[picture p95: CAD file, 2021-09-24]
2021-22/FTC/Parts/AndyMark/am-0131 SS_HexShaft.STEP
14.7 x 12.7 x 60.3 mm
