DullesRobotics/ComputerAidedDesign/2021-22/FTC/Parts/REV Parts/40 Tooth Metal #25 Sprocket.STEP

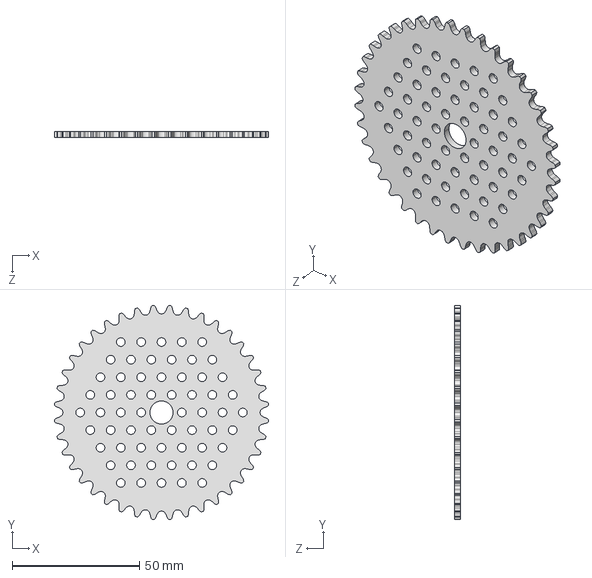
[picture p96: CAD file, 2021-09-05]
2021-22/FTC/Parts/REV Parts/40 Tooth Metal #25 Sprocket.STEP
84.2 x 84.2 x 2.50 mm
