DullesRobotics/ComputerAidedDesign/2021-22/FTC/#12456 Big Red/STL Files/26 Tooth #25 Sprocket - 4 Pack.stl

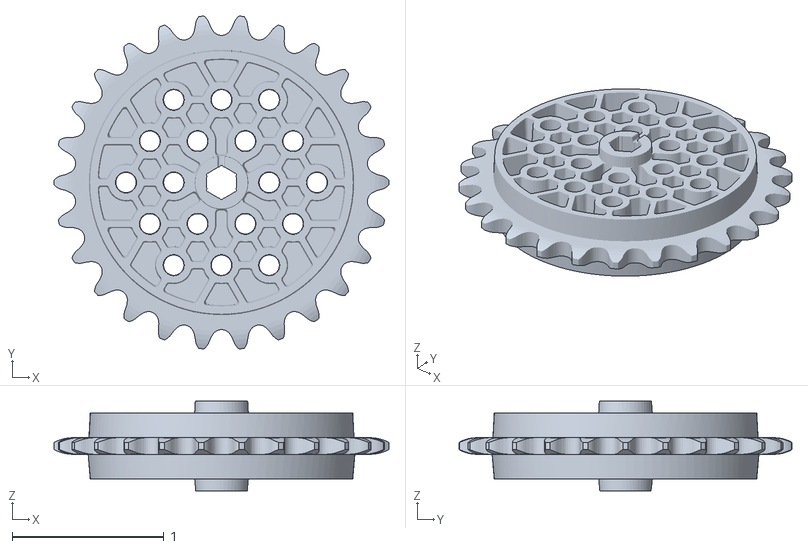
[picture p97: CAD file, 2021-12-08]
2021-22/FTC/#12456 Big Red/STL Files/26 Tooth #25 Sprocket - 4 Pack.stl
2.21 x 2.20 x 0.591
