DullesRobotics/ComputerAidedDesign/2021-22/FTC/Parts/AndyMark/am-0225 S35-54L Sprocket.STEP

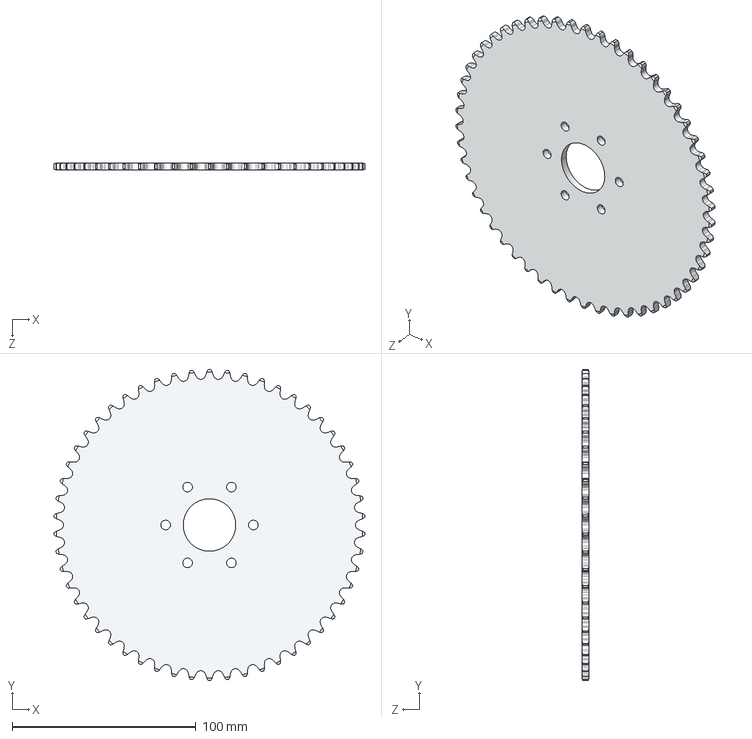
[picture p98: CAD file, 2021-09-24]
2021-22/FTC/Parts/AndyMark/am-0225 S35-54L Sprocket.STEP
169.0 x 169.3 x 3.94 mm
