DullesRobotics/ComputerAidedDesign/2021-22/FTC/Parts/REV Parts/Heavy_duty_Linear_slide_example.STEP

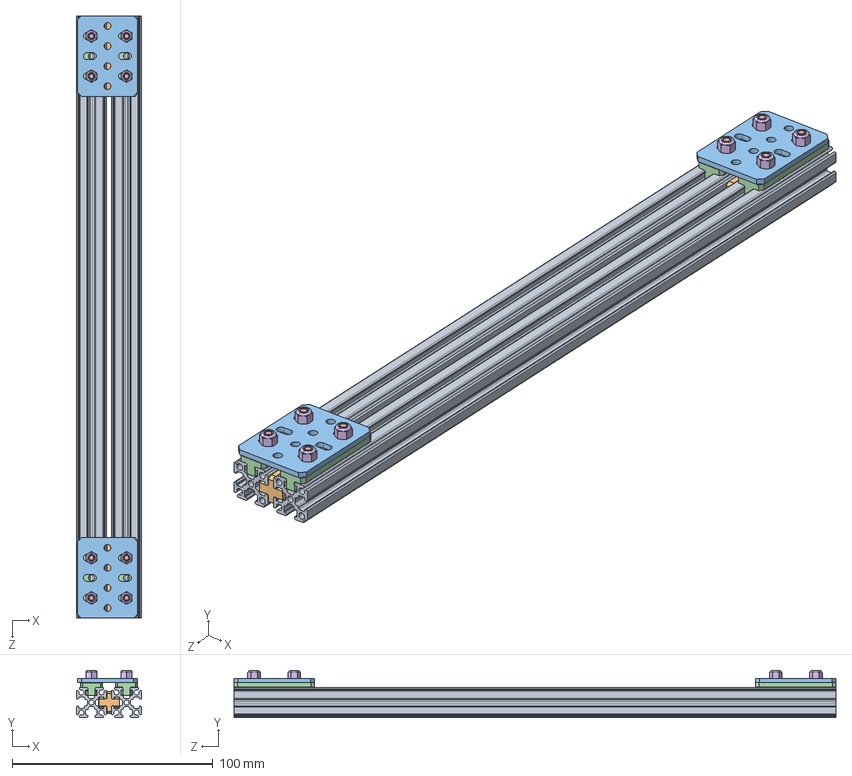
[picture p99: CAD file, 2021-09-05]
2021-22/FTC/Parts/REV Parts/Heavy_duty_Linear_slide_example.STEP
32.5 x 23.5 x 300.0 mm
REV-41-1017-300mm x 2
REV-41-1094 x 2
REV-41-1039 x 2
REV-41-1095 x 4
91280A106_91280A106 x 8
94205A220_94205A220 x 8
91280A104_91280A104 x 2
90591A250_90591A250 x 2
