DullesRobotics/ComputerAidedDesign/2021-22/FTC/#12456 Big Red/STL Files/Hearing Tooth Center Drive Gear Large.stl

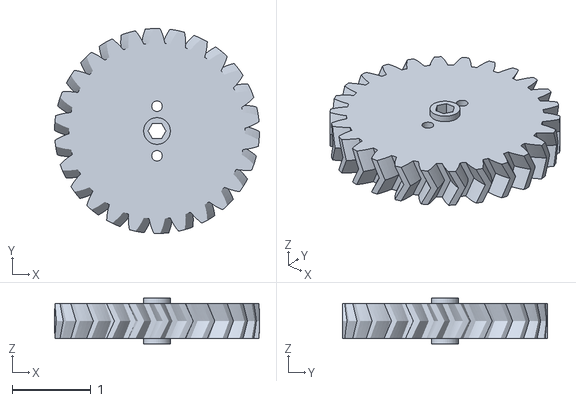
[picture p100: CAD file, 2021-12-08]
2021-22/FTC/#12456 Big Red/STL Files/Hearing Tooth Center Drive Gear Large.stl
2.61 x 2.61 x 0.584
