DullesRobotics/ComputerAidedDesign/2021-22/FTC/Parts/AndyMark/am-0029 0.5'' id Bearing (R8).STEP

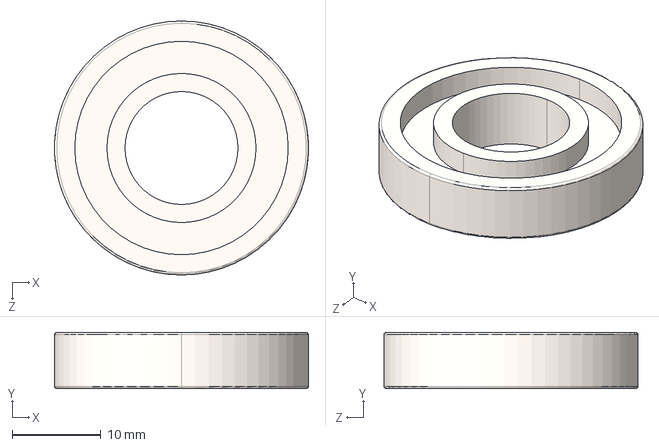
[picture p101: CAD file, 2021-09-24]
2021-22/FTC/Parts/AndyMark/am-0029 0.5'' id Bearing (R8).STEP
28.6 x 6.32 x 28.6 mm
