DullesRobotics/ComputerAidedDesign/2021-22/FTC/#12456 Big Red/STL Files/Hearing Tooth Center Drive Gear Large V2.stl

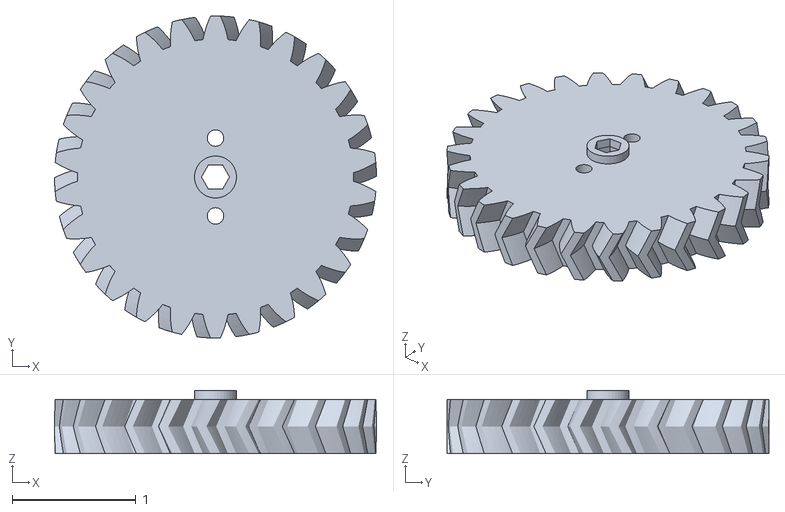
[picture p102: CAD file, 2021-12-08]
2021-22/FTC/#12456 Big Red/STL Files/Hearing Tooth Center Drive Gear Large V2.stl
2.61 x 2.61 x 0.512
