DullesRobotics/ComputerAidedDesign/2021-22/FTC/Parts/AndyMark/am-2373 Snow Blower Motor Mount.STEP

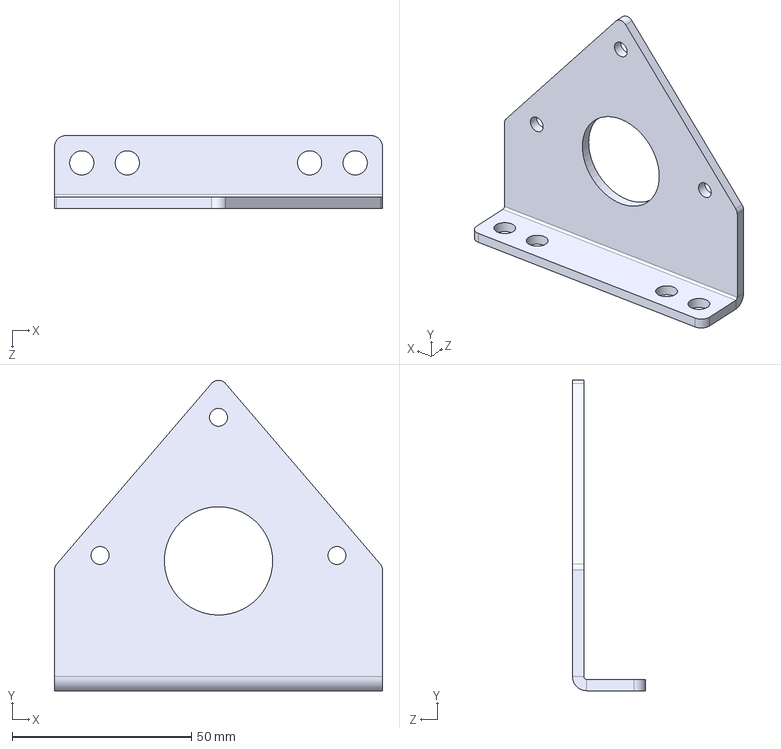
[picture p103: CAD file, 2021-09-24]
2021-22/FTC/Parts/AndyMark/am-2373 Snow Blower Motor Mount.STEP
91.4 x 86.5 x 20.3 mm
