DullesRobotics/ComputerAidedDesign/2021-22/FTC/Parts/REV Parts/15mm Plastic 30 Degree Bracket - 8 Pack.STEP

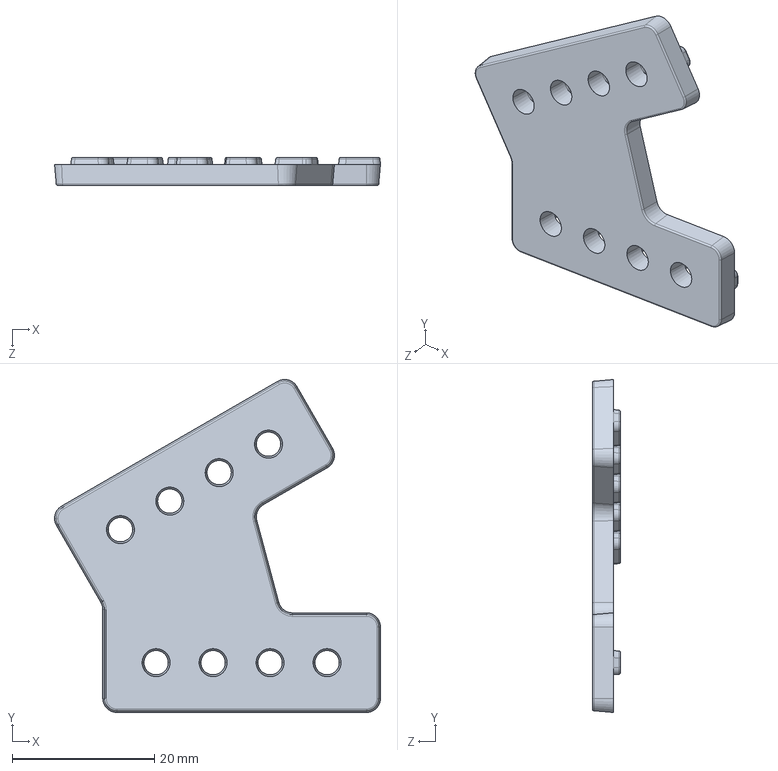
[picture p104: CAD file, 2021-09-05]
2021-22/FTC/Parts/REV Parts/15mm Plastic 30 Degree Bracket - 8 Pack.STEP
45.8 x 46.8 x 4.00 mm
