DullesRobotics/ComputerAidedDesign/2021-22/FTC/Parts/AndyMark/am-3013a 40 Tooth Gear for S&S.STEP

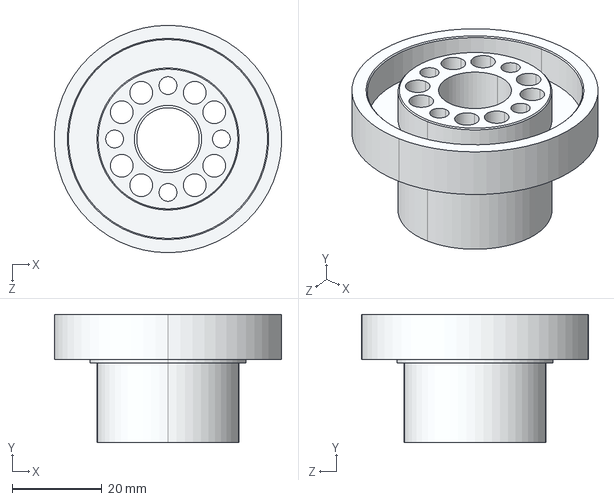
[picture p105: CAD file, 2021-09-24]
2021-22/FTC/Parts/AndyMark/am-3013a 40 Tooth Gear for S&S.STEP
50.7 x 28.7 x 50.8 mm
