DullesRobotics/ComputerAidedDesign/2021-22/FTC/Parts/REV Parts/15mm Linear Motion Kit V2.STEP

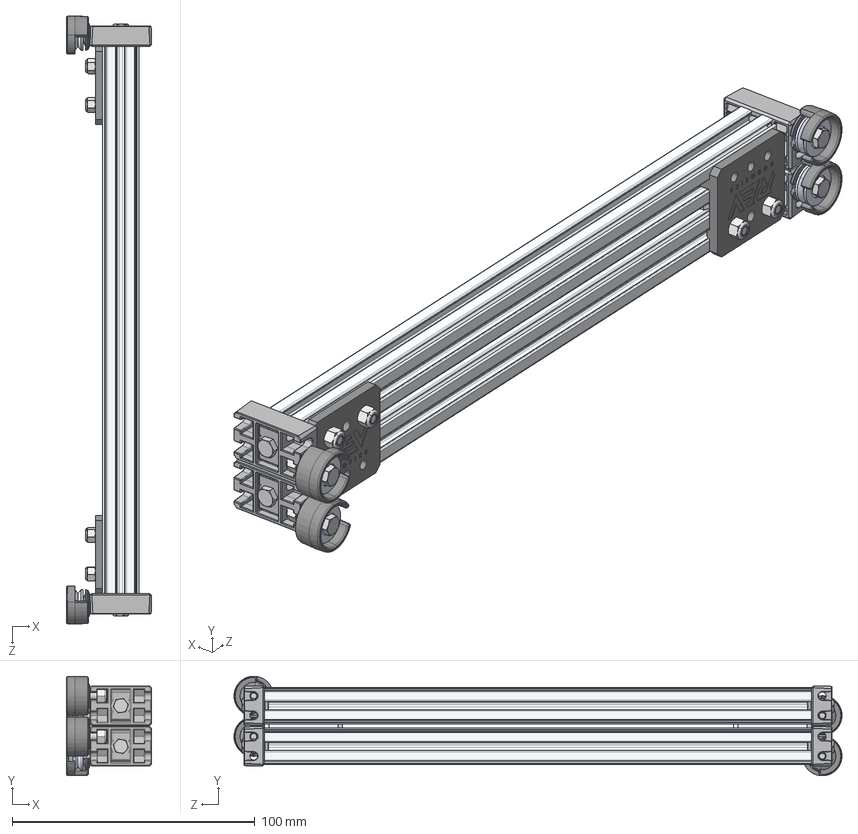
[picture p106: CAD file, 2021-09-05]
2021-22/FTC/Parts/REV Parts/15mm Linear Motion Kit V2.STEP
35.0 x 40.9 x 250.2 mm
REV-41-1431 x 2
REV-41-1511 V2 x 4
REV-41-1512 V2 x 4
REV-41-1519 x 2
REV-41-1520 x 2
REV-41-1368 x 4
REV-41-1359 Simple x 4
REV-41-1361 Simple x 8
REV-41-1360 Simple x 8
M3 x 8mm low profile socket x 4
hex nut style 1_am_B18.2.4.1M - Hex nut, Style 1, M3 x 0.5 --D-N x 4
