DullesRobotics/ComputerAidedDesign/2021-22/FTC/Parts/AndyMark/am-3527a Evo Shifter 2 Stage 3 Motor Plate R3.STEP

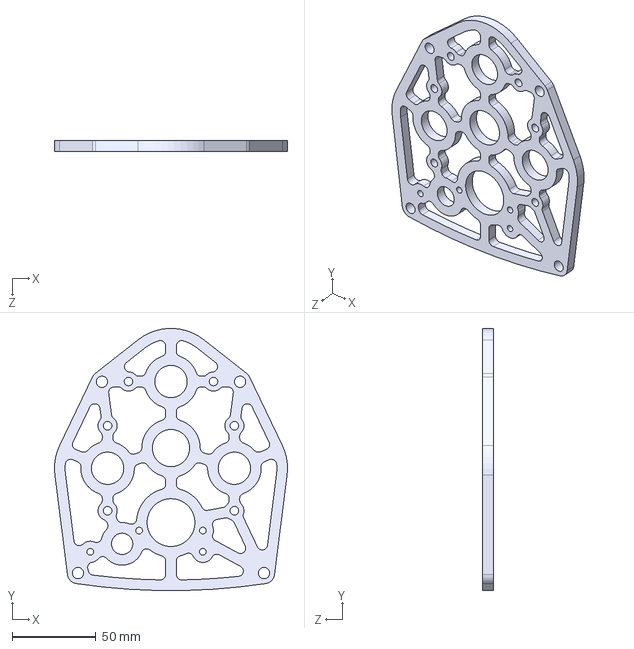
[picture p107: CAD file, 2021-09-24]
2021-22/FTC/Parts/AndyMark/am-3527a Evo Shifter 2 Stage 3 Motor Plate R3.STEP
139.2 x 156.5 x 6.35 mm
