DullesRobotics/ComputerAidedDesign/2021-22/FTC/Parts/AndyMark/am-0763 595x500 spacer REV2.STEP

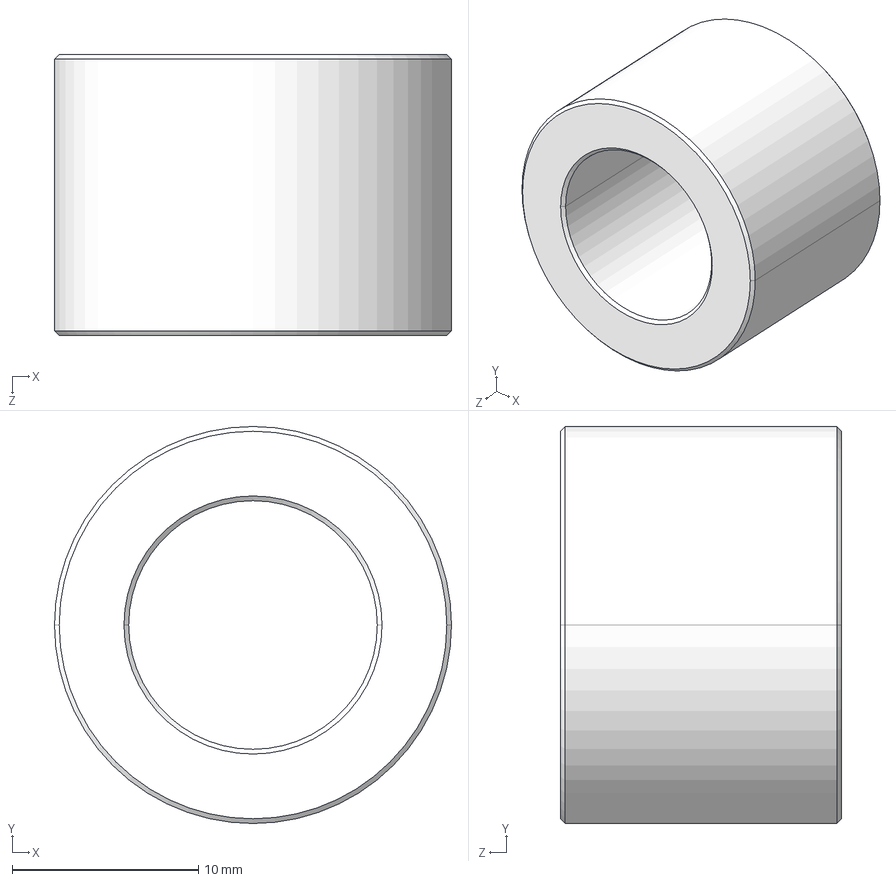
[picture p108: CAD file, 2021-09-24]
2021-22/FTC/Parts/AndyMark/am-0763 595x500 spacer REV2.STEP
21.3 x 21.3 x 15.1 mm
