DullesRobotics/ComputerAidedDesign/2021-22/FTC/Parts/REV Parts/1in Bearing Mounting Bracket V2.STEP

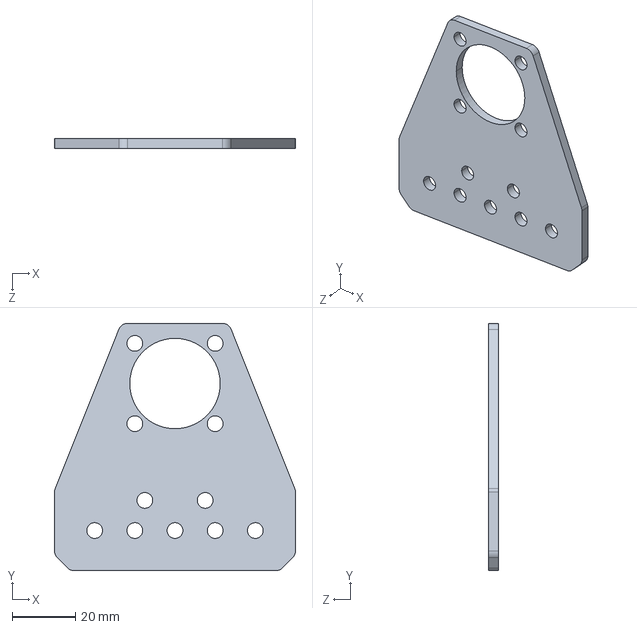
[picture p109: CAD file, 2021-09-05]
2021-22/FTC/Parts/REV Parts/1in Bearing Mounting Bracket V2.STEP
76.2 x 78.2 x 3.18 mm
