DullesRobotics/ComputerAidedDesign/2021-22/FTC/Parts/AndyMark/am-4291 Wobble Goal.STEP

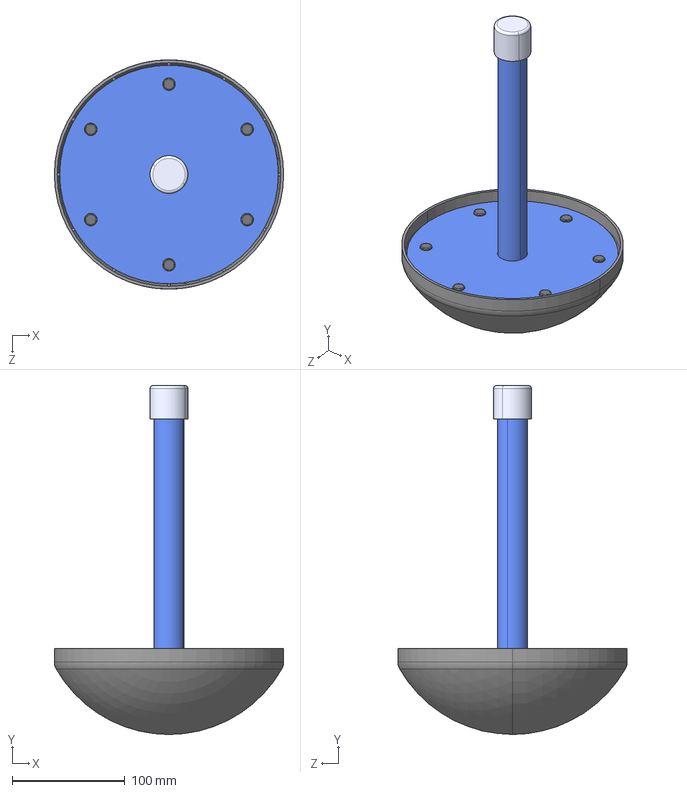
[picture p110: CAD file, 2021-09-24]
2021-22/FTC/Parts/AndyMark/am-4291 Wobble Goal.STEP
203.2 x 309.3 x 203.2 mm
Wobble Goal 2 Molded Lower
Wobble Goal 2 Routed Upper_Red
Wobble Goal 1 Pipe_Red
End Cap
Push In Rivet x 6
