DullesRobotics/ComputerAidedDesign/2021-22/FTC/Parts/AndyMark/am-3259 DART Ram End Bearing REV3.STEP

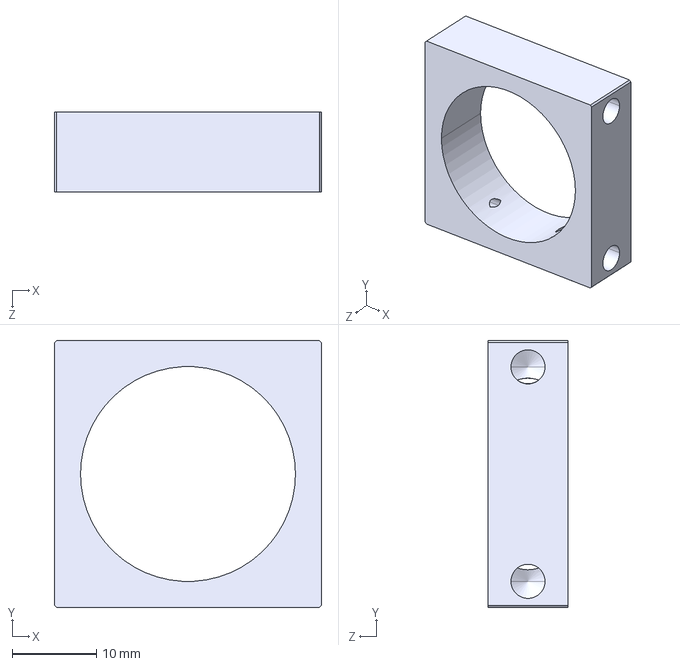
[picture p112: CAD file, 2021-09-24]
2021-22/FTC/Parts/AndyMark/am-3259 DART Ram End Bearing REV3.STEP
31.6 x 31.6 x 9.52 mm
