DullesRobotics/ComputerAidedDesign/2021-22/FTC/Parts/AndyMark/am-3697 Picobox Twin Servo Motor Plate REV2.STEP

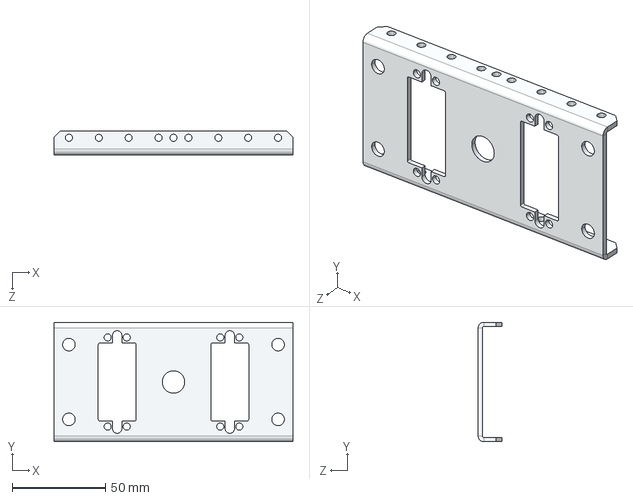
[picture p113: CAD file, 2021-09-24]
2021-22/FTC/Parts/AndyMark/am-3697 Picobox Twin Servo Motor Plate REV2.STEP
128.0 x 64.0 x 12.7 mm
