DullesRobotics/ComputerAidedDesign/2021-22/FTC/Parts/REV Parts/15mm Plastic Lap Corner Bracket - 8 Pack.STEP

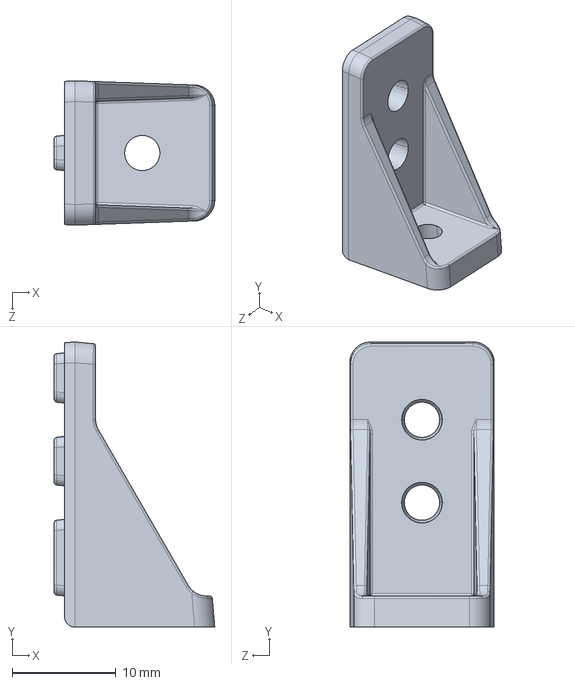
[picture p114: CAD file, 2021-09-05]
2021-22/FTC/Parts/REV Parts/15mm Plastic Lap Corner Bracket - 8 Pack.STEP
15.5 x 27.5 x 13.9 mm
