DullesRobotics/ComputerAidedDesign/2021-22/FTC/Parts/AndyMark/am-0211a Long Toughbox Keyed Shaft.STEP

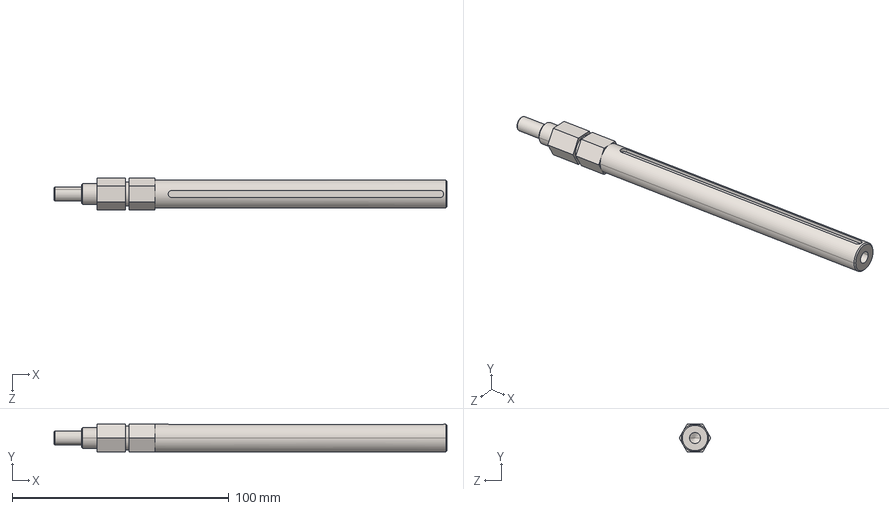
[picture p115: CAD file, 2021-09-24]
2021-22/FTC/Parts/AndyMark/am-0211a Long Toughbox Keyed Shaft.STEP
181.3 x 12.7 x 14.7 mm
am-0211a Long Toughbox Keyed Shaft
250x1000_dowel
