DullesRobotics/ComputerAidedDesign/2021-22/FTC/Parts/AndyMark/am-1438 NR D.shaft Retaining ring 96415A126 REV2.STEP

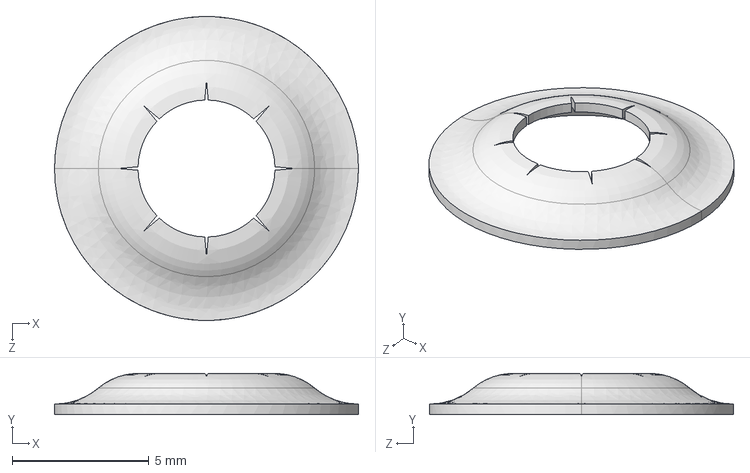
[picture p116: CAD file, 2021-09-24]
2021-22/FTC/Parts/AndyMark/am-1438 NR D.shaft Retaining ring 96415A126 REV2.STEP
11.1 x 1.50 x 11.1 mm
