DullesRobotics/ComputerAidedDesign/2021-22/FTC/Parts/REV Parts/5V Addressable LED Strip - 1m.STEP

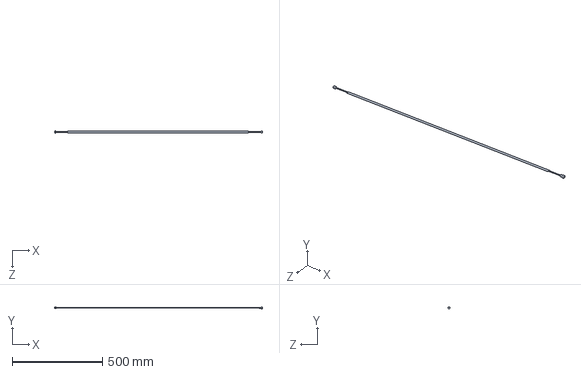
[picture p117: CAD file, 2021-09-05]
2021-22/FTC/Parts/REV Parts/5V Addressable LED Strip - 1m.STEP
1149.9 x 9.10 x 12.0 mm
