DullesRobotics/ComputerAidedDesign/2021-22/FTC/Parts/AndyMark/am-3606 Inside Corner Gusset (S3 Tube).STEP

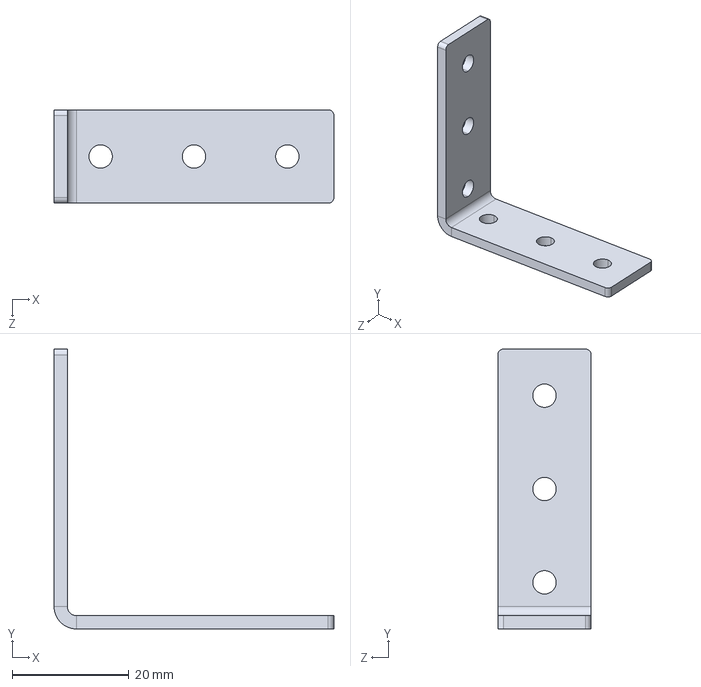
[picture p118: CAD file, 2021-09-24]
2021-22/FTC/Parts/AndyMark/am-3606 Inside Corner Gusset (S3 Tube).STEP
48.0 x 48.0 x 16.0 mm
