DullesRobotics/ComputerAidedDesign/2021-22/FTC/Parts/REV Parts/15mm Metal Inside Corner Bracket V2 - 8 Pack.STEP

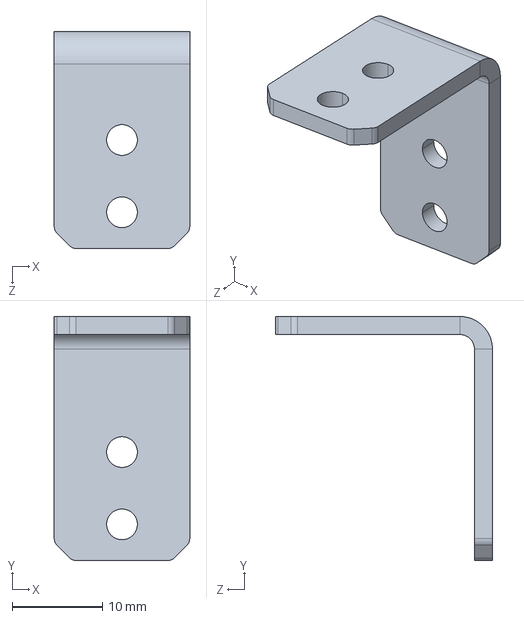
[picture p119: CAD file, 2021-09-05]
2021-22/FTC/Parts/REV Parts/15mm Metal Inside Corner Bracket V2 - 8 Pack.STEP
15.0 x 27.0 x 24.0 mm
