DullesRobotics/ComputerAidedDesign/2021-22/FTC/Parts/AndyMark/am-3350 12T 5mm htd 5-16 bore pulley.STEP

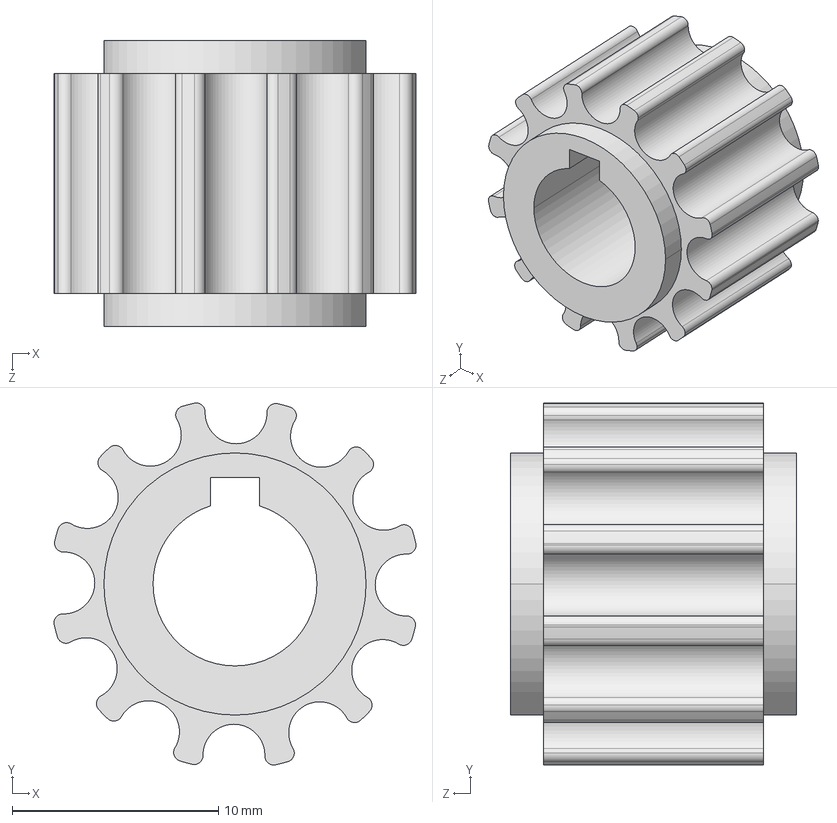
[picture p120: CAD file, 2021-09-24]
2021-22/FTC/Parts/AndyMark/am-3350 12T 5mm htd 5-16 bore pulley.STEP
17.5 x 17.5 x 13.8 mm
