DullesRobotics/ComputerAidedDesign/2021-22/FTC/Parts/REV Parts/5mm Hex Bearing Block.STEP

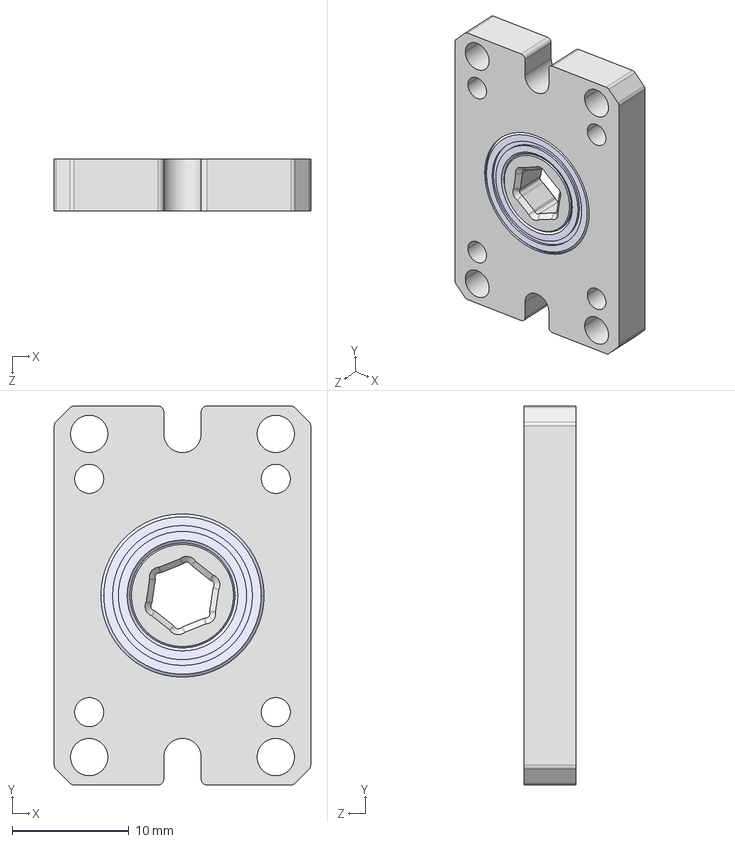
[picture p121: CAD file, 2021-09-05]
2021-22/FTC/Parts/REV Parts/5mm Hex Bearing Block.STEP
22.0 x 32.5 x 4.50 mm
REV-41-1683-1
REV-41-1527
679ZZ
