DullesRobotics/ComputerAidedDesign/2021-22/FTC/Parts/AndyMark/am-0283 0.25IN id, 5-16IN od, 0.5IN Long Bushing REV2.STEP

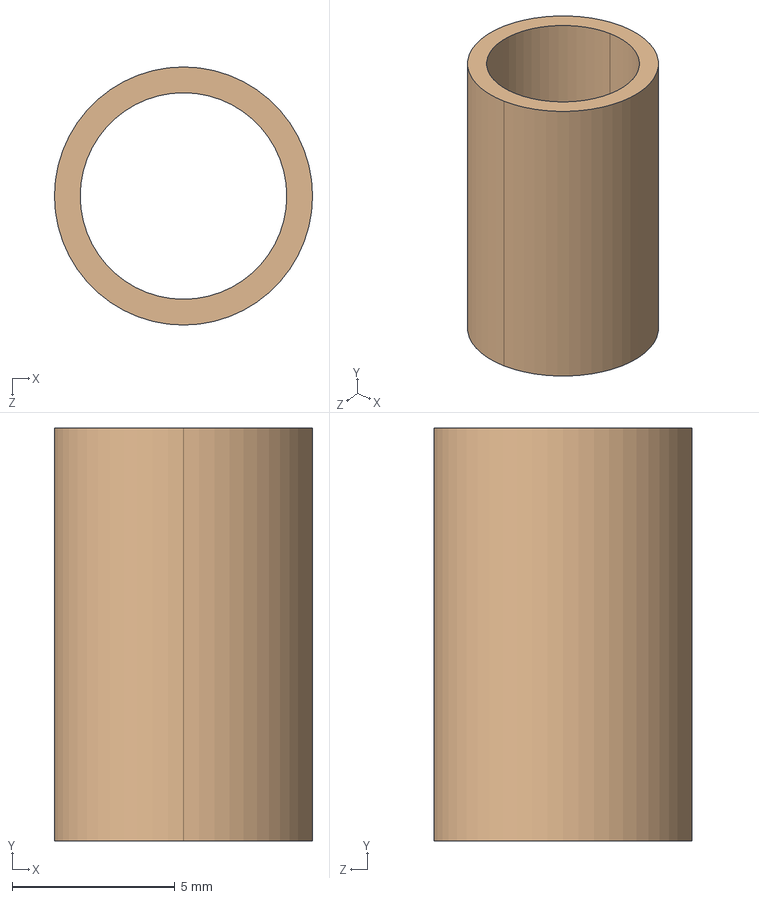
[picture p122: CAD file, 2021-09-24]
2021-22/FTC/Parts/AndyMark/am-0283 0.25IN id, 5-16IN od, 0.5IN Long Bushing REV2.STEP
7.94 x 12.7 x 7.94 mm
