DullesRobotics/ComputerAidedDesign/2021-22/FTC/Parts/REV Parts/Ball Joint Rod End M3 Female - 4 Pack.STEP

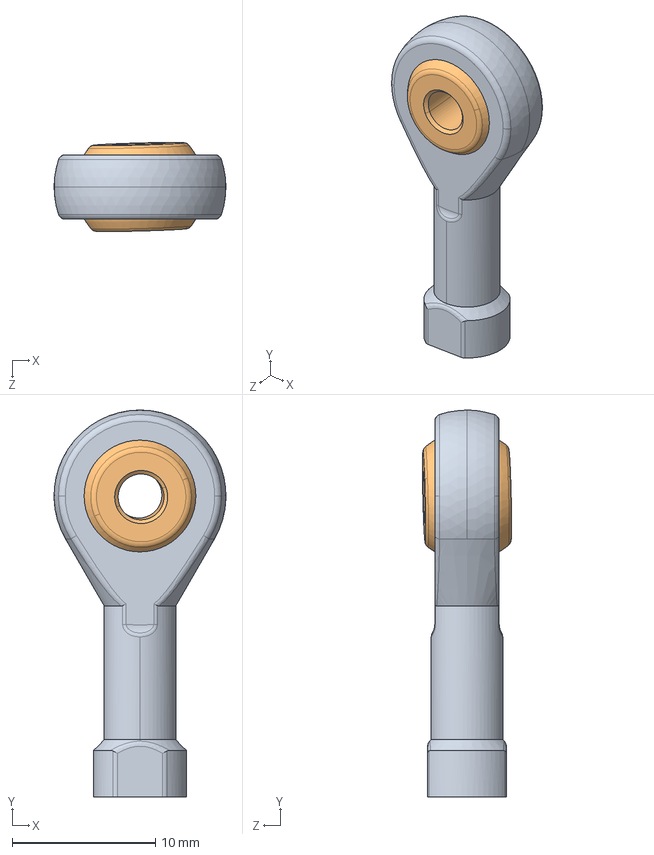
[picture p123: CAD file, 2021-09-05]
2021-22/FTC/Parts/REV Parts/Ball Joint Rod End M3 Female - 4 Pack.STEP
12.0 x 27.0 x 6.22 mm
SI3T-K Body
SI3T-K Ball
