DullesRobotics/ComputerAidedDesign/2021-22/FTC/Parts/AndyMark/am-0653a Toughbox Nano Tube 31 Rev4.STEP

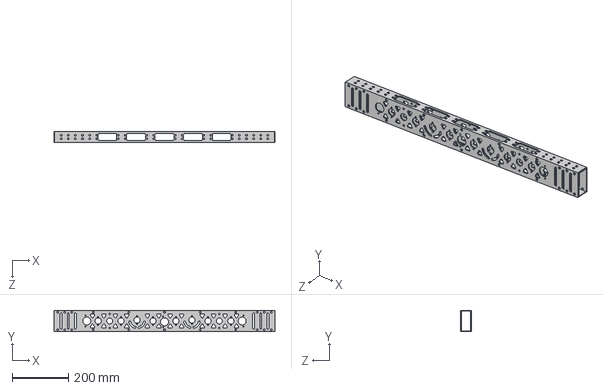
[picture p124: CAD file, 2021-09-24]
2021-22/FTC/Parts/AndyMark/am-0653a Toughbox Nano Tube 31 Rev4.STEP
787.4 x 76.2 x 38.1 mm
