DullesRobotics/ComputerAidedDesign/2021-22/FTC/Parts/REV Parts/M3 Standoff - 25mm - 4 Pack.STEP

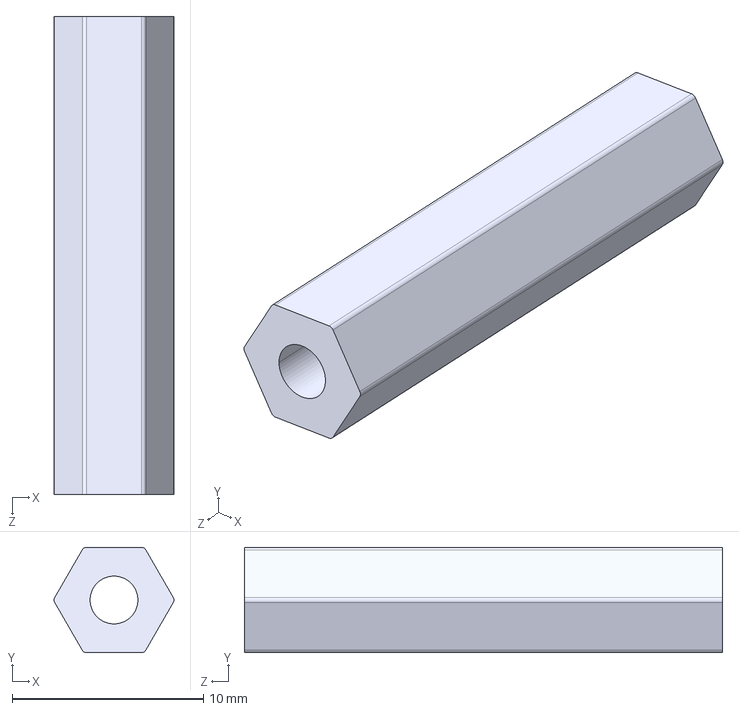
[picture p125: CAD file, 2021-09-05]
2021-22/FTC/Parts/REV Parts/M3 Standoff - 25mm - 4 Pack.STEP
6.27 x 5.50 x 25.0 mm
