DullesRobotics/ComputerAidedDesign/2021-22/FTC/Parts/AndyMark/am-0947 Shoulder Spacer, 0500 id, 0625 od, 0500 long, nylon.STEP

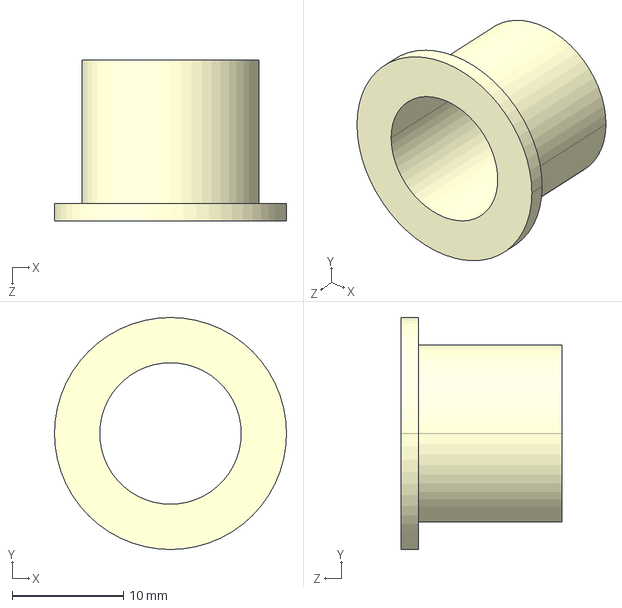
[picture p126: CAD file, 2021-09-24]
2021-22/FTC/Parts/AndyMark/am-0947 Shoulder Spacer, 0500 id, 0625 od, 0500 long, nylon.STEP
20.8 x 20.8 x 14.5 mm
