DullesRobotics/ComputerAidedDesign/2021-22/FTC/Parts/REV Parts/15mm Metal Flat Servo Bracket V2 - 4 Pack.STEP

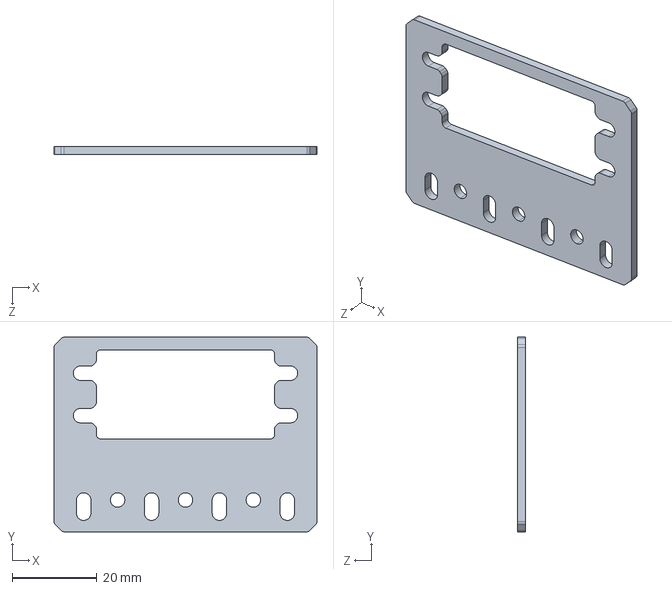
[picture p127: CAD file, 2021-09-05]
2021-22/FTC/Parts/REV Parts/15mm Metal Flat Servo Bracket V2 - 4 Pack.STEP
62.0 x 45.9 x 2.00 mm
