DullesRobotics/ComputerAidedDesign/2021-22/FTC/Parts/AndyMark/am-0043 AMP Ring Gear, 40 Tooth, 32 dp.STEP

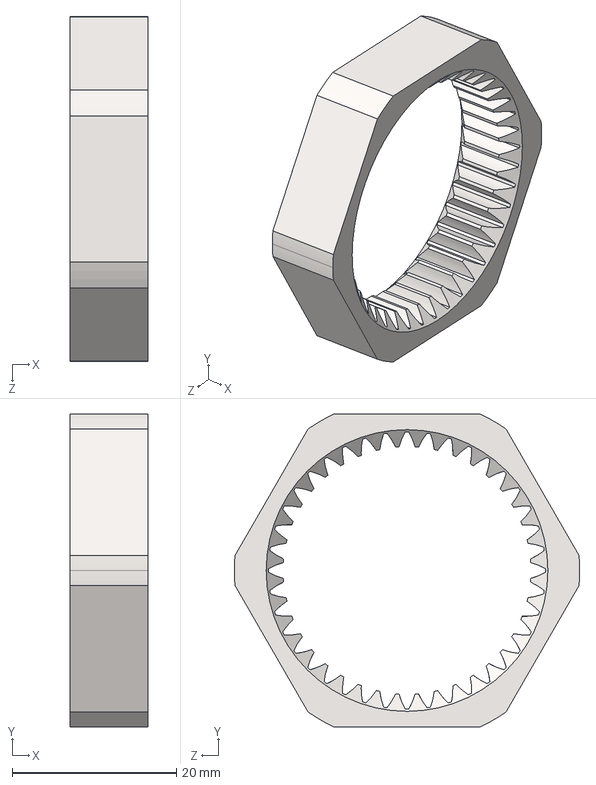
[picture p128: CAD file, 2021-09-24]
2021-22/FTC/Parts/AndyMark/am-0043 AMP Ring Gear, 40 Tooth, 32 dp.STEP
9.53 x 38.1 x 42.0 mm
