DullesRobotics/ComputerAidedDesign/2021-22/FTC/Parts/AndyMark/am-3143 s25-16h-6mm.STEP

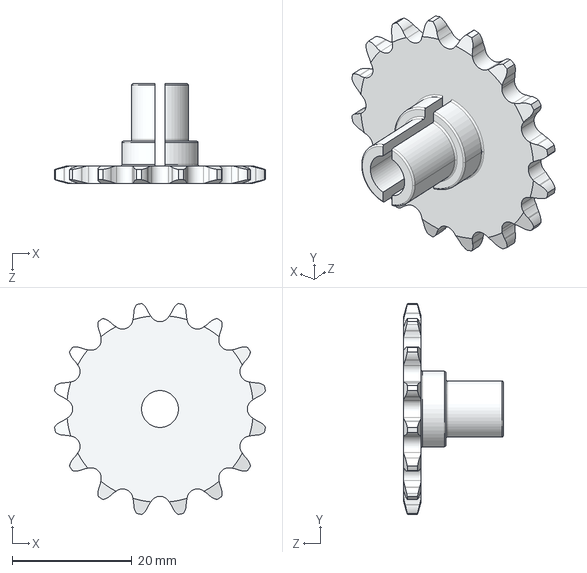
[picture p129: CAD file, 2021-09-24]
2021-22/FTC/Parts/AndyMark/am-3143 s25-16h-6mm.STEP
35.2 x 35.2 x 16.6 mm
