DullesRobotics/ComputerAidedDesign/2021-22/FTC/Parts/REV Parts/Through Bore Bearing - Long - 12 Pack.STEP

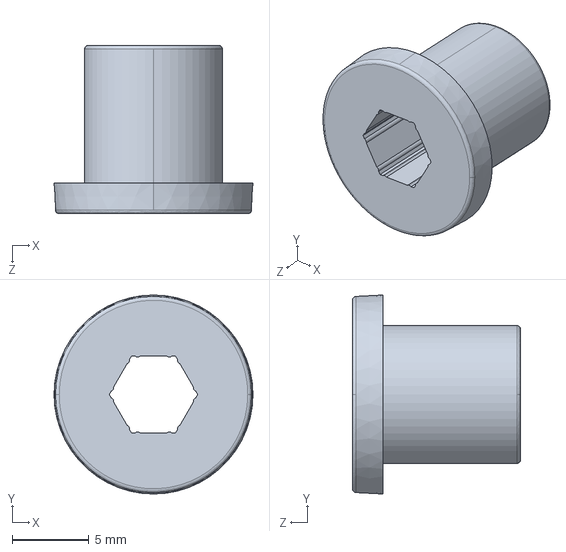
[picture p130: CAD file, 2021-09-05]
2021-22/FTC/Parts/REV Parts/Through Bore Bearing - Long - 12 Pack.STEP
13.0 x 13.0 x 11.0 mm
