DullesRobotics/ComputerAidedDesign/2021-22/FTC/Parts/REV Parts/1in Extrusion  Lift Kit.STEP

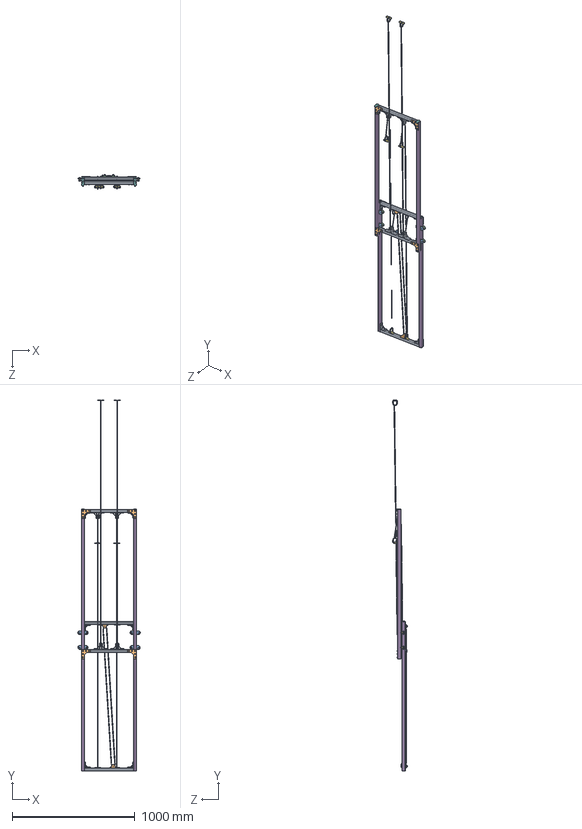
[picture p131: CAD file, 2021-09-05]
2021-22/FTC/Parts/REV Parts/1in Extrusion Lift Kit.STEP
510.4 x 3025.3 x 118.3 mm
REV-21-1000 Cross member x 4
REV-21-1002 x 10
REV-21-1032 x 4
REV-29-1014 x 14
REV-21-1030 x 4
REV-21-1000 x 4
REV-21-1029 x 4
REV-21-1202-2 x 4
1in extrution inside corrner bracket x 14
REV-21-1031 x 2
1in extrution inside corrner bracket_Chain holes
10-32 0.375 inch Long x 50
10-32 Slim Nylock Nut x 88
10-32 0.5 inch Long x 30
socket button head cap screw_ai_SBHCSCREW 0.25-20x1.125-HX-N x 8
#10-32 0.5 Inch Flat-head Socket Cap Screw x 10
93985A309_TYPE 416 SS TIGHT-TOLERANCE SHOULDER SCREW_93985A309 x 2
Belt1-1^2 post lift
Belt4-1^2 post lift
Belt2-2^2 post lift
Belt3-3^2 post lift
Belt5-4^2 post lift
3076T350_TIE-DOWN RING x 8
Bearing Delrin Spacer x 4
