DullesRobotics/ComputerAidedDesign/2021-22/FTC/Parts/AndyMark/am-3461 NeveRest 3.7.STEP

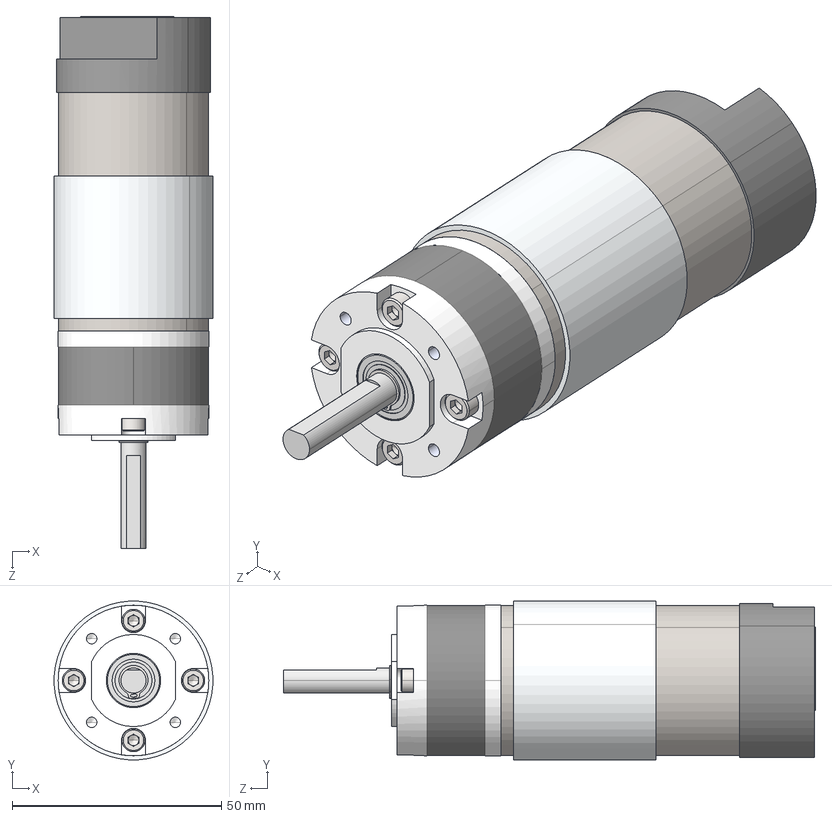
[picture p132: CAD file, 2021-09-24]
2021-22/FTC/Parts/AndyMark/am-3461 NeveRest 3.7.STEP
37.9 x 37.9 x 127.2 mm
NeveRest 4 Gearbox
socket head cap screw_am_B18.3.1M - 3 x 0.5 x 20 Hex SHCS -- 20CHX x 4
basic external retaining ring_am_B27.7M - 3AM1-6
am-3104 NeveRest Motor
686-2Z 6mm bearing_7804K113
