DullesRobotics/ComputerAidedDesign/2021-22/FTC/Parts/REV Parts/15mm Plastic Servo Bracket - 2 Pack.STEP

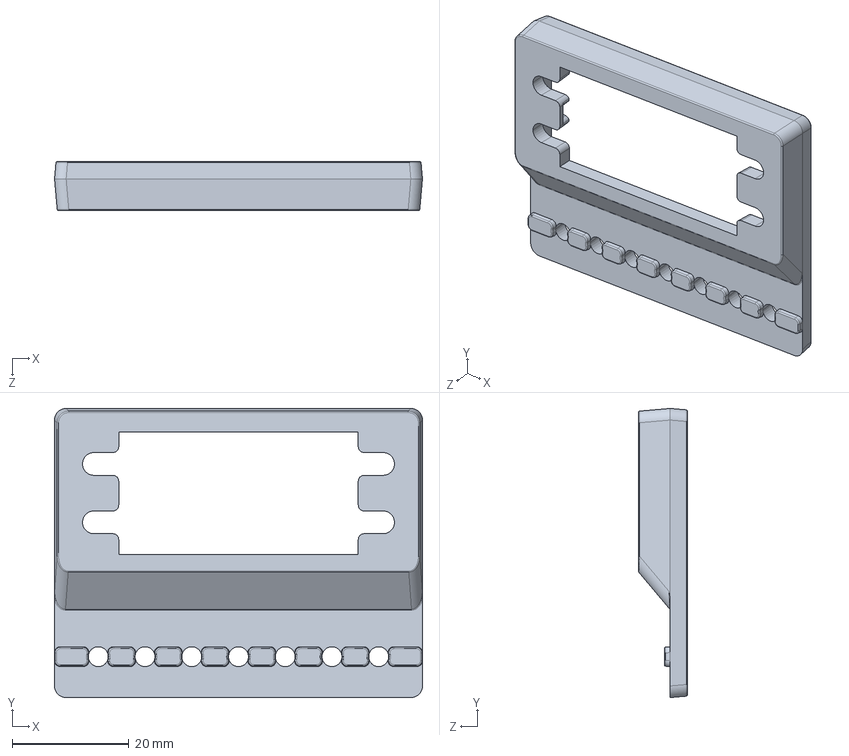
[picture p133: CAD file, 2021-09-05]
2021-22/FTC/Parts/REV Parts/15mm Plastic Servo Bracket - 2 Pack.STEP
63.0 x 49.5 x 8.45 mm
