DullesRobotics/ComputerAidedDesign/2021-22/FTC/Parts/AndyMark/am-0105 8 Perf ThruTread 500 Hex.STEP

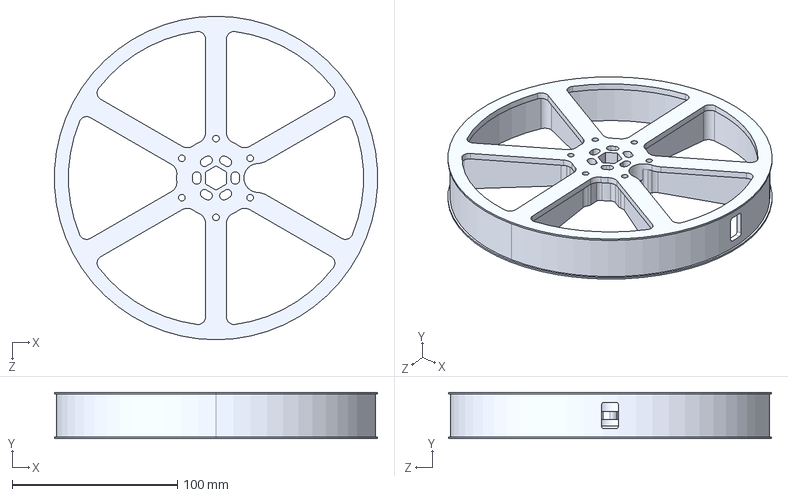
[picture p134: CAD file, 2021-09-24]
2021-22/FTC/Parts/AndyMark/am-0105 8 Perf ThruTread 500 Hex.STEP
195.3 x 27.9 x 195.6 mm
