DullesRobotics/ComputerAidedDesign/2021-22/FTC/Parts/AndyMark/am-3533 85T 32DP 375 Hex Bore Gear.STEP

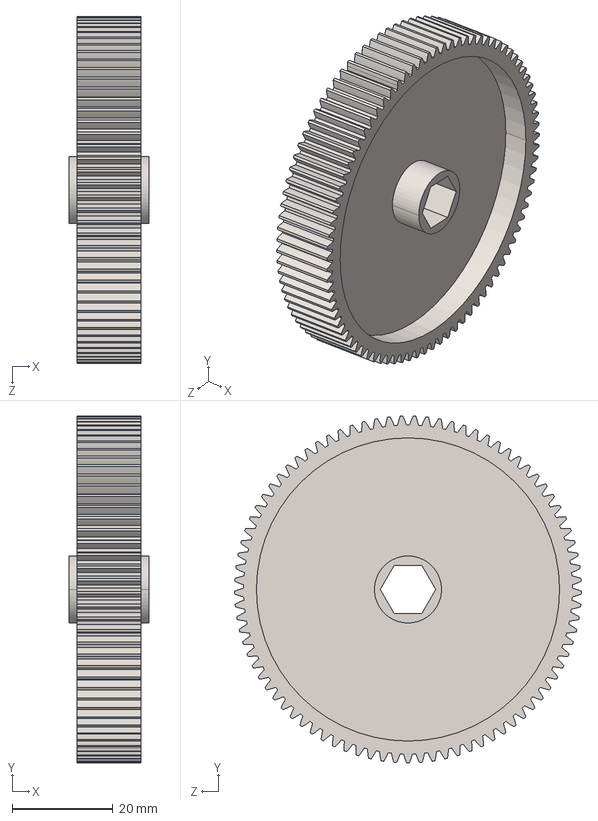
[picture p135: CAD file, 2021-09-24]
2021-22/FTC/Parts/AndyMark/am-3533 85T 32DP 375 Hex Bore Gear.STEP
15.9 x 69.0 x 69.1 mm
