DullesRobotics/ComputerAidedDesign/2021-22/FTC/Parts/REV Parts/15mm Metal HD Inside Corner Bracket - 4 Pack.STEP

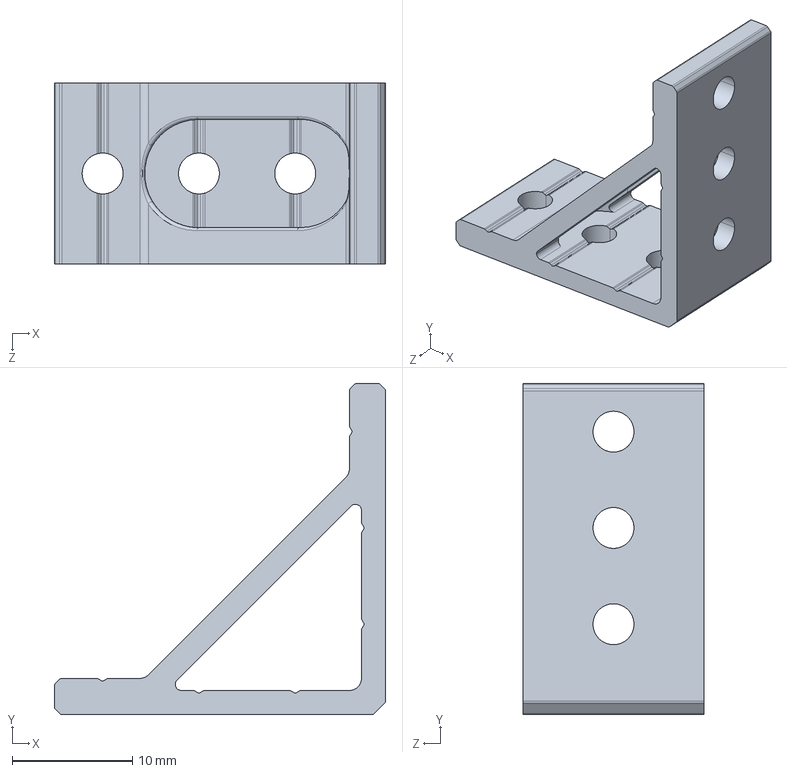
[picture p136: CAD file, 2021-09-05]
2021-22/FTC/Parts/REV Parts/15mm Metal HD Inside Corner Bracket - 4 Pack.STEP
27.5 x 27.5 x 15.0 mm
