DullesRobotics/ComputerAidedDesign/2021-22/FTC/Parts/AndyMark/am-2411 Cylinder, Air, Bimba, 1 116 Dia., 14 SR-0914-DP_2_03.stp

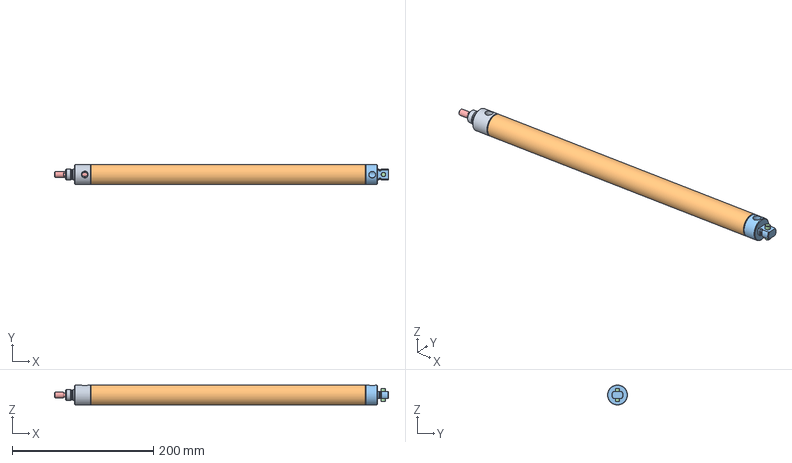
[picture p137: CAD file, 2021-09-24]
2021-22/FTC/Parts/AndyMark/am-2411 Cylinder, Air, Bimba, 1 116 Dia., 14 SR-0914-DP_2_03.stp
473.0 x 28.3 x 28.3 mm
_SR-0914-DPSR0000_0_dummy
_09R000-0_rod_guide
_09R-15.31350SR
_09P0000_rear_head
_D-51
_SR-0914-DP0_rod
