DullesRobotics/ComputerAidedDesign/2021-22/FTC/Parts/REV Parts/U Channel Endcap.STEP

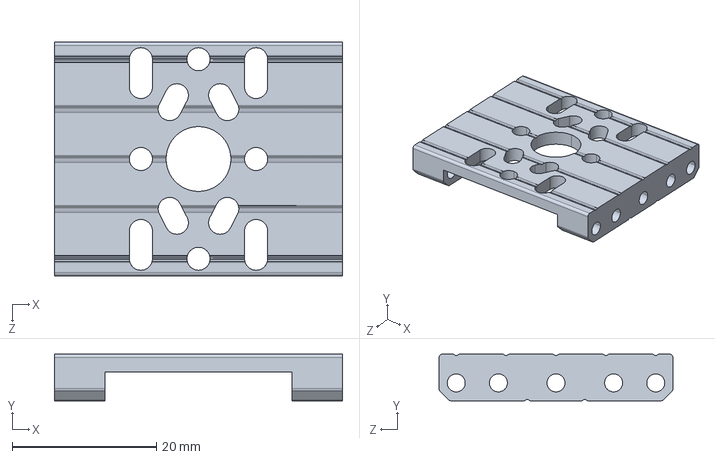
[picture p138: CAD file, 2021-09-05]
2021-22/FTC/Parts/REV Parts/U Channel Endcap.STEP
40.0 x 6.50 x 32.5 mm
