DullesRobotics/ComputerAidedDesign/2021-22/FTC/Parts/AndyMark/am-3872a Lander Leg.STEP

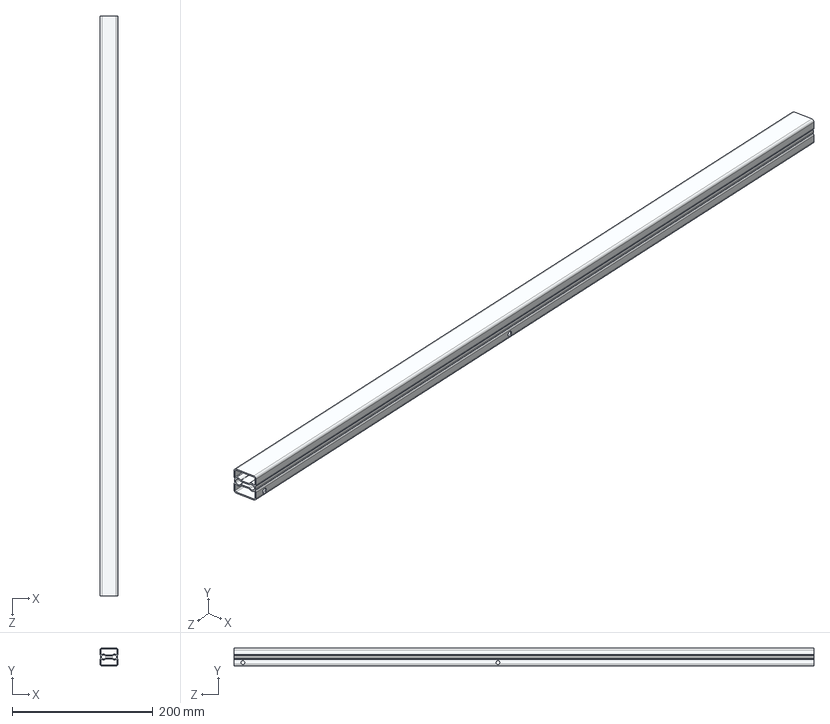
[picture p139: CAD file, 2021-09-24]
2021-22/FTC/Parts/AndyMark/am-3872a Lander Leg.STEP
25.4 x 25.4 x 825.5 mm
