DullesRobotics/ComputerAidedDesign/2021-22/FTC/Parts/REV Parts/15mm Plastic Variable Angle Bracket - 4 Pack.STEP

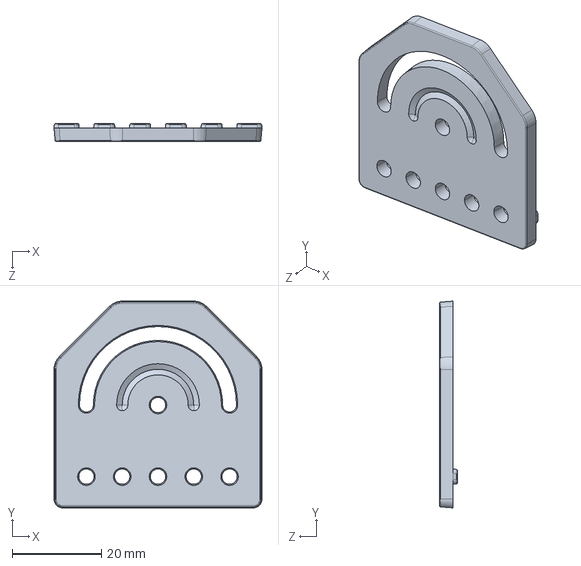
[picture p140: CAD file, 2021-09-05]
2021-22/FTC/Parts/REV Parts/15mm Plastic Variable Angle Bracket - 4 Pack.STEP
46.5 x 46.2 x 4.00 mm
