DullesRobotics/ComputerAidedDesign/2021-22/FTC/Parts/AndyMark/am-0187 17T 20dp 500k.STEP

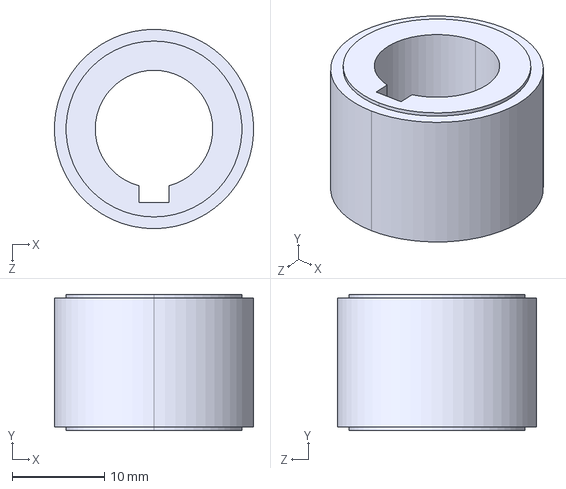
[picture p141: CAD file, 2021-09-24]
2021-22/FTC/Parts/AndyMark/am-0187 17T 20dp 500k.STEP
21.6 x 14.8 x 21.6 mm
