DullesRobotics/ComputerAidedDesign/2021-22/FTC/Parts/REV Parts/15mm UltraSlide - 308mm - 2 Pack.STEP

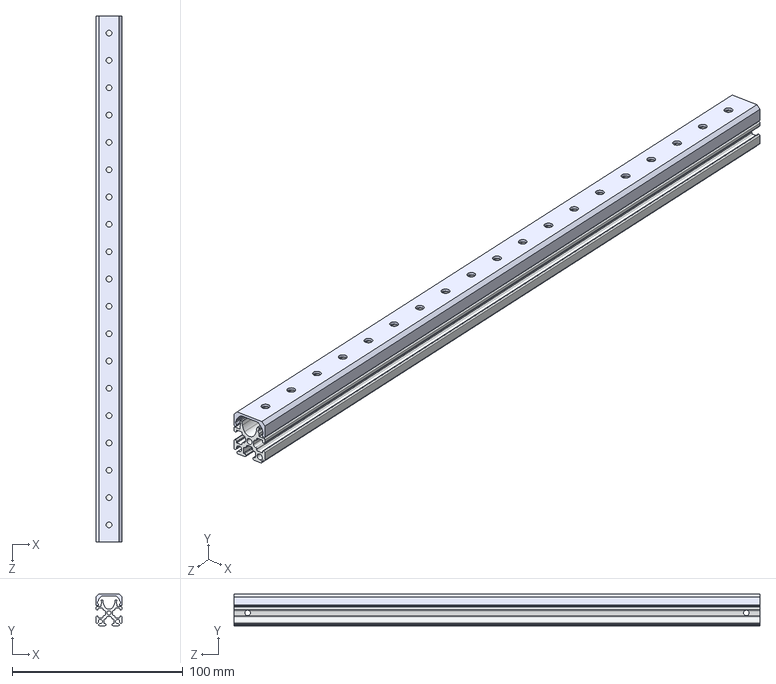
[picture p142: CAD file, 2021-09-05]
2021-22/FTC/Parts/REV Parts/15mm UltraSlide - 308mm - 2 Pack.STEP
15.0 x 18.4 x 308.0 mm
REV-41-1699-1
REV-41-1699-2
