DullesRobotics/ComputerAidedDesign/2021-22/FTC/Parts/AndyMark/am-3769a CIM and Falcon Sport Motor Block Short.STEP

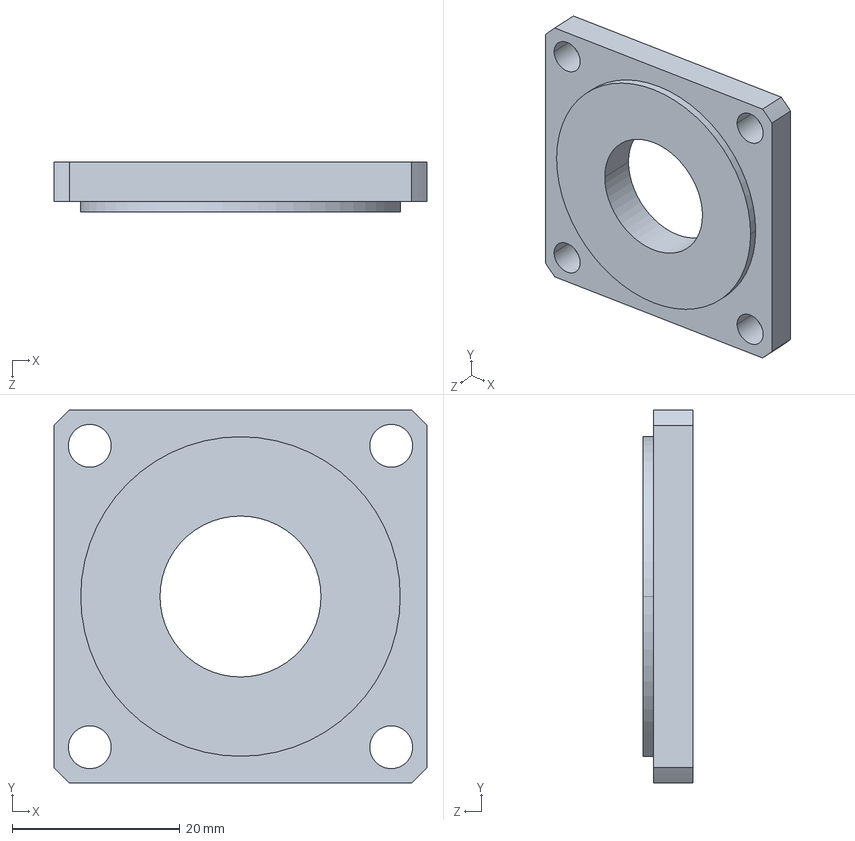
[picture p143: CAD file, 2021-09-24]
2021-22/FTC/Parts/AndyMark/am-3769a CIM and Falcon Sport Motor Block Short.STEP
44.4 x 44.4 x 5.97 mm
