DullesRobotics/ComputerAidedDesign/2021-22/FTC/Parts/REV Parts/15mm Metal Flat Planetary Motor Bracket - 4 Pack.STEP

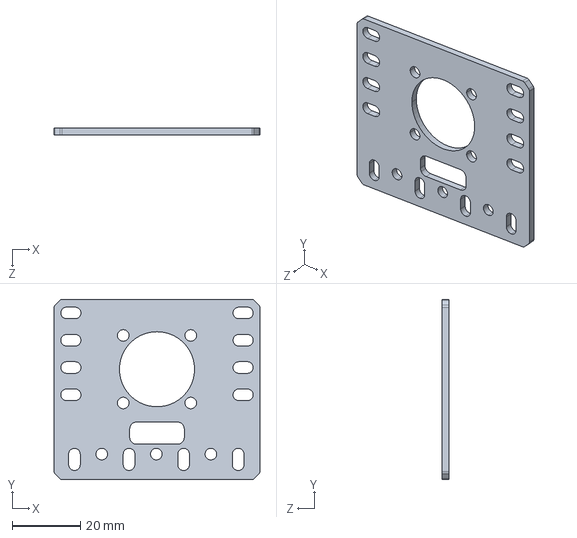
[picture p144: CAD file, 2021-09-05]
2021-22/FTC/Parts/REV Parts/15mm Metal Flat Planetary Motor Bracket - 4 Pack.STEP
60.4 x 52.9 x 2.00 mm
