DullesRobotics/ComputerAidedDesign/2021-22/FTC/Parts/AndyMark/am-4043_Skybridge_Open_End_Cap.STEP

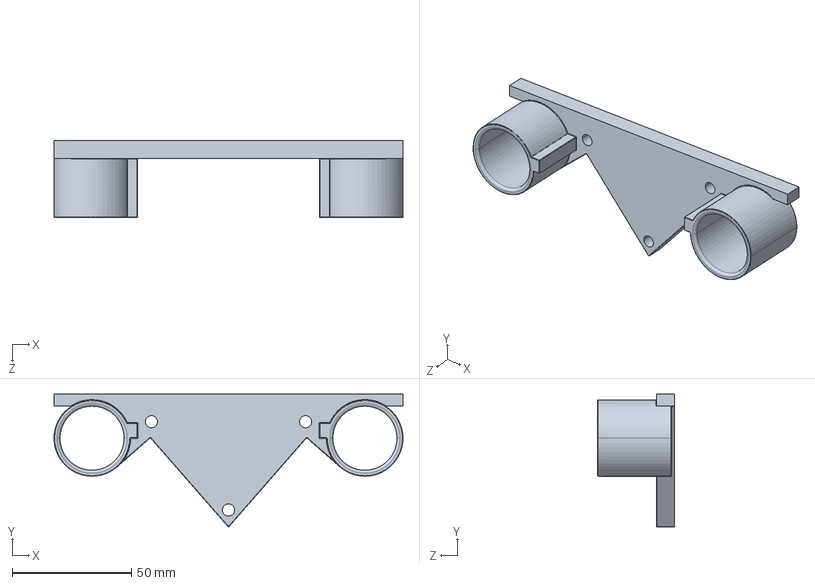
[picture p145: CAD file, 2021-09-24]
2021-22/FTC/Parts/AndyMark/am-4043_Skybridge_Open_End_Cap.STEP
146.5 x 55.7 x 32.4 mm
