DullesRobotics/ComputerAidedDesign/2021-22/FTC/Parts/REV Parts/Shaft Collars - 10 Pack.STEP

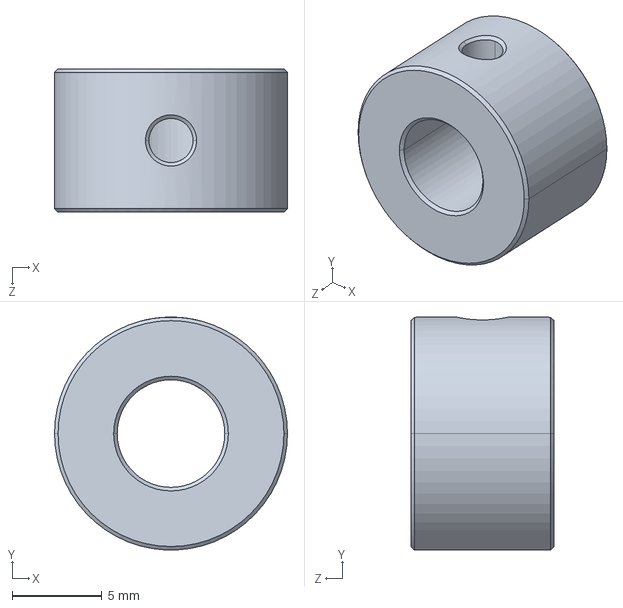
[picture p146: CAD file, 2021-09-05]
2021-22/FTC/Parts/REV Parts/Shaft Collars - 10 Pack.STEP
13.0 x 13.0 x 8.00 mm
