DullesRobotics/ComputerAidedDesign/2021-22/FTC/Parts/AndyMark/am-3594-128 S3 Tube - 128mm.STEP

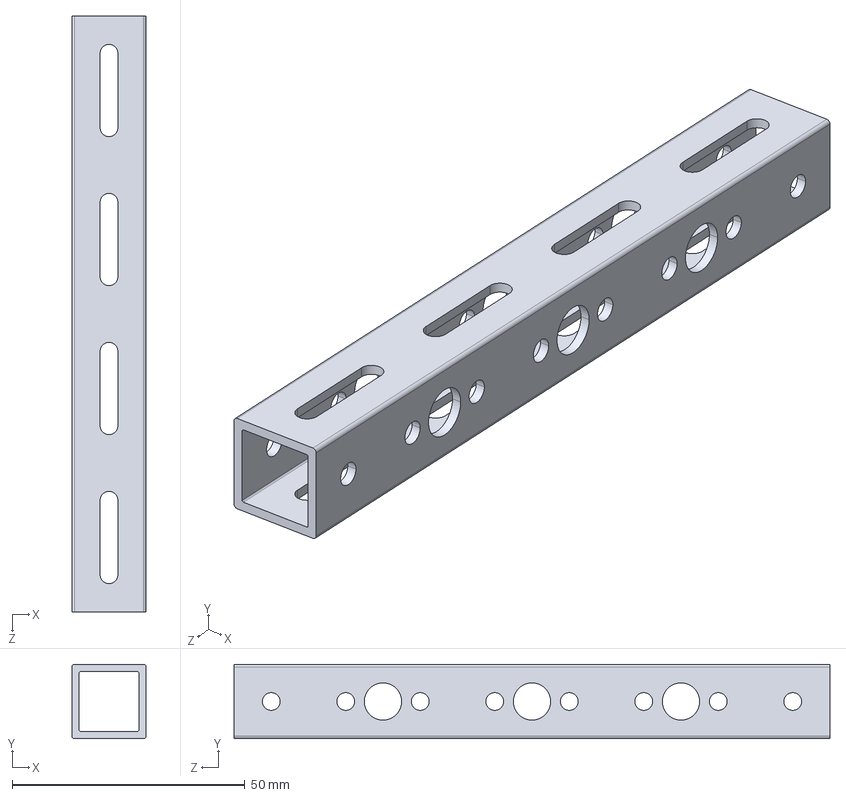
[picture p147: CAD file, 2021-09-24]
2021-22/FTC/Parts/AndyMark/am-3594-128 S3 Tube - 128mm.STEP
16.0 x 16.0 x 128.0 mm
