DullesRobotics/ComputerAidedDesign/2021-22/FTC/Parts/AndyMark/am-3335 Rocketbox Cluster Shaft Spacer REV2.STEP

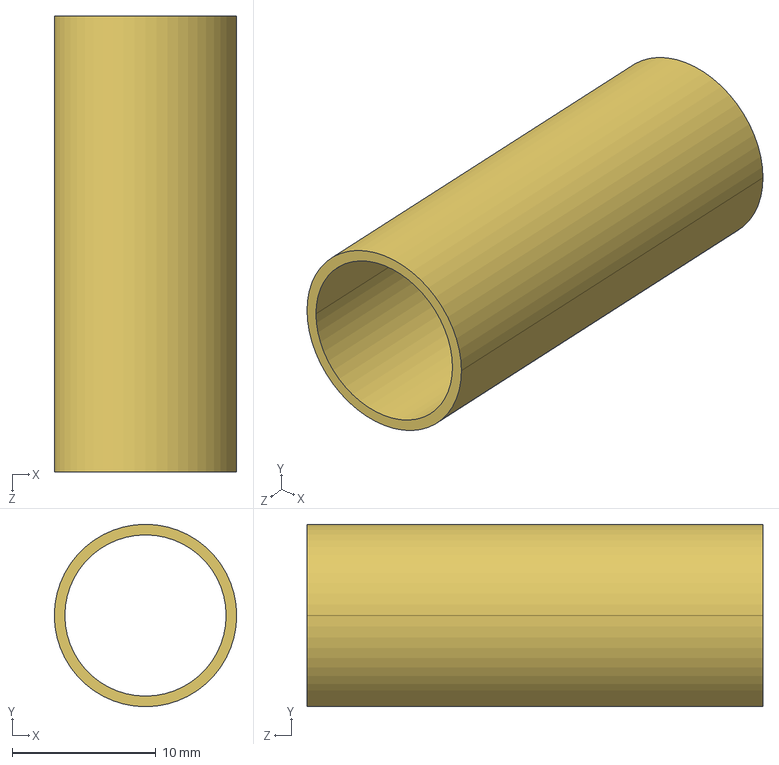
[picture p148: CAD file, 2021-09-24]
2021-22/FTC/Parts/AndyMark/am-3335 Rocketbox Cluster Shaft Spacer REV2.STEP
12.7 x 12.7 x 31.8 mm
