DullesRobotics/ComputerAidedDesign/2021-22/FTC/Parts/REV Parts/SPARK MAX Data Port Breakout Board.STEP

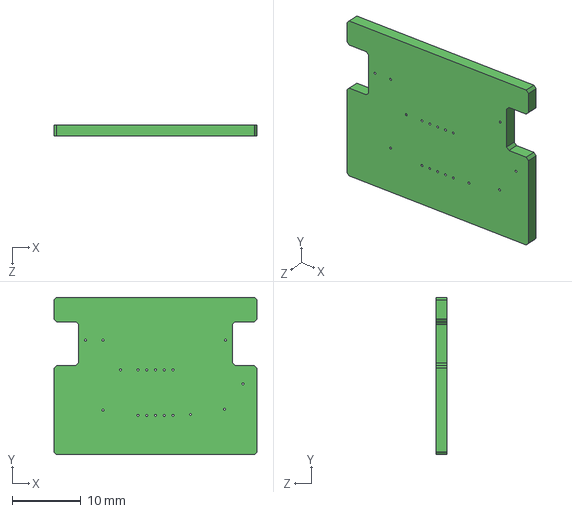
[picture p149: CAD file, 2021-09-05]
2021-22/FTC/Parts/REV Parts/SPARK MAX Data Port Breakout Board.STEP
29.5 x 22.9 x 1.60 mm
