DullesRobotics/ComputerAidedDesign/2021-22/FTC/Parts/AndyMark/am-4203 1x1x0625 wall tubing.STEP

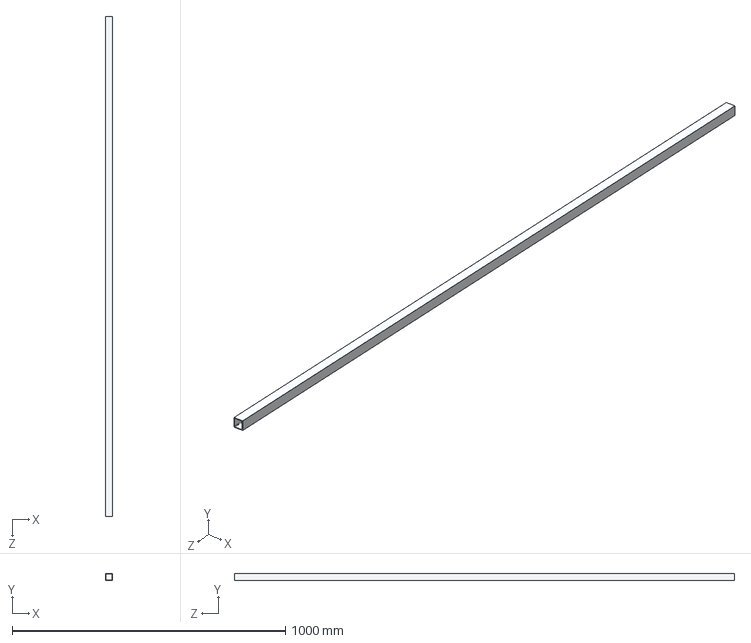
[picture p150: CAD file, 2021-09-24]
2021-22/FTC/Parts/AndyMark/am-4203 1x1x0625 wall tubing.STEP
25.4 x 25.4 x 1828.8 mm
