DullesRobotics/ComputerAidedDesign/(list of files, cad)

Other CAD files:
2021-22/FTC/Parts/AndyMark/am-3038 SSS Shift Body Assy.STEP
2021-22/FRC/STL Files/FRC Pit Hookv4.stl
2021-22/FRC/STL Files/FRC Pit Hookv2.stl
2021-22/FTC/#12456 Big Red/STL Files/Stationary Bearing Bracket Aligner.stl
2021-22/FTC/#12456 Big Red/STL Files/Pulley because david hates it.stl
2021-22/FTC/#12456 Big Red/STL Files/Gobilda 1620 side motor mount.stl
2021-22/FTC/#12456 Big Red/STL Files/45 degree inside angle bracket left.stl
2021-22/FTC/Parts/AndyMark/am-0863 Rail Spacer for Modulox.STEP
2021-22/FRC/FRC Pit Hook.ipt
2021-22/FTC/#12456 Big Red/Big Red Basic Capstone.ipt
2021-22/FTC/#12456 Big Red/Drivetrain/Omni Wheel Drive/1.5mm Spacers - 28 Pack.ipt
2021-22/FTC/#12456 Big Red/Drivetrain/Omni Wheel Drive/10 Tooth #25 Sprocket - 4 Pack.ipt
2021-22/FTC/#12456 Big Red/Drivetrain/Omni Wheel Drive/15mm Bearing Pillow Block - 8 Pack.ipt
2021-22/FTC/#12456 Big Red/Drivetrain/Omni Wheel Drive/15mm Extrusion - 1m - 90° Ends.ipt
2021-22/FTC/#12456 Big Red/Drivetrain/Omni Wheel Drive/15mm Extrusion - 319.3mm - 90° Ends.ipt
2021-22/FTC/#12456 Big Red/Drivetrain/Omni Wheel Drive/15mm Extrusion - 34.4mm - 90° Ends.ipt
2021-22/FTC/#12456 Big Red/Drivetrain/Omni Wheel Drive/15mm Extrusion - 420mm - 90° Ends.ipt
2021-22/FTC/#12456 Big Red/Drivetrain/Omni Wheel Drive/15mm Extrusion - 420mm - 90° Ends_CPY.ipt
2021-22/FTC/#12456 Big Red/Drivetrain/Omni Wheel Drive/15mm Extrusion - 7.5in - 90 Ends.ipt
2021-22/FTC/#12456 Big Red/Drivetrain/Omni Wheel Drive/15mm Plastic Inside Corner Bracket - 8 Pack.ipt
2021-22/FTC/#12456 Big Red/Drivetrain/Omni Wheel Drive/15mm Plastic Lap Corner Bracket - 8 Pack.ipt
2021-22/FTC/#12456 Big Red/Drivetrain/Omni Wheel Drive/26 Tooth #25 Sprocket - 4 Pack.ipt
2021-22/FTC/#12456 Big Red/Drivetrain/Omni Wheel Drive/3mm Spacer - 16 Pack.ipt
2021-22/FTC/#12456 Big Red/Drivetrain/Omni Wheel Drive/5202 Series Yellow Jacket planetary Gear Small Motor Mount.ipt
2021-22/FTC/#12456 Big Red/Drivetrain/Omni Wheel Drive/Custom Gears.iam
2021-22/FTC/#12456 Big Red/Drivetrain/Omni Wheel Drive/Custom Gears/Design Accelerator/OldVersions/Spur Gear12.0003.ipt
2021-22/FTC/#12456 Big Red/Drivetrain/Omni Wheel Drive/Custom Gears/Design Accelerator/OldVersions/Spur Gear13.0001.ipt
2021-22/FTC/#12456 Big Red/Drivetrain/Omni Wheel Drive/Custom Gears/Design Accelerator/OldVersions/Spur Gear21.0002.ipt
2021-22/FTC/#12456 Big Red/Drivetrain/Omni Wheel Drive/Custom Gears/Design Accelerator/OldVersions/Spur Gear22.0001.ipt
2021-22/FTC/#12456 Big Red/Drivetrain/Omni Wheel Drive/Custom Gears/Design Accelerator/Spur Gear11.ipt
2021-22/FTC/#12456 Big Red/Drivetrain/Omni Wheel Drive/Custom Gears/Design Accelerator/Spur Gear12.ipt
2021-22/FTC/#12456 Big Red/Drivetrain/Omni Wheel Drive/Custom Gears/Design Accelerator/Spur Gear13.ipt
2021-22/FTC/#12456 Big Red/Drivetrain/Omni Wheel Drive/Custom Gears/Design Accelerator/Spur Gear21.ipt
2021-22/FTC/#12456 Big Red/Drivetrain/Omni Wheel Drive/Custom Gears/Design Accelerator/Spur Gear22.ipt
2021-22/FTC/#12456 Big Red/Drivetrain/Omni Wheel Drive/Custom Gears/Design Accelerator/Spur Gears1.iam
2021-22/FTC/#12456 Big Red/Drivetrain/Omni Wheel Drive/Custom Gears/Design Accelerator/Spur Gears2.iam
2021-22/FTC/#12456 Big Red/Drivetrain/Omni Wheel Drive/Custom Gears/Design Accelerator/Spur Gears3.iam
2021-22/FTC/#12456 Big Red/Drivetrain/Omni Wheel Drive/Custom Gears/Shaft1.ipt
2021-22/FTC/#12456 Big Red/Drivetrain/Omni Wheel Drive/Custom Gears/Shaft2.ipt
2021-22/FTC/#12456 Big Red/Drivetrain/Omni Wheel Drive/Custom Gears/Shaft3.ipt
2021-22/FTC/#12456 Big Red/Drivetrain/Omni Wheel Drive/Drivetrain V1.iam
2021-22/FTC/#12456 Big Red/Drivetrain/Omni Wheel Drive/Drivetrain.iam
2021-22/FTC/#12456 Big Red/Drivetrain/Omni Wheel Drive/Gobilda 1620 motor mount with motor.iam
2021-22/FTC/#12456 Big Red/Drivetrain/Omni Wheel Drive/Gobilda 1620 motor mount.ipt
2021-22/FTC/#12456 Big Red/Drivetrain/Omni Wheel Drive/Gobilda 1620 side motor mount.ipt
2021-22/FTC/#12456 Big Red/Drivetrain/Omni Wheel Drive/High Strength Hex Hub - 2 Pack.ipt
2021-22/FTC/#12456 Big Red/Drivetrain/Omni Wheel Drive/Idler Sprocket.iam
2021-22/FTC/#12456 Big Red/Drivetrain/Omni Wheel Drive/OldVersions/15mm Extrusion - 319.3mm - 90° Ends.0001.ipt
2021-22/FTC/#12456 Big Red/Drivetrain/Omni Wheel Drive/OldVersions/15mm Extrusion - 34.4mm - 90° Ends.0001.ipt
2021-22/FTC/#12456 Big Red/Drivetrain/Omni Wheel Drive/OldVersions/15mm Extrusion - 420mm - 90° Ends.0001.ipt
2021-22/FTC/#12456 Big Red/Drivetrain/Omni Wheel Drive/OldVersions/15mm Extrusion - 7.5in - 90 Ends.0001.ipt
2021-22/FTC/#12456 Big Red/Drivetrain/Omni Wheel Drive/OldVersions/5202 Series Yellow Jacket planetary Gear Small Motor Mount.0004.ipt
2021-22/FTC/#12456 Big Red/Drivetrain/Omni Wheel Drive/OldVersions/Custom Gears.0002.iam
2021-22/FTC/#12456 Big Red/Drivetrain/Omni Wheel Drive/OldVersions/Drivetrain.0010.iam
2021-22/FTC/#12456 Big Red/Drivetrain/Omni Wheel Drive/OldVersions/Gobilda 1620 motor mount with motor.0003.iam
2021-22/FTC/#12456 Big Red/Drivetrain/Omni Wheel Drive/OldVersions/Gobilda 1620 motor mount.0002.ipt
2021-22/FTC/#12456 Big Red/Drivetrain/Omni Wheel Drive/OldVersions/Gobilda 1620 side motor mount.0004.ipt
2021-22/FTC/#12456 Big Red/Drivetrain/Omni Wheel Drive/OldVersions/Idler Sprocket.0001.iam
2021-22/FTC/#12456 Big Red/Drivetrain/Omni Wheel Drive/OldVersions/omni wheels-26 tooth sproket.0001.iam
2021-22/FTC/#12456 Big Red/Drivetrain/Omni Wheel Drive/Through Bore Bearing - Long - 12 Pack.ipt
2021-22/FTC/#12456 Big Red/Drivetrain/Omni Wheel Drive/Through Bore Bearing - Short - 12 Pack.ipt
2021-22/FTC/#12456 Big Red/Drivetrain/Omni Wheel Drive/omni wheels-26 tooth sproket.iam
2021-22/FTC/#12456 Big Red/Duck carosel/Ducky caro.iam
2021-22/FTC/#12456 Big Red/Duck carosel/OldVersions/Ducky caro.0001.iam
2021-22/FTC/#12456 Big Red/Out Take/Active Lever Parts/15mm Extrusion - 100mm - 90° Ends.ipt
2021-22/FTC/#12456 Big Red/Out Take/Active Lever Parts/15mm Extrusion - 150mm - 90° Ends.ipt
2021-22/FTC/#12456 Big Red/Out Take/Active Lever Parts/15mm Extrusion - 1m - 90° Ends.ipt
2021-22/FTC/#12456 Big Red/Out Take/Active Lever Parts/15mm Extrusion - 94.5mm - 90° Ends.ipt
2021-22/FTC/#12456 Big Red/Out Take/Active Lever Parts/OldVersions/15mm Extrusion - 1m - 90° Ends.0002.ipt
2021-22/FTC/#12456 Big Red/Out Take/Active Lever Parts/OldVersions/15mm Hex Hub.0003.ipt
2021-22/FTC/#12456 Big Red/Out Take/Bearing Bushing.ipt
2021-22/FTC/#12456 Big Red/Out Take/Duck Carousel/15mm Extrusion - 120mm - 90° Ends - 2 Pack.ipt
2021-22/FTC/#12456 Big Red/Out Take/Duck Carousel/3mm Spacer - 16 Pack.ipt
2021-22/FTC/#12456 Big Red/Out Take/Duck Carousel/Duck Carousel.iam
2021-22/FTC/#12456 Big Red/Out Take/Duck Carousel/M3 Nyloc Nuts - 100 Pack.ipt
2021-22/FTC/#12456 Big Red/Out Take/Duck Carousel/M3 x 8mm Hex Cap Screws - 100 Pack.ipt
2021-22/FTC/#12456 Big Red/Out Take/Duck Carousel/OldVersions/Assembly2.0012.iam
2021-22/FTC/#12456 Big Red/Out Take/Duck Carousel/OldVersions/Carousel.0001.ipt
2021-22/FTC/#12456 Big Red/Out Take/Duck Carousel/OldVersions/Duck Carousel.0002.iam
2021-22/FTC/#12456 Big Red/Out Take/Duck Carousel/OldVersions/M3 x 8mm Hex Cap Screws - 100 Pack.0002.ipt
2021-22/FTC/#12456 Big Red/Out Take/Duck Carousel/OldVersions/REV-21-1843.0002.ipt
2021-22/FTC/#12456 Big Red/Out Take/Duck Carousel/OldVersions/REV-21-1844.0002.ipt
2021-22/FTC/#12456 Big Red/Out Take/Duck Carousel/OldVersions/REV-41-1320.0001.ipt
2021-22/FTC/#12456 Big Red/Out Take/Duck Carousel/OldVersions/REV-41-1349.0001.ipt
2021-22/FTC/#12456 Big Red/Out Take/Duck Carousel/OldVersions/REV-41-1791.0001.ipt
2021-22/FTC/#12456 Big Red/Out Take/Duck Carousel/OldVersions/wheel.0001.iam
2021-22/FTC/#12456 Big Red/Out Take/Duck Carousel/REV-41-1123.ipt
2021-22/FTC/#12456 Big Red/Out Take/Duck Carousel/REV-41-1320.ipt
2021-22/FTC/#12456 Big Red/Out Take/Duck Carousel/REV-41-1349.ipt
2021-22/FTC/#12456 Big Red/Out Take/Duck Carousel/REV-41-1431.ipt
2021-22/FTC/#12456 Big Red/Out Take/Duck Carousel/REV-41-1433.ipt
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
