DullesRobotics/ComputerAidedDesign/2021-22/FTC/Parts/AndyMark/am-4042a Barrier Pipe Anchor.PDF

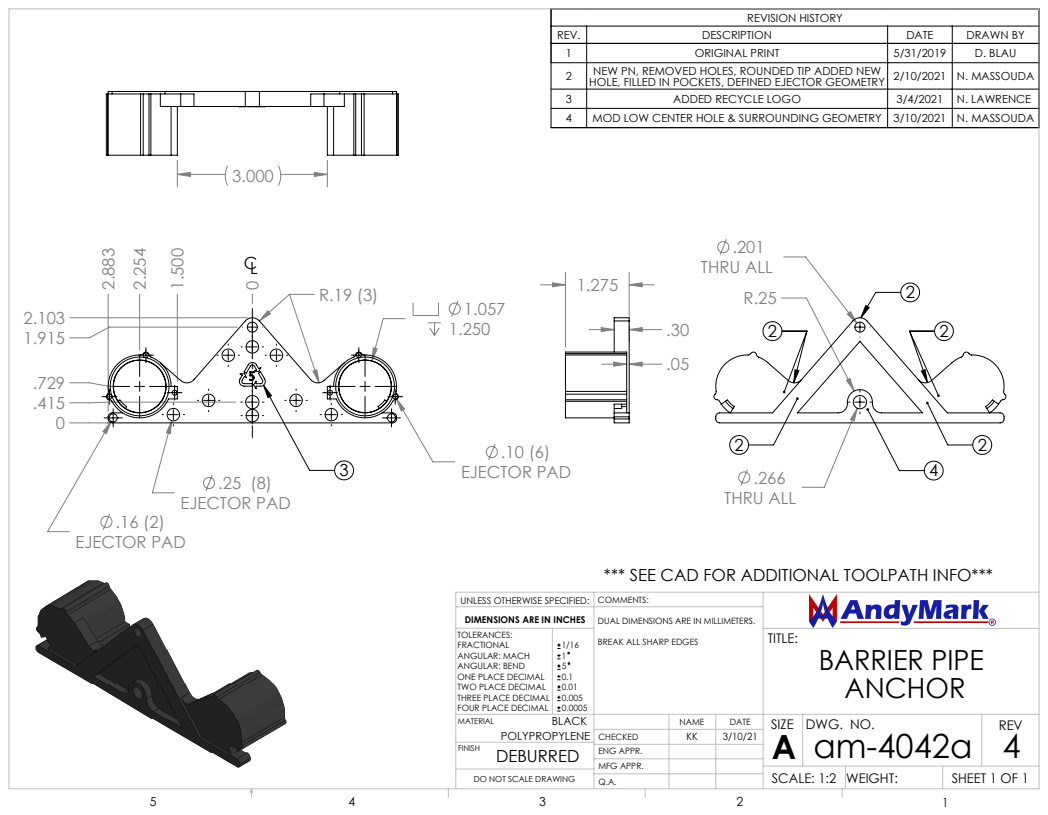
[picture p189: page 1]
.25 (8) EJECTOR PAD; .16 (2) EJECTOR PAD; .10 (6) EJECTOR PAD; THRU ALL; REVISION HISTORY; BARRIER PIPE; SHEET 1 OF 1; SCALE: 1:2 WEIGHT:; DWG. NO.; REV; MFG APPR.; ENG APPR.

REV. | DESCRIPTION | DATE | DRAWN BY
1 | ORIGINAL PRINT | 5/31/2019 | D. BLAU
2 | NEW PN, REMOVED HOLES, ROUNDED TIP ADDED NEW HOLE, FILLED IN POCKETS, DEFINED EJECTOR GEOMETRY | 2/10/2021 | N. MASSOUDA
3 | ADDED RECYCLE LOGO | 3/4/2021 | N. LAWRENCE
4 | MOD LOW CENTER HOLE & SURROUNDING GEOMETRY | 3/10/2021 | N. MASSOUDA

*** SEE CAD FOR ADDITIONAL TOOLPATH INFO***

UNLESS OTHERWISE SPECIFIED:
DIMENSIONS ARE IN INCHES
TOLERANCES:
FRACTIONAL
ANGULAR: MACH
ANGULAR: BEND
ONE PLACE DECIMAL
TWO PLACE DECIMAL
THREE PLACE DECIMAL
FOUR PLACE DECIMAL
MATERIAL
POLYPROPYLENE
DEBURRED

COMMENTS:
DUAL DIMENSIONS ARE IN MILLIMETERS.
BREAK ALL SHARP EDGES

DO NOT SCALE DRAWING
