DullesRobotics/ComputerAidedDesign/(commit log)

2021-09-05 Housekeeping
    moving into github :smile:
    [#10-32 12in Button-head Socket Cap Screw - 100 Pack.STEP, #10-32 12in Flat-head Socket Cap Screw - 25 Pack.STEP, #10-32 38in Button-head Socket Cap Screw - 100 Pack.STEP, #10-32 Low Profile Nylon Lock Nut - 100 Pack.STEP, 1.25in Roller Endcap.STEP, 1.25in Roller Tubing - 3ft.STEP, 1.5mm Spacers - 28 Pack.STEP, 10 Tooth #25 Sprocket - 4 Pack.STEP]
2021-09-08 15 STEP to IPT
    [#10-32 12in Button-head Socket Cap Screw - 100 Pack.ipt, #10-32 12in Flat-head Socket Cap Screw - 25 Pack.ipt, #10-32 38in Button-head Socket Cap Screw - 100 Pack.ipt, #10-32 Low Profile Nylon Lock Nut - 100 Pack.ipt, 1.25in Roller Endcap.ipt, 1.25in Roller Tubing - 3ft.ipt, 1.5mm Spacers - 28 Pack.ipt, 1in 120 Degree Bracket.ipt]
2021-09-18 Dual omni wheel
    [26 Tooth #25 Sprocket - 4 Pack.ipt, 90mm dual omni wheels.0002.iam, 90mm dual omni wheels.iam]
2021-09-24 AndyMark Parts Library
    [TEaching.0001.ipt, TEaching.ipt, TEcahing.0002.iam, TEcahing.iam, Zohair did a thing.ipt, am-0004 AMS Outside Plate REV5.STEP, am-0020 Dog Gear.STEP, am-0020d Three Tooth Dog Gear REV5.STEP]
2021-10-01 13 in drivetrain start
    [13 in^3 drivetrain.0001.iam, 13 in^3 drivetrain.iam, 15mm Extrusion - 330.2mm - 90° Ends.ipt, Motor_Mount_v1.step]
2021-10-02 Drive Train Frame
    [13 in^3 drivetrain.0001.iam, 13 in^3 drivetrain.0003.iam, 13 in^3 drivetrain.iam, 15mm Bearing Pillow Block - 8 Pack.ipt, 15mm Extrusion - 13in - 90° Ends.ipt, 15mm Extrusion - 2.5in - 90° Ends.0001.ipt, 15mm Extrusion - 2.5in - 90° Ends.ipt, 15mm Extrusion - 330.2mm - 90° Ends.0001.ipt]
2021-10-02 13in^3 Drive Train with Motors
    [10 Tooth #25 D-Shaft Sprocket - 4 Pack.ipt, 10 Tooth #25 Sprocket - 4 Pack.0001.ipt, 10 Tooth #25 Sprocket - 4 Pack.ipt, 13 in^3 drivetrain.0003.iam, 13 in^3 drivetrain.0006.iam, 13 in^3 drivetrain.iam, 26 Tooth #25 Sprocket - 4 Pack.ipt, 5202 Series Yellow Jacket planetary Gear Motor Mount.0005.ipt]
2021-10-03 V2 5202 Yellow Jacket Motor mount
    [13 in^3 drivetrain.0006.iam, 13 in^3 drivetrain.0007.iam, 13 in^3 drivetrain.iam, 15mm Extrusion - 330.2mm - 90° Ends.0001.ipt, 15mm Extrusion - 330.2mm - 90° Ends.ipt, V2 5202 Series Yellow Jacket planetary Gear Motor Mount.0002.ipt, V2 5202 Series Yellow Jacket planetary Gear Motor Mount.ipt, V2 5202 Series Yellow Jacket planetary Gear Motor Mount.stl]
2021-10-03 Inside Brackets on the drive train
    [13 in^3 drivetrain.0007.iam, 13 in^3 drivetrain.0008.iam, 13 in^3 drivetrain.iam, 15mm Plastic Inside Corner Bracket - 8 Pack.ipt, V2 5202 Series Yellow Jacket planetary Gear Motor Mount.0002.ipt, V2 5202 Series Yellow Jacket planetary Gear Motor Mount.0003.ipt, V2 5202 Series Yellow Jacket planetary Gear Motor Mount.ipt]
2021-10-03 Drivetrain
    starting drivetrain
    [Drivetrain.iam, am-4042a Barrier Pipe Anchor.STEP]
2021-10-05 Drivetrain Left side CAD
    back right wheel has been cadded
    [10 Tooth #25 D-Shaft Sprocket - 4 Pack.ipt, 10 Tooth #25 Sprocket - 4 Pack.ipt, 15mm Bearing Pillow Block - 8 Pack.0001.ipt, 15mm Bearing Pillow Block - 8 Pack.ipt, 15mm Extrusion - 420mm - 90° Ends - 4 Pack.ipt, 15mm Plastic Inside Corner Bracket - 8 Pack.ipt, 15mm Spacer - 12 Pack.ipt, 3mm Spacer - 16 Pack.ipt]
2021-10-07 Started replicating the drivetrain
2021-10-07 Finished the other side's drivetrain component.
    [Drivetrain.0005.iam, Drivetrain.iam]
2021-10-08 I finish the drivetrain component of the other side (for real this time)
    [Drivetrain.0005.iam]
2021-10-08 I made all of the components visible in the assembly.
    [Drivetrain.0011.iam]
2021-10-08 Made some Changes
    [Drivetrain.0012.iam, Slim Shaft Collar - 10 Pack.0001.ipt, Slim Shaft Collar - 10 Pack.ipt]
2021-10-08 D-shaft 10 tooth sprocket
    [10 Tooth #25 D-Shaft Sprocket - 4 Pack.ipt, 10 Tooth #25 D-Shaft Sprocket - 4 Pack.stl]
2021-10-08 FRC Pit Hook
    [FRC Pit Hook.ipt, FRC Pit Hook.stl, FRC Pit Hookv2.stl, FRC Pit Hookv3.stl, FRC Pit Hookv4.stl]
2021-10-08 Added Shaft Collars
    [Drivetrain.0017.iam]
2021-10-09 Minor Fixes
    [Drivetrain.0017.iam]
2021-10-09 Created Gobilda Components
    GoBilda step files and custom hex pulley
    [3414 Series 5mm HTD Pitch Set Screw Pinion Timing Belt Pulley (8mm REX Bore, 16 Tooth) 3414-4008-0016.STEP, 3414 Series 5mm HTD Pitch Set Screw Pinion Timing Belt Pulley (8mm REX Bore, 16 Tooth) 3414-4008-0016.iam, 3414-4008-0016 body.ipt, 3414-4008-0016 ring.ipt, 3417 Series 5mm HTD Pitch Set Screw Pinion Timing Belt Pulley (8mm REX Bore, 24 Tooth) 3417-4008-0024.STEP, 5000-0001-0001 encoder cap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]
2021-10-09 Organization
    Izack don't convert I lied keep it as a .STEP and just save them individually in the same folder as the assembly.
    [#10-32 12in Button-head Socket Cap Screw - 100 Pack.ipt, #10-32 12in Flat-head Socket Cap Screw - 25 Pack.ipt, #10-32 38in Button-head Socket Cap Screw - 100 Pack.ipt, #10-32 Low Profile Nylon Lock Nut - 100 Pack.ipt, 1.25in Roller Endcap.ipt, 1.25in Roller Tubing - 3ft.ipt, 1.5mm Spacers - 28 Pack.ipt, 1in 120 Degree Bracket.ipt]
2021-10-10 Started Custom Motor Mount
    [5mm x 135mm Hex Shaft - 4 Pack.ipt, 5mm x 135mm Hex Shaft.ipt, 5mm x 90mm Hex Shaft - 4 Pack.0002.ipt, 5mm x 90mm Hex Shaft - 4 Pack.ipt, Custom GoBilda Yellow Jacket Motor Mount.0001.ipt, Custom GoBilda Yellow Jacket Motor Mount.ipt]
2021-10-10 Added Carousel
    [2in Wheel Intergrated 0375 HEX Hub.ipt, 4IN Compliant Wheel FINAL Overmold.ipt, Assembly2.0004.iam, Assembly2.iam, Carousel Base.ipt, Carousel.ipt, REV-21-1843.0002.ipt, REV-21-1843.STEP]
2021-10-10 Adding parts
    Showing zohair the world
    [Custom GoBilda Yellow Jacket Motor Mount.0001.ipt, Custom GoBilda Yellow Jacket Motor Mount.0002.ipt, Custom GoBilda Yellow Jacket Motor Mount.ipt, am-4538 4IN 5mm Hex Compliant Wheel.STEP]
2021-10-10 Started Replacing Carousel Components and Cleaned up Files
    [Assembly2.0008.iam, Assembly2.0009.iam, Assembly2.iam, Carousel.0001.ipt, Carousel.ipt, REV-21-1843.STEP, REV-21-1844.STEP, REV-41-1349.STEP]
2021-10-11 Fixed Bracket Constraints
    [15mm Extrusion - 120mm - 90° Ends - 2 Pack.ipt, 3mm Spacer - 16 Pack.ipt, Assembly2.0009.iam, Assembly2.0010.iam, Assembly2.iam, M3 Nyloc Nuts - 100 Pack.ipt, M3 x 8mm Hex Cap Screws - 100 Pack.0002.ipt, M3 x 8mm Hex Cap Screws - 100 Pack.ipt]
2021-10-11 Spinning Module Completion and File Clean-Up
    [2in Wheel Intergrated 0375 HEX Hub.ipt, 4IN Compliant Wheel FINAL Overmold.ipt, Assembly2.0010.iam, Assembly2.0012.iam, Assembly2.iam, Duck Carousel.iam, REV-21-1843.ipt, REV-21-1844.ipt]
2021-10-11 Removed Old Duck Carousel Assembly
    [Assembly2.iam]
2021-10-11 Finished Duck Carousel and Made Challenge Field Folder
    [Carousel Base.ipt, Carousel.ipt, Challenge Field.iam, Duck Carousel.0002.iam, Duck Carousel.iam, REV-41-1123.ipt, REV-41-1320.0001.ipt, REV-41-1320.ipt]
2021-10-20 Nothing really
    [75mm Mecanum Wheel - Left.iam, Part37.ipt]
2021-10-24 Finished Motor Mount
    Y'all finish it lmao
    [2806-0005-0006_91390A118.ipt, 3414 Series 5mm HTD Pitch Set Screw Pinion Timing Belt Pulley (8mm REX Bore, 16 Tooth) 3414-4008-0016.iam, 3414-4008-0016 body.ipt, 3414-4008-0016 ring.ipt, Custom GoBilda Yellow Jacket Motor Mount.0002.ipt, Custom GoBilda Yellow Jacket Motor Mount.0008.ipt, Custom GoBilda Yellow Jacket Motor Mount.ipt]
2021-11-02 Drivetrain Finished
    replicated drivetrain components to reflect full functionality
    Problems:
    - Misalignment (Motor and wheel)
2021-11-05 First Push Ryan
    Problem
    - misaligned right axle
2021-11-07 Updated Motor Mount, and Drivetrain
    [10 Tooth #25 D-Shaft Sprocket - 4 Pack.newVer.ipt, 10 Tooth #25 D-Shaft Sprocket - 4 Pack.stl, 13 in^3 drivetrain.0009.iam, 13 in^3 drivetrain.0011.iam, 13 in^3 drivetrain.iam, 15mm Extrusion - 13in - 90° Ends.0001.ipt, 15mm Extrusion - 13in - 90° Ends.ipt, 15mm Extrusion - 2.5in - 90° Ends.0001.ipt]
2021-11-07 right angle brackets
    [13 in^3 drivetrain.0011.iam, 13 in^3 drivetrain.0012.iam, 13 in^3 drivetrain.iam, Custom GoBilda Yellow Jacket Motor Mount.0008.ipt, Custom GoBilda Yellow Jacket Motor Mount.0009.ipt, Custom GoBilda Yellow Jacket Motor Mount.ipt, NeveRest 20 Orbital Mount.0001.ipt, NeveRest 20 Orbital Mount.0002.ipt]
2021-11-09 Adding Spacers :)
    [1.5mm Spacers - 28 Pack.ipt, 10 Tooth #25 Sprocket - 4 Pack.ipt, 13 in^3 drivetrain.0012.iam, 13 in^3 drivetrain.0013.iam, 13 in^3 drivetrain.iam, 3mm Spacer - 16 Pack.ipt, 75mm Mecanum Wheel Set.0002.iam, 75mm Mecanum Wheel Set.0003.iam]
2021-11-09 Create Inventory.xlsx
    Created Excelo Document
    [Inventory.xlsx]
2021-11-09 Spacer add :(
    [13 in^3 drivetrain.0013.iam, 13 in^3 drivetrain.iam]
2021-11-09 more stuff
    saved so andrew can open
    [13 in^3 drivetrain.0013.iam, 13 in^3 drivetrain.0015.iam, 13 in^3 drivetrain.iam]
2021-11-11 more spacers
    more spacers to other wheels
    [13 in^3 drivetrain.0015.iam, 13 in^3 drivetrain.0017.iam, 13 in^3 drivetrain.iam]
2021-11-11 jus lookin
    [13 in^3 drivetrain.0017.iam, 13 in^3 drivetrain.0018.iam, 13 in^3 drivetrain.iam]
2021-11-11 custom stuff
    [1.5mm Spacers - 28 Pack.ipt, 10 Tooth #25 Sprocket - 4 Pack.ipt, 15mm Extrusion - 100mm - 90° Ends.ipt, 15mm Extrusion - 150mm - 90° Ends.ipt, 15mm Extrusion - 1m - 90° Ends.0002.ipt, 15mm Extrusion - 1m - 90° Ends.ipt, 15mm Extrusion - 94.5mm - 90° Ends.ipt, 15mm Hex Hub v2.stl]
2021-11-29 Motor Mount Update
    Usability increased
    [Custom GoBilda Yellow Jacket Motor Mount.0012.ipt]
2021-12-02 Slightly improved neverest orbital mount
    [NeveRest 20 Orbital Mount v2.stl, NeveRest 20 Orbital Mount.0002.ipt, NeveRest 20 Orbital Mount.0003.ipt, NeveRest 20 Orbital Mount.ipt]
2021-12-02 Basic H-Drive Frame
    [15mm Bearing Pillow Block - 8 Pack.ipt, 15mm Bearing Pillow Block - 8 Pack_CPY.ipt, 15mm Bearing Pillow Block - 8 Pack_MIR.ipt, 15mm Bearing Pillow Block - 8 Pack_MIR_CPY.ipt, 15mm Extrusion - 1m - 90° Ends.ipt, 15mm Extrusion - 34.4mm - 90° Ends.0001.ipt, 15mm Extrusion - 34.4mm - 90° Ends.ipt, 15mm Extrusion - 420mm - 90° Ends.0001.ipt]
2021-12-02 Center motor mount
    [5202 Series Yellow Jacket planetary Gear Motor Mount.0005.ipt, 5202 Series Yellow Jacket planetary Gear Motor Mount.0006.ipt, 5202 Series Yellow Jacket planetary Gear Motor Mount.ipt, Drivetrain.0004.iam, Gobilda 1620 motor mount with motor.0002.iam, Gobilda 1620 motor mount with motor.iam, Gobilda 1620 motor mount.0001.ipt, Gobilda 1620 motor mount.ipt]
2021-12-03 Custom mounts
    [5202 Series Yellow Jacket planetary Gear Small Motor Mount.0003.ipt, 5202 Series Yellow Jacket planetary Gear Small Motor Mount.ipt, Custom Gears.0001.iam, Custom Gears.iam, Drivetrain.0004.iam, Drivetrain.0006.iam, Drivetrain.iam, Gobilda 1620 motor mount.0001.ipt]
2021-12-03 Custom gears
    [10 Tooth #25 D-Shaft Sprocket - 4 Pack.0001.ipt, 10 Tooth #25 D-Shaft Sprocket - 4 Pack.0003.ipt, 10 Tooth #25 D-Shaft Sprocket - 4 Pack.ipt, 10 Tooth #25 D-Shaft Sprocket - 4 Pack.newVer.ipt, 5202 Series Yellow Jacket planetary Gear Small Motor Mount.0003.ipt, 5202 Series Yellow Jacket planetary Gear Small Motor Mount.0004.ipt, 5202 Series Yellow Jacket planetary Gear Small Motor Mount.ipt, 5202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]
2021-12-04 Improved Center Drive Gears
    [Hearing Tooth Center Drive Gear Large.stl, Hearing Tooth Center Drive Gear Small.stl, Spur Gear13.ipt, Spur Gear22.ipt]
2021-12-05 H-Drivetrain V2
    After realizing that the middle omni-wheel may prevent us from making over the barrier, I added and additional wheel to prevent the robot from getting stuck.
    [1.5mm Spacers - 28 Pack.ipt, 10 Tooth #25 Sprocket - 4 Pack.ipt, 15mm Extrusion - 1m - 90° Ends.ipt, 15mm Extrusion - 34.4mm - 90° Ends.ipt, 15mm Extrusion - 420mm - 90° Ends.ipt, 15mm Extrusion - 420mm - 90° Ends_CPY.ipt, 15mm Extrusion - 7.5in - 90 Ends.ipt, 15mm Spacer - 12 Pack.ipt]
2021-12-05 Drivetrain Drawing
    [15mm Extrusion - 1m - 90° Ends.ipt, 15mm Extrusion - 34.4mm - 90° Ends.ipt, 15mm Extrusion - 420mm - 90° Ends.ipt, 15mm Extrusion - 420mm - 90° Ends_CPY.ipt, 15mm Extrusion - 7.5in - 90 Ends.ipt, 5202 Series Yellow Jacket planetary Gear Small Motor Mount.ipt, Custom Gears.iam, Gobilda 1620 motor mount with motor.iam]
2021-12-05 Drivetrain V2 Improvements
    [15mm Metal 90 Degree Bracket V2 - 8 Pack.ipt, 15mm Plastic Inside Corner Bracket - 8 Pack.ipt]
2021-12-07 Made Intake Assembly
    [15mm Bearing Pillow Block - 8 Pack.0002.ipt, 15mm Bearing Pillow Block - 8 Pack.ipt, 15mm Extrusion - 120mm - 90° Ends - 2 Pack.ipt, Custom GoBilda Yellow Jacket Motor Mount (Back).0017.ipt, Custom GoBilda Yellow Jacket Motor Mount (Back).ipt, Custom GoBilda Yellow Jacket Motor Mount (Front).ipt, Custom GoBilda Yellow Jacket Motor Mount.0009.ipt, Custom GoBilda Yellow Jacket Motor Mount.0012.ipt]
2021-12-10 Halfway done with the scuffed stuff
    Fixed file relationships and broken part files.
    [1.5mm Spacers - 28 Pack.ipt, 10 Tooth #25 D-Shaft Sprocket - 4 Pack.ipt, 10 Tooth #25 Sprocket - 4 Pack.ipt, 15mm Bearing Pillow Block - 8 Pack.ipt, 15mm Bearing Pillow Block - 8 Pack_CPY.ipt, 15mm Bearing Pillow Block - 8 Pack_MIR.ipt, 15mm Bearing Pillow Block - 8 Pack_MIR_CPY.ipt, 15mm Bearing Pillow Block.ipt]
2021-12-14 More Fixing.
    [5mm x 135mm Hex Shaft.0003.ipt, 5mm x 135mm Hex Shaft.ipt, Assembly8.0009.iam, Wheel Assembly (Left).0008.iam, Wheel Assembly (Left).iam, Wheel Assembly (Right).0008.iam, Wheel Assembly (Right).iam, Wheel Assembly.0007.iam]
2021-12-15 Fixed Independent Drivetrain Assembly
    [15mm Extrusion - 420mm - 90° Ends.0001.ipt, 15mm Extrusion - 420mm - 90° Ends.ipt, Motor Assembly (Left).0011.iam, Motor Assembly (Left).0012.iam, Motor Assembly (Left).iam, Motor Assembly (Right).0004.iam, Motor Assembly (Right).0005.iam, Motor Assembly (Right).iam]
2022-01-07 Gaming
    Gaming
    [15mm Extrusion - 120mm - 90° Ends - 2 Pack.0001.ipt, 15mm Extrusion - 120mm - 90° Ends - 2 Pack.ipt, Duck Carousel.0002.iam, Duck Carousel.0003.iam, Duck Carousel.iam]
2022-01-09 carasoul stuff
    [15mm Extrusion - 120mm - 90° Ends - 2 Pack.ipt, 3mm Spacer - 16 Pack.ipt, Assembly2.0012.iam, Carousel.0001.ipt, Duck Carousel.0002.iam, Duck Carousel.iam, M3 Nyloc Nuts - 100 Pack.ipt, M3 x 8mm Hex Cap Screws - 100 Pack.0002.ipt]
2022-01-10 Big red carousel finsihed
    im so tired
    [15mm Extrusion - 120mm - 90° Ends - 2 Pack.0001.ipt, 15mm Extrusion - 120mm - 90° Ends - 2 Pack.0002.ipt, 15mm Extrusion - 120mm - 90° Ends - 2 Pack.ipt, Ducky caro.0001.iam, Ducky caro.iam]
2022-01-10 Drivetrain Drawings
2022-01-12 Intake Beginning
    [Input _Ring.ipt, Intake.0001.iam, Intake.iam]
2022-01-13 Battery holdr :)
    [Battery.0001.ipt, Battery.ipt]
2022-01-14 Intake Ring Screw Size Update
    [Input _Ring.0001.ipt, Input _Ring.ipt]
2022-01-17 Updated Duck Carousel
    [15mm Extrusion - 75mm - 90° Ends - 2 Pack - Copy.0002.ipt, 15mm Extrusion - 75mm - 90° Ends - 2 Pack.ipt, Duck Carousel.0004.iam, Duck Carousel.iam]
2022-01-17 Updated Drivetrain
    [15mm Extrusion - 150mm - 90° Ends.0003.ipt, 15mm Extrusion - 150mm - 90° Ends.ipt, 15mm Extrusion - 420mm - 90° Ends.0002.ipt, 15mm Extrusion - 420mm - 90° Ends.ipt]
2022-01-18 45 degree brackets
    [45 degree angle bracket.ipt, 45 degree angle bracket.stl, 45 degree inside coner bracket.ipt, 45 degree inside coner bracket.stl]
2022-01-18 Linear slide organization
    [45 degree inside angle bracket.ipt, 45 degree inside angle bracket.stl, Cascading Lift.iam, Continuous Lift.iam, Pulley.ipt, Pulley.stl, Spool.stl]
2022-01-18 bearing bushings
    [45 degree inside angle bracket left.ipt, 45 degree inside angle bracket left.stl, 45 degree inside angle bracket.0002.ipt, 45 degree inside angle bracket.ipt, 45 degree inside angle bracket.stl, Bearing Bushing.ipt, Bearing Bushing.stl]
2022-01-19 Drivetrain and Intake Revisions
    File organization improvements and pruning, drivetrain CAD optimization and improvements, and intake revisions
    [15mm Bearing Pillow Block.ipt, 15mm Extrusion - 150mm - 90° Ends.ipt, 15mm Extrusion - 420mm - 90° Ends.0001.ipt, 15mm Extrusion - 420mm - 90° Ends.0002.ipt, 15mm Extrusion - 420mm - 90° Ends.0004.ipt, 15mm Extrusion - 420mm - 90° Ends.ipt, 15mm Spacer.ipt, 2806-0005-0006_91390A118.ipt]
2022-01-19 Elastic horizontal roller intake
    [15mm Extrusion - 420mm.0003.ipt, 15mm Extrusion - 420mm.ipt, 15mm Hex Hub.0001.ipt, 15mm Hex Hub.0003.ipt, 15mm Hex Hub.ipt, 15mm Hex Hub.stl, 2in 5mm Hex Stealth Wheel.0002.iam, 2in 5mm Hex Stealth Wheel.iam]
2022-01-20 horizontal roller update
    [15mm Extrusion - 100mm.0001.ipt, 15mm Extrusion - 100mm.ipt, 15mm Hex Hub.ipt, 2in 5mm Hex Stealth Wheel.0002.iam, 2in 5mm Hex Stealth Wheel.0003.iam, 2in 5mm Hex Stealth Wheel.iam, 5mm x 100mm Hex Shaft - 4 Pack.ipt, Bearing Bushing.0001.ipt]
2022-01-20 Input Ring to Hex Shaft
    changed to hex shaft input rings
    [Input _Ring.0003.ipt, Input _Ring.0005.ipt, Input _Ring.ipt]
2022-01-25 elastic roller that is too big
    [15mm Bearing Pillow Block - 8 Pack.ipt, Pulley because david hates it.0002.ipt, Pulley because david hates it.ipt, Pulley because david hates it.stl, Pulley because david still hates it.ipt, Pulley because david still hates it.stl, Through Bore Bearing - Long - 12 Pack.ipt, Through Bore Bearing - Short - 12 Pack.ipt]
2022-01-25 Basic capstones for both teams
    [Big Red Basic Capstone.ipt, Robovikings Basic Capstone.0001.ipt, Robovikings Basic Capstone.ipt]
2022-01-26 Side motor mount for big red
    [Gobilda 1620 side motor mount.0002.ipt, Gobilda 1620 side motor mount.0003.ipt, Gobilda 1620 side motor mount.ipt, Gobilda 1620 side motor mount.stl]
2022-01-31 Custom Linear Slide Version 1
    [1.5mm Spacers - 28 Pack.ipt, 10 Tooth #25 Sprocket - 4 Pack.ipt, 15mm Bearing Pillow Block - 8 Pack.ipt, 15mm Extrusion - 319.3mm - 90° Ends.0001.ipt, 15mm Extrusion - 319.3mm - 90° Ends.ipt, 15mm Extrusion - 420mm - 90° Ends.0002.ipt, 15mm Extrusion - 420mm - 90° Ends.ipt, 15mm Plastic Inside Corner Bracket - 8 Pack.ipt]
2022-02-02 Cool Changes
    File Cleanup
    [1.5mm Spacers - 28 Pack.ipt, 10 Tooth #25 D-Shaft Sprocket - 4 Pack.stl, 10 Tooth #25 Sprocket - 4 Pack.ipt, 15mm Bearing Pillow Block - 8 Pack.ipt, 15mm Bearing Pillow Block - 8 Pack_CPY.ipt, 15mm Bearing Pillow Block - 8 Pack_MIR.ipt, 15mm Bearing Pillow Block - 8 Pack_MIR_CPY.ipt, 15mm Extrusion - 120mm - 90° Ends - 2 Pack.ipt]
2022-02-04 Bad Intake parts
    [Bad Intake Bracket v2.0001.ipt, Bad Intake Bracket v2.ipt, Stationary Bracket.0003.ipt, Stationary Bracket.0004.ipt, Stationary Bracket.ipt, Stationary bracket V2.0002.ipt, Stationary bracket V2.ipt, Stationary bracket V2.stl]
